BogoslavskiM/okp/АУДИТ_ПРАВОК_ВО.md

# Аудит правок чертежа общего вида

Актуальный отдельный файл: `Чертёж_общего_вида/Чертёж_общего_вида_А1_полный_аудит.pdf`. Исходные пользовательские PDF, STEP и `ТСЧ.docx` не перезаписывались.

## Исправлено

- На одном листе используются разные буквы: А–А, Б–Б, В–В, Д–Д, Е–Е и вид Г.
- Зубчатое колесо поз. 32 убрано из Б–Б; над разрезом дано указание «Зубчатое колесо поз. 32 не показано».
- Д–Д выполнен через второй микропереключатель; разрез опоры рейки сохранён отдельно как Е–Е.
- Посадка `⌀7H7/h6` в Е–Е показана двусторонней размерной линией через цилиндр.
- На В–В убран отдельный тонкий контур, похожий на «сбежавшую резьбу»; зубчатая часть показана единым симметричным контуром.
- На боковом виде точная проекция всех зубьев разрезного выходного колеса заменена условным изображением по ГОСТ 2.402: оставлены контур поверхности выступов, стык половин и тонкие штрихпунктирные образующие начальной поверхности. Чёрная полоса из наложившихся зубьев устранена.
- На Б–Б гайка М8 не заштрихована, а наружная резьба вала показана непрерывными основной и тонкими линиями в зоне свинчивания.
- На Б–Б два наружных стопорных кольца показаны как две пары симметричных отдельно заштрихованных сечений. Каждая верхняя и нижняя площадка относится к одному кольцу, установленному в канавке вала.
- На Б–Б точные торцевые проекции пружин, образовывавшие нечитаемое наложение витков, заменены отдельными сечениями проволоки по ГОСТ 2.401.
- На Б–Б соседний винт М2 показан целиком и условно, без наложения геометрии пружины на головку и резьбовой стержень.
- На Б–Б восстановлена полная штриховка верхней площадки реечной направляющей: общий ребёрный контур STEP делил материал на соприкасающиеся петли и оставлял большую часть площадки белой.
- Обозначения секущей плоскости В–В на А–А вынесены вверх и вниз за механизм, чтобы буквы и стрелки не перекрывали зубья и пружины.
- Наконечники всех стрелок секущих плоскостей А–А, Б–Б, В–В, Д–Д и Е–Е заканчиваются точно на толстом конечном штрихе и не выступают за него.
- На виде Г верхняя буква «Д» вынесена из-под контура детали; положение секущей плоскости Д–Д не изменено.
- Полки поз. 29, 23, 30, 24 и 40 повёрнуты влево вместе с текстом. Полка поз. 41 также направлена влево.
- Выносные линии размеров 40, 127,6 и 256,1 начинаются непосредственно от видимого контура без воздушного зазора.
- Осевые линии приведены к одному начертанию и толщине; короткие перекрестия в центрах зубчатых колёс заменены полноценными осями.
- Основная надпись сохранена в стиле остальных документов проекта.

## Несоответствия исходных данных, которые не исправлялись молча

- В STEP стоят два кольца `A9.50 ХГА ГОСТ 13940-86`; в существующем `ТСЧ.docx` поз. 9 — `Кольцо A6.50 ХГА ГОСТ 13940-86`, 2 шт. Геометрия вала соответствует канавке под А9,5. На чертеже кольцам не присвоена новая позиция.
- В STEP есть гайка `М8-6H ГОСТ 5929-70`; в существующем `ТСЧ.docx` такой детали нет: поз. 8 содержит гайку М6. На ВО гайке М8 не присвоена чужая позиция; поз. 22 остаётся валом VI.
- STEP содержит физическое наложение винта и соседних деталей. На ВО исправлено только его условное изображение; исходная 3D-модель не менялась.
- Позиции на ВО связаны с существующим `ТСЧ.docx`. Нумерация сборочного чертежа редуктора сюда не переносилась, поскольку это другой состав изделия.
- Эта нумерация не совпадает с нумерацией структурной схемы. Например, в `ТСЧ.docx` поз. 11 — подшипник, поз. 22 — вал VI, поз. 45 — крышка выходного вала; в структурной схеме те же номера относятся соответственно к кольцу А9,5, штифту 2×12 и крышке II вала. Смешивать две системы позиций на одном ВО нельзя.
- Количества и типы подшипников тоже расходятся: `ТСЧ.docx` содержит 1000093 — 9 шт. и 1000096 — 1 шт.; STEP содержит 1000093 — 8 шт., 4А-1000007 — 1 шт. и 4А-1000009 — 1 шт.
- Фраза «Зубчатое колесо поз. 32 не показано» относится к нумерации `ТСЧ.docx`. В структурной схеме поз. 32 — гайка М3×0,35.

## Что проверить перед печатью

- Согласовать с преподавателем/нормоконтролем, что в ТСЧ должно быть кольцо А9,5, и добавить в ТСЧ гайку М8 либо привести 3D-модель к утверждённому составу.
- Открыть актуальный PDF и печатать на А1 в масштабе 100 %, без автоматической подгонки.
