BogoslavskiM/okp/ВАЛЫ_ПРИВОДА.md

# Валы привода: от двигателя к рейке

Порядок подтверждён кинематической цепью проекта и сборочной STEP-моделью. Всего шесть вращающихся валов с учётом вала двигателя. Обозначения Z1…Z12 — обозначения элементов передачи, а не номера позиций ТСЧ.

| Вал | Что находится на валу | Откуда получает и куда передаёт движение |
|---|---|---|
| **I — вал двигателя ДПР-42** | Шестерня **Z1**, шпонка, гайка М3×0,35. Собственные опоры вала находятся внутри двигателя. | Двигатель → Z1 → Z2. |
| **II — вал-шестерня Z3** | Колесо **Z2**, шестерня **Z3**, выполненная заодно с валом; два подшипника. | Z2 принимает движение от Z1; Z3 передаёт его колесу Z4. |
| **III — вал-шестерня Z5** | Колесо **Z4**, шестерня **Z5**, выполненная заодно с валом; два подшипника. Опоры размещены в стакане. | Z4 принимает движение от Z3; Z5 передаёт его колесу Z6. |
| **IV — вал-шестерня Z7** | Колесо **Z6**, шестерня **Z7**, выполненная заодно с валом; два подшипника. | Z6 принимает движение от Z5; Z7 передаёт его колесу Z8. |
| **V — вал-шестерня Z9, узел муфты** | Колесо **Z8**; втулка, полумуфты, нажимная пружина, регулировочная гайка и стопорный винт муфты; шпонка; шестерня **Z9**, выполненная заодно с валом; два подшипника. | Z8 получает движение от Z7 и передаёт момент через муфту на вал-шестерню Z9. При перегрузке муфта допускает проскальзывание. Z9 приводит колесо Z10. |
| **VI — выходной вал** | Колесо **Z10 с ЛВК из четырёх пружин**, реечное колесо **Z11 с ЛВК из двух пружин**, два подшипника; штифт, шпонка, стопорное кольцо и концевая гайка крепления элементов выходного узла. | Z10 получает движение от Z9. Z11 превращает вращение в поступательное движение рейки Z12. |

Пять вращательных ступеней: **Z1–Z2 → Z3–Z4 → Z5–Z6 → Z7–Z8 → Z9–Z10**. Затем **Z11–Z12** — реечная передача.

**Z2 и Z3 расположены на одном валу; Z4 и Z5 — на одном; Z6 и Z7 — на одном; Z8 и Z9 связаны через муфту; Z10 и Z11 находятся на выходном валу.**

Крышки подшипников и стакан закреплены в корпусе: их не следует перечислять как детали, вращающиеся вместе с валом. Рейка Z12 — выходное поступательно движущееся звено, а не седьмой вал.
