BogoslavskiM/okp/ПОДГОТОВКА_К_ЗАЩИТЕ_ОКП.md

# Подготовка к защите ОКП: план проекта, ЛВК и муфта

Проект: **следящий привод возвратно-поступательного движения**, РЛ5. Основа разбора — предоставленные чертежи, `ТСЧ.docx` и визуально просмотренная записка [«КП рассчет.pdf»](<КП рассчет.pdf>). Номера страниц ниже — страницы этого PDF, с первой страницы файла. Посадки оставлены как напоминание; основной разбор посвящён принципам работы и расчётам ЛВК и муфты.

Это конспект для понимания и подготовки ответов. Пересчёт всей конструкции и исправление расчётного PDF здесь не выполнены. Числа из записки прямо отделены от перепроверенных результатов. «Когда делали» означает порядок проектирования и зависимости между этапами: календарную историю работы по файлам восстановить нельзя.

## 1. Что повторить перед защитой

Из присланных рассказов повторяются следующие темы. Примерно 30 минут, презентация и видео — опыт одной защиты, а не установленный регламент. Вопросы могут задавать каждому участнику; расчёты тоже нужно понимать, даже если другую команду по ним не спрашивали.

| Тема | Что достаточно восстановить в памяти |
|---|---|
| Работа привода | Путь движения от двигателя до рейки; назначение редуктора, датчика, концевиков, муфты и ЛВК. |
| Посадки | Что соединяется, требуется ли относительное движение, откуда взято поле допуска покупной детали и как выбрано поле сопрягаемой. Уметь изобразить два поля относительно нуля. |
| Подшипники | Какие кольца вращаются относительно нагрузки, как фиксируются кольца и как обеспечивается осевая работоспособность узла. |
| Чертежи | Назначение СБ, ГЧ, К3, структурной схемы; направление взгляда для каждого вида; смысл разрезов и увеличенных изображений. |
| Размеры и биения | Показать конкретную поверхность или ось; объяснить функциональное назначение ограничения и способ контроля. |
| Технология | Как получить основные поверхности валов, зубья, шпоночные пазы, отверстия корпуса; чем обусловлены скругления. |
| Сборка | Какие узлы собираются отдельно, как собираются ЛВК, как регулируется муфта и проверяется свободное движение рейки. |
| Расчёты | Для каждого: исходные данные → проверяемое свойство → результат → принятое конструктивное решение. |

Удобная форма ответа: **«Это …; нужно для …; выбрано потому, что …; проверяем по …»**. Начинай с назначения, затем показывай конкретное место на своём чертеже.

### Короткие ответы на остальные вопросы из переписки

- **Для чего ГЧ?** Чтобы установить изделие в другую конструкцию: он показывает внешний контур, занимаемое пространство, установочные и присоединительные размеры. **СБ** нужен для сборки и контроля сборочной единицы; **ВО** объясняет конструкцию и взаимодействие частей. Это разные задачи документов. [ГОСТ Р 2.102–2023, пп. 4.2.5–4.2.8](https://meganorm.ru/Data/816/81642.pdf).
- **Какие размеры показать у себя?** `256,1 max` — пример габарита при указанном положении подвижных частей; три отверстия `⌀4` на окружности `⌀86` — крепёжный рисунок; `⌀2 N8` на конце рейки относится к выходному присоединению. Для каждого размера показывай обе границы измерения. Одно `N8` ещё не задаёт посадку: нужно поле допуска ответной детали.
- **Что означает ±0,1?** Отклонения составляют −0,1 и +0,1 мм, полный допуск — 0,2 мм. Само число не объясняет, почему его назначили: это определяется требованиями к сопряжению и размерной цепи. На твоём чертеже у размера `5` дважды стоит `+0,2`: это одинаковые предельные размеры, а не запись ±0,2; значение нужно уточнить по замыслу.
- **Вид, разрез, сечение?** Вид показывает обращённые к наблюдателю поверхности; сечение — фигуру в секущей плоскости; разрез также показывает то, что находится за ней. Вынесенный вид читается по стрелке с его буквой. У тебя вид А получается взглядом со стороны выходного конца вдоль оси привода. Увеличение `4:1` помогает показать мелкие сопряжения, численные размеры при этом остаются действительными. [ГОСТ 2.305–2008](https://files.stroyinf.ru/Data/479/47928.pdf).
- **Почему разные значения биения?** Они ограничивают разные функциональные ошибки: посадочная поверхность, зубчатый венец и свободная поверхность имеют разную значимость для работы. Радиальное биение контролируют при вращении относительно заданной базы; это не допуск диаметра. Для идеальной круглой, но эксцентричной поверхности полный размах показаний равен `2e`; при наличии ошибок формы такая упрощённая трактовка уже недостаточна. Вопрос надо привязывать к конкретной рамке допуска и базе. [ГОСТ 24642–81](https://files.stroyinf.ru/Data/221/22152.pdf).
- **Откуда посадка первой шестерни на двигателе?** Размер и допуск покупного вала берутся из документации двигателя, поле отверстия шестерни выбирает конструктор. На с. 10 твоей записки приведён выходной вал ДПР-42 `⌀3 f6`. Это исходное ограничение, но не готовая посадка и не автоматическое указание назначить зазор. Посадка по диаметру и сопряжения шпонки с пазами решаются отдельно.
- **H7/m6 и L0/l0?** H7/m6 — пример переходной посадки; классификацию доказывают взаимным положением полей, а не словами «плотно садится». У `H` нижнее отклонение равно нулю, у `h` верхнее равно нулю. В обозначениях подшипников `L0` относится к среднему диаметру отверстия внутреннего кольца, `l0` — к среднему наружному диаметру; 0 — класс точности подшипника, не квалитет IT0. [ГОСТ 25346–2013](https://rosgosts.ru/17/040/gost_25346-2013), [ГОСТ 3325–85, п. 1.1](https://files.stroyinf.ru/Data2/1/4294824/4294824611.pdf).
- **Подшипник: на вал с натягом, в корпус с зазором?** Для вращающегося вала при нагрузке, неподвижной относительно корпуса, это распространённая схема. Основание — нагрузка перемещается по окружности внутреннего кольца, поэтому нужно предотвратить его проворачивание на посадке. Утверждать, что так делают всегда, нельзя: учитывают нагрузки, температуру, материал корпуса и осевую схему. [SKF: условия вращения и нагружения](https://cdn.skfmediahub.skf.com/api/public/0901d1968024f02a/pdf_preview_medium/0901d1968024f02a_pdf_preview_medium.pdf).
- **Зачем втулка скольжения?** Направляет движущуюся деталь, воспринимает поперечную нагрузку и образует пригодную для трения пару. В твоём Б–Б показано сопряжение рейки `⌀7 H7/h6`. Нужно различать внутреннее сопряжение с подвижной рейкой и наружное крепление втулки в опоре. H7/h6 допускает минимальный зазор 0: само обозначение не доказывает гарантированного свободного скольжения при любых условиях.
- **Что удерживает рейку от проворота?** На Б–Б, «2 места», концы винтов входят в продольный паз рейки. Паз позволяет осевое перемещение и ограничивает вращение. Винт должен направлять, а не зажимать рейку в дно паза. Это видно и на восстановленном сборочном чертеже.
- **Почему шпоночный паз скруглён?** Закруглённый закрытый конец паза на валу обычно получается при работе концевой фрезы: форма связана с диаметром инструмента. Не путать его с малыми радиусами в поперечном сечении. Паз в ступице может изготавливаться другим способом, например долблением или протягиванием; все пазы не обязаны иметь одинаковую форму концов.
- **Как изготовить основные детали?** Для единичного производства объясняй маршрут: вал — точение, получение зубьев/пазов, необходимая термообработка, окончательная обработка точных шеек; колесо — заготовка, базовое отверстие и торцы, нарезание зубьев, требуемая окончательная обработка; корпус — заготовка, обработка баз, связанных отверстий под опоры и резьб. Конкретный материал и маршрут нужно подтвердить своими чертежами деталей: это возможные способы, а не установленный факт изготовления.
- **Какие виды изделий?** Деталь, сборочная единица, комплекс, комплект. «Покупное» и «собственной разработки» — другая классификация. Покупной двигатель одновременно является сборочной единицей. В твоей ТСЧ к покупным отнесены двигатель, подшипники, крепёж, шпонка, штифты, микропереключатели; валы, колёса, корпус и рейка — в разделе вновь разрабатываемых. [ГОСТ Р 2.101–2023, пп. 4.4, 4.6](https://files.stroyinf.ru/Data/816/81640.pdf).
- **«Структурная схема для разборки»?** Для сборки нужно видеть вхождение деталей в узлы, а узлов — в привод, и возможность отдельно собрать выделенные узлы. Стрелки направляют к изделию вышестоящего уровня. Это не замена подробному технологическому маршруту сборки. [ГОСТ Р 2.711–2023, п. 5.3](https://meganorm.ru/Data/816/81671.pdf).
- **Технические требования?** Свяжи каждый пункт с проверкой: ход — перемещение между установленными пределами; усилие и скорость — работа под заданной нагрузкой; точность — оговорённая выходная погрешность; концевики — отключение перед механическим упором; хранение и транспортирование — сохранность изделия. `УХЛ4.1` означает исполнение для умеренного и холодного климата с эксплуатацией в помещениях с кондиционированным или частично кондиционированным воздухом. IP44 задаёт защиту от доступа проволокой/твёрдых предметов размером 1 мм и более и от брызг с любого направления. Наличие этих обозначений в ТЗ не доказывает, что конструкция уже прошла необходимые проверки. [ГОСТ 15150–69](https://files.stroyinf.ru/Data2/1/4294852/4294852592.htm), [ГОСТ 14254–2015](https://base.garant.ru/71653666/).

## 2. Весь проект: что, когда и зачем рассчитывали

### Как описать привод за минуту

По ТЗ требуется перемещать нагрузку 1 кг с сопротивлением 8 Н, скоростью 0,03 м/с, ускорением 1 м/с² и ходом 60 мм. Вращение двигателя ДПР42-01 понижается пятью цилиндрическими зубчатыми парами и через реечную передачу превращается в поступательное движение. Муфта ограничивает передаваемый момент при перегрузке. ЛВК уменьшают мёртвый ход при реверсе. Рейка движется в направляющих и удерживается от проворота пазом с винтами. На кинематической схеме также предусмотрены датчик линейного перемещения, концевые выключатели и механические упоры.

«Следящий» означает наличие обратной связи: измеренное положение сравнивается с заданным и по ошибке формируется воздействие на двигатель. Один двигатель с редуктором сам по себе следящую систему не образует; алгоритм управления нельзя считать разработанным только по механической схеме.

### Последовательность и смысл каждого блока записки

| Этап и страницы PDF | Что делали и зачем | Что получилось / что нужно уметь объяснить |
|---|---|---|
| 1. ТЗ, с. 3 | Собрали требования: нагрузка, скорость, ускорение, ход, точность, ограничения конструкции. | Это критерии всех следующих проверок. В ТЗ допустимая погрешность **30′**, а не 25′. |
| 2. Мощность, с. 4 | Оценили механическую мощность `P=(F+ma)v`, затем учли КПД и запас. | На выходе 0,27 Вт; при предварительном КПД 0,42 — около 0,64 Вт на входе; с коэффициентом 4 — 2,56 Вт. Запас и КПД нужно обосновать, это разные множители. |
| 3. Предварительный двигатель, с. 4–6 | Сравнили доступные исполнения, затем проверили способность разогнать механизм. | ДПР42-02 прошёл по мощности, но по записке не прошёл пуск: 0,022 Н·м меньше потребных примерно 0,0275 Н·м. |
| 4. Повторный выбор, с. 7–9 | После замены двигателя пересчитали кинематику и приведённые нагрузки. | ДПР42-01: 27 В, 9000 об/мин, номинальный момент 0,005 Н·м, пусковой 0,036 Н·м, номинальная механическая мощность около 4,71 Вт. Первая пусковая проверка даёт лишь небольшой запас. |
| 5. Общее передаточное отношение, с. 5, 7 | Из скорости рейки получили скорость выходного колеса: `ωвых=v/r`; затем `i=ωдв/ωвых`. | При делительном диаметре 45 мм: `r=0,0225 м`, `ωвых≈1,333 рад/с`, `i≈706,858`. Повтор расчёта связан с заменой двигателя. |
| 6. Приведение моментов и инерций, с. 5–8 | Перенесли нагрузку к валу двигателя. Статический момент связан с сопротивлением, динамический — с разгоном всех масс. | `Mст,дв≈Mвых/(iη)`, `Jнагрузки=m r²`, `Jпр≈Jдв+Jред,пр+Jнагрузки/i²`, `Mдин=Jпр εдв`, `εдв=i εвых`. Большое i уменьшает приведённую инерцию нагрузки, но увеличивает нужное ускорение ротора. |
| 7. Габариты двигателя, с. 10–11 | Выбрали конструктивное исполнение, посадочные и крепёжные размеры. | Покупной двигатель задаёт геометрию сопряжения, в том числе вал ⌀3 f6. Далее проектируем ответные детали. |
| 8. Ступени и зубья, с. 12–13 | Разбили большое i на пять приемлемых ступеней с учётом компактности; подобрали целые числа зубьев. | Шестерни 1, 3, 5, 7, 9: по 19 зубьев; колёса 2, 4, 6, 8, 10: 67, 68, 69, 70, 80. После округления пересчитываем фактическое i и скорость. |
| 9. Моменты по валам, с. 14 и далее | От выходной нагрузки с учётом потерь определили нагружение каждой ступени. | В записке для VI принято 382,5 Н·мм, для V — 93,62 Н·мм, затем 26,09; 7,37; 2,11; 0,61 Н·мм. Это расчётная цепочка, а не каталог номинальных моментов двигателя. |
| 10. Материал, модуль, ширина, с. 14–23 | По допускаемому напряжению изгиба зуба нашли минимальный модуль; затем выбрали реализуемый размер и ширину венцов. | Приняты модули 0,35; 0,3; 0,3; 0,3; 0,35 мм. Маленький модуль может проходить по прочности, но не оставлять стенку у отверстия/паза. Материалы в расчёте: шестерни 40Х, колёса сталь 55. |
| 11. Геометрия колёс, с. 14–23 | По m и z определили делительные, наружные и впадинные диаметры, ширины. | `d=mz`; для принятого профиля вычисляются остальные диаметры. Геометрия задаёт межосевые расстояния, компоновку и силы в зацеплениях. |
| 12. Контактная прочность, с. 24 | Проверили контактные напряжения рабочих поверхностей зубьев. | Изгиб отвечает за опасность разрушения зуба у основания, контактная проверка — за работоспособность его поверхности. Прохождение одной не заменяет другую. |
| 13. Уточнение КПД, инерций и двигателя, с. 25–28 | Когда размеры колёс известны, оценили их инерции, реальные потери и повторили динамическую проверку. | Для дисковой оценки `J=πρbd⁴/32`; к двигателю инерция приводится делением на квадрат накопленного i. Полученный КПД зацеплений около 0,821 не следует автоматически считать КПД всего привода. В результате динамической проверки есть ошибка единиц — см. раздел 5. |
| 14. Валы по жёсткости, с. 29–40 | Ограничили закручивание валов. | `φ=T l/(G Jp)`, для сплошного круга `Jp=πd⁴/32`. Жёсткость сильно растёт с диаметром; достаточная прочность ещё не обеспечивает точность. |
| 15. Валы по прочности, с. 29–40 | Из моментов нашли `Ft=2T/d`, `Fr=Ft·tan α`; определили реакции опор, построили эпюры в двух плоскостях, сложили изгиб и кручение. | Проверяются наиболее нагруженные сечения. Для прямозубой цилиндрической пары идеализированная осевая составляющая от зацепления равна нулю. Реальный диаметр также зависит от посадок и компоновки. |
| 16. Прогиб вала, с. 40–41 | Оценили поперечную деформацию и её влияние на зацепление. | Использованы единичная нагрузка и интеграл Мора/перемножение эпюр. В записке суммарный прогиб около 0,000154 мм сравнивается с 0,02485 мм. Это другая проверка, чем угол кручения. |
| 17. Опоры, с. 41–49 | По реакциям нашли эквивалентную нагрузку и требуемую динамическую грузоподъёмность подшипников. | Для шарикового подшипника базовая зависимость `L10h=10⁶/(60n)·(C/P)³`. Здесь n — частота именно этого вала. Затем проверяются размеры, схема фиксации и остальные условия применения. |
| 18. Точность, с. 50–58 | Сложили приведённые к выходу ошибки изготовления/монтажа, люфтовую и упругую составляющие. | Исходный итог в записке около 42′ — выше 30′ из ТЗ. Поздние ступени особенно значимы: их ошибки почти не уменьшаются последующим редуцированием. |
| 19. Улучшение точности, с. 58 | Выбрали меры против разных причин ошибки. | ЛВК на последней цилиндрической и реечной передачах уменьшают люфт; увеличение выходного вала с 6 до 9 мм уменьшает закручивание. Это два разных решения. Итоговые числа в записке расходятся. |
| 20. ЛВК, с. 59–65 | Из требуемого момента предварительного поджатия получили усилия пружин, затем их деформации, жёсткость, витки и габариты; повторили контактную проверку. | Два ЛВК: реечное колесо №11 с двумя пружинами и колесо №10 с четырьмя. Подробно — следующий раздел. |
| 21. Муфта, с. 66–69 | Выбрали ограничиваемый момент, прижим, пружину и размеры фрикционного контакта; проверили давление и передаваемый момент. | Сначала нужно знать момент на валу установки и режим защиты. Именно этот исходный выбор в записке требует исправления. |
| 22. Конструкция и документация | По результатам компонуем узлы, назначаем сопряжения, определяем сборку, создаём чертежи и согласуем состав. | После добавления ЛВК и муфты возвращаемся к нагрузкам, потерям, габаритам и точности. Расчёт и конструкция уточняются совместно. |

Опорная фраза: **«Сначала обеспечили движение и нагрузочную способность, затем проверили точность; по её результатам добавили ЛВК и увеличили жёсткость выходного вала. Муфта решает отдельную задачу защиты от перегрузки».**

## 3. ЛВК: что происходит физически

### 3.1. Почему возникает мёртвый ход

В обычном зацеплении между неработающими боковыми поверхностями зубьев есть боковой зазор. Пока привод вращается в одну сторону, нагрузку передают одни стороны зубьев. После реверса сначала выбирается зазор до контакта противоположных сторон; вход уже повернулся, а выход ещё не начал соответствующее движение. Для следящего привода это ухудшает позиционирование при смене направления.

Люфтовыбирающее колесо состоит из двух соосных зубчатых частей, между которыми допускается небольшой относительный поворот. Пружины создают противоположно направленные моменты: одна часть прижата к одной стороне зубьев ответного колеса или рейки, вторая — к противоположной. При достаточном поджатии свободный ход при реверсе уменьшается. Такой принцип двух подпружиненных частей применяют и серийные изготовители. [KG Stock Gears: устройство anti-backlash spur gears](https://www.kggear.co.jp/en/kg-stock-gears/anti-backlash-spur-gears).

**Пружина должна быть предварительно деформирована.** Если собрать части в свободном положении без нужного поджатия, расчётный момент не появится. Важны направление относительного поворота, рабочая длина пружины и возможность подвижной части поворачиваться: затяжкой осевого крепежа нельзя случайно зажать её намертво.

В твоём проекте ЛВК предусмотрены на колесе **№10** последней цилиндрической пары и колесе **№11**, работающем с рейкой. Они воздействуют на зазоры соответствующих зацеплений. Ошибки шага, биение, закручивание валов и люфты остальных ступеней при этом не исчезают.

### 3.2. Почему нельзя просто поставить очень сильные пружины

Два требования противодействуют друг другу:

- момент поджатия должен сохранять нужный контакт при рабочем моменте и его изменении;
- лишний преднатяг увеличивает внутренние контактные нагрузки, трение, износ и потребный момент двигателя.

В записке выбрано `Mпред=2T`. Это принятый коэффициент запаса, а не универсальное требование ГОСТ для любого ЛВК. Его нужно связывать с максимальным рабочим моментом, реверсом, изменением усилия пружин и геометрией данного механизма.

При росте внешнего момента одна ветвь контакта догружается, другая разгружается. Если разгружаемый контакт исчезает, способность выбирать люфт в этом режиме теряется. Поэтому фраза «поставили пружины — люфта больше нет» слишком сильная.

### 3.3. Логика твоего расчёта ЛВК

Обозначения ниже немного упорядочены: `N` — число пружин, `q` — число зубьев монтажного смещения, `n` — рабочие витки одной пружины. В записке буква n применяется в разных смыслах.

**Шаг 1. Взять момент на валу этого колеса.** Для обоих ЛВК в записке используется `T=382,5 Н·мм`, поскольку оба относятся к выходному валу VI. Выбранный момент поджатия `Mпред=2T=765 Н·мм`.

**Шаг 2. Задать расположение пружин и монтажный поворот.** В расчётной геометрии A — положение пружины относительно центра колеса, L — исходная длина, θ — половина взаимного угла поворота частей:

```text
φ = 360°·q/z
θ = φ/2
A₁ = A·cos θ − (L/2)·sin θ
```

`A₁` — действующее плечо силы после поворота. Оно изменяется, поскольку линия действия пружины перемещается. «Смещение на два зуба» здесь задаёт монтажный поворот для создания преднатяга, а не величину рабочего люфта в два зуба.

**Шаг 3. Разделить нужный момент между пружинами.** Для принятого симметричного расположения:

```text
Mпред = N·P·A₁
P = Mпред/(N·A₁)
```

Это обычное равновесие моментов: сила каждой пружины умножается на её плечо. Если конструкция размещает пружины иначе, нужно заново получить плечи и сумму моментов.

**Шаг 4. Из геометрии получить удлинение.** В использованной в записке схеме:

```text
Δl = L·cos θ + 2A·sin θ − L
```

После этого нужна пружина, которая при таком удлинении создаёт найденную силу: `k=P/Δl`. Это упрощение предполагает отсутствие начального натяжения. Для пружины растяжения с начальным натяжением закон имеет вид `P=P₀+kΔl`; тогда P₀ тоже надо учитывать. Также L в геометрии и свободная длина реальной пружины между точками крепления должны быть согласованы.

**Шаг 5. Выбрать проволоку, диаметр витка и число витков.** В записке выбирается строка таблицы с допустимым усилием, диаметром проволоки, наружным диаметром пружины и жёсткостью одного витка `c₁`. Затем `n=c₁/k`. Больше одинаковых рабочих витков — более мягкая пружина. После округления n необходимо заново вычислить действительную силу, а не оставлять прежнюю.

**Шаг 6. Проверить размещение и прочность.** Нужны место для пружины с зацепами во всём рабочем диапазоне, отсутствие столкновений и заклинивания, прочность зацепов и зубьев, достаточная ширина частей колеса. Условие «полная длина меньше диаметра впадин» само по себе ещё не доказывает размещение в конкретной прорези.

### 3.4. Два твоих ЛВК: откуда получились числа

| Параметр | Колесо №11, реечная передача | Колесо №10, последняя цилиндрическая пара |
|---|---:|---:|
| Число зубьев z | 90 | 80 |
| Число пружин N | 2 | 4 |
| A; L | 12; 20 мм | 9,5; 12 мм |
| Монтажное смещение q | 2 зуба | 2 зуба |
| Половина угла θ | 4° | 4,5° |
| Действующее плечо A₁ | ≈11,273 мм | ≈9,000 мм |
| Требуемая сила одной пружины | ≈33,93 Н | ≈21,25 Н |
| Принятая табличная сила при максимальной деформации | 40 Н | 25 Н |
| Проволока; наружный диаметр | 0,8; 5 мм | 0,6; 3,4 мм |
| Жёсткость одного витка c₁ | 54,24 Н/мм | 57,92 Н/мм |

Почему четыре пружины у №10: в записке прямо указано, что при двух или трёх требуемые более сильные пружины не помещаются. Четыре пружины распределяют момент и снижают требуемую силу каждой. Само увеличение количества не отменяет проверку места и прочности.

**У колеса №11** геометрия даёт `Δl≈1,6254 мм`, откуда `k≈20,875 Н/мм`, `n≈2,598`, принято 3 рабочих витка. После такого округления фактическая жёсткость по той же модели — `54,24/3=18,08 Н/мм`. При том же удлинении сила около **29,39 Н**, а момент поджатия около **662,6 Н·мм**, то есть **1,73T**, а не 2T. Это ещё может соответствовать принятому диапазону запаса, но вывод должен опираться на пересчитанный результат.

**У колеса №10 есть конкретная ошибка на с. 64:** перед этим получено θ=4,5°, а удлинение вычисляется с **8°**. Поэтому записанные `Δl=2,52751 мм`, `k=8,40752 Н/мм` и 7 витков не согласованы с собственной исходной геометрией.

При θ=4,5° и остальных неизменных исходных данных:

```text
Δl = 12 cos 4,5° + 19 sin 4,5° − 12 ≈ 1,45373 мм
k = 21,2501/1,45373 ≈ 14,62 Н/мм
n = 57,92/14,62 ≈ 3,96
```

То есть эта расчётная модель приводит примерно к **4**, а не 7 виткам. Если оставить 7 при той же геометрии и без начального натяжения, момент получится около **433 Н·мм ≈1,13T**. Это проверка согласованности формул, **не готовое предписание заменить пружину**: сначала необходимо согласовать длину между зацепами, начальное натяжение и реальную конструкцию.

### 3.5. Как объяснить сборку ЛВК

На уровне принципа: установить две соосные части, обеспечить предусмотренную относительную подвижность, закрепить пружины, повернуть части в направлении создания заданного преднатяга, удержать их при вводе в зацепление, зафиксировать осевое положение без блокирования нужного относительного поворота. Затем проверить свободное движение и реверс под оговорённой нагрузкой.

На защите нужно показать, **какая часть связана с валом, какая подвижна, за что зацеплены пружины и чем удерживается осевое положение**. Конкретный порядок установки крепежа определяется сборочной моделью; из одной расчётной схемы его нельзя достоверно назначить.

### 3.6. Готовый ответ про ЛВК

«При реверсе обычная передача сначала выбирает боковой зазор. У нас колесо разделено на две подпружиненные части, которые поджаты к противоположным сторонам зубьев ответной детали. Расчёт начинается с момента поджатия, затем через число пружин и их плечи получаем усилия. По монтажному повороту определяем удлинение, после чего выбираем жёсткость и число витков. После округления витков проверяем действительный преднатяг и размещение. ЛВК уменьшает люфтовую составляющую, но не устраняет ошибки изготовления и упругие деформации».

## 4. Муфта: принцип и расчёт

### 4.1. Сначала нужно установить, какая муфта действительно спроектирована

В ТЗ и формулах на с. 66–69 — **фрикционная предохранительная муфта**. На кинематической схеме подпись — **«шариковая предохранительная муфта»**. Иллюстрация на с. 68 тоже требует проверки по конструкции: название под рисунком само по себе не подтверждает, что момент передаётся рассчитанными фрикционными поверхностями.

Дальнейший разбор относится к **фрикционному принципу, который рассчитан в записке**. Для шариковой муфты нужны геометрия углублений/рабочих поверхностей и силы выхода шариков; формула фрикционного диска не описывает этот механизм.

### 4.2. Как работает фрикционная предохранительная муфта

Есть ведущая и ведомая части и прижатые друг к другу рабочие поверхности. Пружина создаёт нормальную силу. Пока требуемый момент меньше предельного момента трения, поверхности не скользят друг относительно друга и передают движение совместно. При перегрузке начинается относительное проскальзывание, которое ограничивает передаваемый момент. Регулировка сжатия пружины меняет порог. [Mach III: принцип механического фрикционного ограничителя момента](https://www.machiii.com/resources/how-our-products-work/how-it-works-mechanical-friction-torque-limiter/).

**Муфта не обязана полностью разомкнуться и передать нулевой момент.** При проскальзывании она продолжает передавать момент трения и выделяет тепло. Поэтому упор нельзя использовать как штатный способ остановки с длительно буксующей муфтой. Концевики должны обеспечивать нормальную остановку, а муфта — ограничение перегрузки при нарушении нормального режима.

Что делают детали в общем случае:

| Элемент | Назначение |
|---|---|
| Ведущая и ведомая части | Связаны с соответствующими звеньями привода и передают момент до и после фрикционного контакта. |
| Фрикционные поверхности/накладки | Создают ограниченный силой прижатия момент трения. |
| Нажимная деталь | Передаёт осевое усилие пружины на контакт. |
| Пружина | Создаёт прижим и допускает его изменение при регулировке и износе. |
| Регулировочная гайка или другой механизм | Задаёт установленную длину пружины, следовательно, силу и момент срабатывания. |
| Стопорение регулировки | Сохраняет настройку при работе. |
| Опорные и центрирующие элементы | Обеспечивают взаимное положение частей и возможность предусмотренного относительного вращения. |

Это функциональное объяснение. Номера деталей следует брать из чертежа именно твоей муфты, а не присваивать по типовой картинке.

### 4.3. Первый расчёт — выбрать момент в месте установки

Правильная последовательность:

```text
нагрузка на рейке
→ момент на выходном валу
→ момент на валу установки муфты
→ допустимое окно срабатывания
→ необходимый прижим
→ пружина и контактные поверхности
```

Нужно обеспечить, с учётом разброса настройки:

```text
максимальный нормальный рабочий момент
< момент срабатывания
< момент, опасный для защищаемых деталей
```

Все три величины приводятся к **одному валу**. Если момент известен после редукции, при приведении назад учитываются передаточное отношение, направление передачи мощности и потери. Нельзя сравнивать число с вала двигателя с числом на выходе без приведения.

**В твоей записке:** взято `Mдв=0,036 Н·м`, умножено на 1,8 и получено `Mмуфты=64,8 Н·мм`. Но 0,036 Н·м — **пусковой** момент двигателя, а на кинематической схеме муфта стоит на **валу V**, между колесом №8 и шестернёй №9. Для V в расчётной цепочке записано **93,62 Н·мм**, что уже больше выбранного порога 64,8 Н·мм.

Это не доказательство, что привод проскальзывает при любой обычной нагрузке: расчётные режимы и запасы ещё нужно согласовать. Но выбранный порог **не обоснован для принятого в записке расчётного момента в месте установки**. Начинать исправление следует отсюда, иначе точный подбор пружины будет обслуживать неверное исходное условие.

### 4.4. От момента к силе прижатия

Используется модель:

```text
M = μ·F·Rср·z
```

`μ` — коэффициент трения выбранной пары поверхностей; `F` — нормальная сила прижатия; `Rср` — эффективный радиус трения; `z` — число работающих поверхностей трения, **не число зубьев**.

Физический смысл: трение даёт окружную силу `μF`, её плечо даёт момент, несколько рабочих контактов суммируют моменты. При последовательном осевом сжатии пакета одинаковая сила F проходит через контакты; множитель z нельзя одновременно повторно учитывать в самой F.

В записке приняты `μ=0,25`, `Rср=6 мм`, `z=2`:

```text
F = 64,8/(0,25·6·2) = 21,6 Н → принято 22 Н
M при F=22 Н = 0,25·22·6·2 = 66 Н·мм = 0,066 Н·м
```

Это арифметически согласовано с выбранными 64,8 Н·мм. **На с. 69 результат ошибочно записан как 66 Н·м — разница в 1000 раз.**

Числа μ=0,25 и z=2 нужно объяснить по реальному контакту: из каких материалов поверхности, сухие они или смазываемые и где именно находятся обе поверхности трения. Указать произвольное μ без материала недостаточно.

### 4.5. Зачем рассчитывают кольцо и давление

В записке внутренний диаметр кольца 8 мм, наружный 16 мм, ширина 4 мм. Использована оценка `Rср=(D+d)/4=6 мм`, соответствующая модели равномерного износа кольцевого контакта. При иной модели распределения давления эффективный радиус определяется иначе; это допущение, а не геометрическое тождество для любого фрикционного контакта.

```text
A = π(D²−d²)/4 ≈ 150,8 мм²
pср = F/A ≈ 22/150,8 ≈ 0,146 МПа
```

Эта проверка отвечает на вопрос, не слишком ли велика нагрузка на поверхность. В записке допускается 0,3–0,6 МПа, но допустимое значение должно соответствовать материалу и условиям работы. Среднее давление само по себе не проверяет местные концентрации, нагрев и ресурс при буксовании.

Почему нельзя просто увеличить площадь и считать момент пропорционально выросшим: при неизменных F, μ и эффективном радиусе площадь напрямую в формулу момента не входит. Она уменьшает среднее давление; увеличение наружного диаметра дополнительно меняет радиус трения.

### 4.6. Зачем пружине три силы P₁, P₂, P₃

На с. 66 приняты:

```text
P₁ = 22 Н
P₂ = 1,5P₁ = 33 Н
P₃ = P₂/(1−0,05) ≈ 34,74 Н
```

Это попытка задать диапазон рабочих усилий и запас до предельной деформации. Но пружина в собранной муфте создаёт **одну силу, определяемую установленной длиной**. Нельзя одновременно считать порог по 22 Н и установить сжатие, дающее 33 Н, не изменив порог:

```text
при 22 Н: M ≈ 66 Н·мм
при 33 Н: M ≈ 99 Н·мм
```

Поэтому нужно указать длину пружины при настройке, соответствующий момент и допускаемое изменение при износе. Износ фрикционных деталей может изменить установленную длину и прижим; фраза «коэффициент 1,5 компенсирует износ» без этой связи недостаточна.

### 4.7. Что означает каждый шаг расчёта пружины муфты

1. **Материал и допускаемое напряжение.** В записке — 65Г, `[τ]=583,3 МПа`. Это ограничение напряжений проволоки; состояние материала и допустимый режим должны соответствовать принятому справочному значению.
2. **Индекс пружины `C=Dср/d=6`.** Связывает средний диаметр витка с толщиной проволоки. Нельзя подставлять наружный диаметр вместо среднего.
3. **Коэффициент кривизны.** Учитывает, что напряжение в изогнутой проволоке выше простой оценки прямого стержня. В записке `kτ≈1,238`.
4. **Диаметр проволоки.** Подбирается по максимальной расчётной силе, чтобы не превысить допускаемое напряжение. При осевом сжатии цилиндрической винтовой пружины её проволока работает преимущественно на **кручение**, а не просто на осевое сжатие.
5. **Средний диаметр.** После принятия `d=1,2 мм` получается `Dср=7,2 мм`; наружный диаметр тогда 8,4 мм, внутренний 6 мм. Это нужно для размещения в корпусе или на направляющей.
6. **Податливость одного витка.** `λ=8C³/(Gd)≈0,0173 мм/Н`. Податливость показывает, насколько удлиняется/укорачивается один активный виток на единицу силы. Жёсткость — обратная величина; у нескольких витков податливости складываются.
7. **Число рабочих витков.** По заданному перемещению между двумя нагрузками: `n=Δs/[λ(P₂−P₁)]`. Для 2 мм между 22 и 33 Н получается около 10,5, принято 11.
8. **Полное число витков.** Добавлены опорные витки: `nпол=13`. Рабочие витки определяют упругую характеристику, полное число — ещё и габариты.
9. **Длины и предельное сжатие.** В записке получены высота сомкнутых витков 15,6 мм и свободная длина 22,21 мм. Нужно проверить установленную длину, запас между витками при максимальной рабочей нагрузке и отсутствие потери устойчивости. Совпадение максимальной рабочей деформации с полным смыканием витков требует пересмотра.

**Ошибка формулы на с. 67:** при заданном безразмерном C под корнем стоят величины с размерностью мм², но напечатан кубический корень. Для классической модели `τ≈k·8FDср/(πd³)` подстановка `Dср=Cd` даёт **квадратный** корень по d. Кроме того, напечатанное выражение с коэффициентом 1,6 и кубическим корнем не даёт указанного результата 1,12 мм. Нужно проверить и степень корня, и коэффициент выбранной методики. Принятые 1,2 мм нельзя объявить неверными только по этой опечатке: их следует проверить обратной подстановкой в корректную формулу.

### 4.8. Как регулируют и проверяют такую муфту

Собирают фактический пакет рабочих поверхностей и пружину; регулировкой задают её установленную длину; измеряют момент начала относительного проворота в оговорённых условиях; фиксируют регулировку и проверяют повторяемость. При необходимости проверяют оба направления вращения и нагрев при допустимом кратковременном проскальзывании. Конкретный способ приложения и измерения момента выбирается по доступу к узлу.

Проверка только свободной длины пружины не подтверждает настройку муфты: момент зависит также от её установленного сжатия, трения, контактного радиуса и количества поверхностей.

### 4.9. Готовый ответ про муфту

«Предохранительная фрикционная муфта ограничивает момент при перегрузке. Пружина прижимает рабочие поверхности; до порога они передают движение без взаимного скольжения, выше порога начинают проскальзывать. Сначала выбираем момент срабатывания на валу установки: выше нормального рабочего и ниже опасного для защищаемых деталей. Затем по коэффициенту трения, радиусу и числу контактов находим прижим, под него выбираем пружину и проверяем давление. Настройка определяется установленным сжатием пружины и проверяется измерением момента».

## 5. Что нельзя заучивать из записки без исправления

| Где | Что обнаружено | Почему это существенно |
|---|---|---|
| К3 и с. 66–69 | Шариковая муфта на схеме, фрикционная в ТЗ и формулах. | Разные принципы передачи и ограничения момента; сначала согласовать реальную конструкцию. |
| С. 66 | Порог муфты рассчитан от пускового момента двигателя, хотя она на V валу. | Требуется согласовать режим и привести моменты к месту установки. |
| С. 69 | 66 Н·м вместо 66 Н·мм. | Ошибка единиц в 1000 раз. |
| С. 67–68 | Несогласованные корень, коэффициент и результат диаметра проволоки; максимальная расчётная деформация доведена до высоты сомкнутых витков. | Нужна проверка прочности и рабочего запаса хода пружины. |
| С. 62–64 | Для ЛВК №10 половина угла 4,5°, затем в формуле 8°. | Меняются удлинение, жёсткость, число витков и реальный преднатяг. |
| С. 61, 64–65 | После округления рабочих витков сила не пересчитана; длины геометрической модели и пружины с зацепами не согласованы явно. | Нельзя считать расчётный момент поджатия обеспеченным по одной исходной формуле. На с. 61 также `4,4+2·5` не равно 15,2. |
| С. 13 | Фактическое i считается с округлёнными промежуточными отношениями. | По целым зубьям произведение равно **710,97254**, отличие от требуемого около **0,582%**; при 9000 об/мин скорость рейки около **0,029826 м/с**. Это отличие скорости, не угловая погрешность передачи в минутах. |
| С. 24, 65 | Межосевое расстояние 18,025 мм получено из наружных диаметров. | Для пары 9–10 без смещения профилей из делительных диаметров получается **17,325 мм**; именно это значение встречается далее в записке. Требуется единая геометрия и соответствующая проверка. |
| С. 27–28 | Динамический момент из SI-величин около **0,0198 Н·м**, но подписан 0,02 Н·мм. | При добавлении к 3,6 Н·мм получается около **23,4 Н·мм**, а не 3,62. Сравнение с 5 Н·мм номинального момента больше не проходит. С пусковыми 36 Н·мм сравнивается пуск, а возможность заданного разгона во всём диапазоне проверяется по характеристике двигателя. |
| С. 27 | Для колеса №10 дисковая формула с указанными размерами даёт `J≈1,326·10⁻⁶ кг·м²`, написано `1,33·10⁻⁷`. | Ещё одна степень десяти; уточнить итоговую приведённую инерцию. Это не отменяет уже найденной ошибки единиц момента. |
| С. 41–49 и ТСЧ | При проверке разных валов используется 9000 об/мин; марки подшипников в таблице и ТСЧ расходятся. | Частота VI вала по зубьям около 12,66 об/мин. В ТСЧ указаны 1000093 и 1000096; на с. 49 для VI — 1000007 и 1000009. Нужен один согласованный состав. |
| С. 50, 59, К3 | Разные m/z реечной передачи и число зубьев рейки. | На с. 59 колесо 90 зубьев, m=0,5; на с. 50 встречается m=1 и 45 зубьев. Для рейки на К3 — 58, в расчёте — 80. Согласовать с моделью и длиной рабочего участка. |
| С. 57–58 | Несколько различных итогов погрешности; используется предел 25′ при 30′ в ТЗ. | Прямая сумма приведённых на с. 58 составляющих `16,74046+4,4749+2,88682≈24,10218′`. Это исправление сложения, не подтверждение всего расчёта точности: нужно проверить исходные составляющие и охват реечной передачи. |

Эти замечания не требуют учить дополнительные десятки формул. Для защиты важнее понимать, **какое свойство проверял каждый расчёт, какие допущения приняты и какое изменение конструкции из него следует**. Но ошибки в типе муфты, моменте, единицах и угле ЛВК лучше устранить до защиты, а не пытаться защищать их как верные результаты.

## 6. Порядок подготовки без повторного изучения всего курса

1. **15–20 минут — восстановить конструкцию.** Открыть К3 и СБ, пройти путь движения, показать V и VI валы, оба ЛВК, муфту, рейку, её паз, датчик и концевики.
2. **20–30 минут — пройти таблицу расчётов из раздела 2.** Для каждого этапа вслух назвать входные данные, смысл проверки и конструктивный результат. Формулы вспоминать по необходимости.
3. **30–40 минут — ЛВК, с. 58–65.** Нарисовать две соосные части от руки, объяснить реверс и предварительное поджатие; пройти цепочку «момент → плечо и сила → удлинение → жёсткость → витки → повторная проверка».
4. **30–40 минут — муфта, с. 66–69.** Установить реальный тип; объяснить путь момента и прижима; пройти цепочку «порог на своём валу → нормальная сила → пружина → давление → настройка и контроль».
5. **10–15 минут — посадки и чертежи по памяти.** Пройти краткие вопросы первого раздела. Если ответ вспоминается, дальше тему не углублять.
6. **15 минут — прогон в команде.** Каждый объясняет весь привод и оба специальных узла, затем отвечает на два уточнения: «почему именно так?» и «что изменится, если увеличить этот параметр?».

Пять вопросов, которые полезно задать себе в конце:

- Почему более толстый вал помог точности, хотя старый мог проходить по прочности?
- Почему добавление ЛВК требует повторно учитывать нагрузки и потери?
- Почему семь витков вместо четырёх меняют усилие, даже если проволока та же?
- Почему пружина на 33 Н не соответствует моменту муфты, рассчитанному по 22 Н?
- Почему 0,036 Н·м на двигателе нельзя непосредственно использовать как рабочий момент муфты на V валу?
