BogoslavskiM/okp/СПИСОК_ИСПРАВЛЕНИЙ_ОКП.md

# Список исправлений курсового проекта по ОКП, РЛ5

Проект: **«Следящий привод возвратно-поступательного движения»**.

Чек-лист составлен по визуальной проверке предоставленных PDF, проверке свойств добавленных CDW, пособиям МГТУ и указанным ниже стандартам. CDW в КОМПАСе не открывались и не редактировались; замечания к изображениям необходимо сверить с их последним состоянием в КОМПАСе. Это проверка оформления и согласованности комплекта, а не полный повторный расчёт конструкции.

## 1. Обозначения и основные надписи — исправить во всём комплекте

- [ ] По принятому решению использовать для привода обозначение **`РЛ5.00.00.00.00`**: первую числовую группу после РЛ5 заменить на `00` во всём комплекте. Это выбранное обозначение проекта, а не подтверждённый номер темы задания.
- [ ] Заменить заглушки `БИГЕ.XXXXXXXX…` на принятые обозначения. Заглушки сохранились и в свойствах добавленных сборочного и габаритного CDW.
- [ ] Заполнить обозначения структурной и кинематической схем.
- [ ] В основной надписи указывать **название изделия и ниже название документа**. Код СБ, ГЧ, К3 или Е1 в обозначении не заменяет название документа.
- [ ] Проверить совпадение обозначений в основной надписи, дополнительной графе и разделе «Документация» спецификации.

| Документ на привод в целом | Обозначение | Название документа под названием изделия |
|---|---|---|
| Сборочный чертёж | `РЛ5.00.00.00.00 СБ` | Сборочный чертёж |
| Габаритный чертёж | `РЛ5.00.00.00.00 ГЧ` | Габаритный чертёж |
| Кинематическая схема | `РЛ5.00.00.00.00 К3` | Схема кинематическая принципиальная |
| Структурная схема | `РЛ5.00.00.00.00 Е1` | Структурная схема |
| Спецификация привода | `РЛ5.00.00.00.00` | В основной надписи — название изделия, без «Сборочный чертёж» |
| Чертёж общего вида, если входит в комплект | `РЛ5.00.00.00.00 ВО` | Чертёж общего вида |

**Не присваивать обозначение целого привода всем узлам и деталям.** Например, если за редуктором закреплено `РЛ5.00.01.00.00`, его сборочный чертёж имеет обозначение `РЛ5.00.01.00.00 СБ`, а спецификация — `РЛ5.00.01.00.00`.

По решению автора сохранено исходное название **«Структурная схема»**, как в образце пособия МГТУ 2012 года, с. 13, рис. П1.6; код — **Е1**. То же название указано в разделе «Документация» спецификации. Ранее предложенное название «Схема деления структурная» соответствует терминологии ГОСТ 2.701–2008, п. 4.4, но его замена в данном курсовом проекте не была прямым требованием преподавателя. В образце пособия 2022 года, с. 29, рис. П1.13, используется ещё один вариант — «Схема сборки», также с кодом Е1.

## 2. Структурная схема — исправить направление стрелок

Файл для сверки: `структурная_схема.pdf`. Исходный CDW этой схемы среди добавленных файлов отсутствует.

- [ ] Найти исходник структурной схемы для редактирования.
- [ ] Направить стрелки **от деталей к узлам, от узлов к готовому приводу**. Сейчас на PDF они направлены от изделия к его составным частям.
- [ ] Исправить направление на всех уровнях, включая связи внутри ветвей отдельных валов и двигателя в сборе.
- [ ] Готовый привод можно оставить сверху: переставлять все блоки только ради направления стрелок не требуется.
- [ ] Проверить, что выделенные сборочные единицы действительно можно собирать отдельно и что вложенность соответствует принятому порядку сборки.
- [ ] Заполнить обозначения собственных узлов и деталей. Для покупных изделий использовать их маркировки, для стандартных — обозначения по соответствующим стандартам.
- [ ] Проверить включение датчика Axis-M и его крепления: на кинематической схеме датчик есть, на просмотренной структурной схеме он не найден.
- [ ] Заполнить основную надпись по разделу 1.

Правильная логика связей:

```text
Двигатель + шестерня + гайка → двигатель в сборе
Детали валов → валы в сборе
Корпус + валы в сборе + крышки + крепёж → редуктор в сборе
Собранные узлы + остальные составные части → привод
```

**Стрелки не удалять:** ГОСТ Р 2.711–2023, п. 5.3, требует направлять их к изделию или составной части вышестоящего уровня. Это прямое основание для исправления замечания преподавателя «для разборки».

## 3. Сборочный чертёж привода

Исходник: добавленный CDW «Сборочный чертёж привод сдв 3»; визуальная проверка выполнена по `сборочный_чертеж.pdf`.

- [ ] Добавить под названием привода строку **«Сборочный чертёж»**.
- [ ] Указать обозначение `РЛ5.00.00.00.00 СБ` и убрать заглушку.
- [ ] Проверить соответствие всех позиций своей спецификации: на этом листе показан привод целиком, двигатель и редуктор входят в него как узлы.
- [ ] Проверить обозначения разрезов **Б–Б и Г–Г**. На просмотренном PDF соответствующие обозначения секущих плоскостей не найдены; буква Б также используется для направления взгляда. Обеспечить однозначное соответствие изображений и их обозначений.
- [ ] Проверить размер **5 с верхним и нижним отклонениями +0,2**. На PDF оба отклонения одинаковые. Назначить требуемые отклонения по смыслу сопряжения, не заменять автоматически на ±0,2.
- [ ] Проверить технические требования к сборке и контролю. Сейчас на PDF присутствует только примечание о справочных размерах. При необходимости указать регулировку упоров и микровыключателей, проверку свободного хода и другие требования, относящиеся к последнему этапу сборки привода.
- [ ] Проверить примечание «*Размеры для справок»: справочные размеры должны быть обозначены согласованно с ним.

Уточнение к замечанию «сборочный чертёж чего?»: для этого листа объект — **следящий привод возвратно-поступательного движения целиком**. Отдельный чертёж редуктора должен иметь название редуктора и собственное обозначение.

## 4. Габаритный чертёж — исправить текст условий

Исходник: добавленный CDW «Габаритный чертёж сдв 3»; визуальная проверка выполнена по `габаритный_чертеж.pdf`.

- [ ] Добавить строку **«Габаритный чертёж»** в основную надпись.
- [ ] Указать обозначение `РЛ5.00.00.00.00 ГЧ` и убрать заглушку.
- [ ] Исправить пункт «Условия транспортировки: по группе Ж (жесткие) ГОСТ 15150». **Ж как группа механических воздействий при перевозке относится к ГОСТ 23216–78**. Климатические условия транспортирования задаются отдельно по ГОСТ 15150–69.
- [ ] Проверить обоснованность выбора именно группы Ж. Не оставлять её только потому, что она уже вписана.
- [ ] Заменить неопределённое «условия хранения: 3 или 4» на конкретный выбранный режим либо явно описать условия применения каждого режима.
- [ ] Уточнить срок хранения/сохраняемости и необходимые условия упаковки и консервации для выбранного режима.
- [ ] Переработать фразу о защите «подвижных и внутренних штоков»: назвать реальные поверхности и детали данного привода, требующие консервации, и конкретизировать применяемый материал. Не распространять консервацию автоматически на фрикционные поверхности муфты и оптический датчик.
- [ ] Проверить отражение заданных **УХЛ 4.1 и IP44** в эксплуатационных требованиях. Это требования задания, а не подтверждение их выполнения конструкцией.
- [ ] Восстановить нумерацию пунктов: после 4 сейчас следует 6.
- [ ] Рекомендуется отделить технические характеристики от требований по транспортированию, хранению и консервации.
- [ ] Проверить тот же размер 5 с одинаковыми отклонениями +0,2, что и на сборочном чертеже.

Конкретные группы хранения и перевозки в этом чек-листе **не назначены**: их следует выбрать под принятые условия использования, упаковку и защиту изделия. УХЛ 4.1 само по себе не задаёт группу хранения или перевозки.

## 5. Кинематическая схема — согласовать с заданием и расчётом

Исходник: `Кинематическая схема.сдв.cdw`; визуальная проверка выполнена по `книемат_схема.pdf`.

- [ ] Заполнить обозначение `РЛ5.00.00.00.00 К3`.
- [ ] Сохранить полное название изделия и строку **«Схема кинематическая принципиальная»**.
- [ ] Устранить расхождение типа муфты: в задании и расчёте она **фрикционная**, на схеме подписана **шариковая**. Проверить также условное изображение и фактическую конструкцию. Одной замены подписи достаточно только при соответствии самой конструкции.
- [ ] Согласовать данные о погрешности: на схеме 25′, в задании и ГЧ 30′. Если 25′ — подтверждённый расчётом результат, явно отличить его от допустимой погрешности «не более 30′». Не менять результат на 30′ автоматически.
- [ ] Согласовать маркировку двигателя и датчика с остальными документами.

## 6. Спецификация и состав комплекта

`Спецификация привод.pdf` и `спецификация.pdf` полностью совпадают по содержимому файла. Второй PDF не является исправленной версией. Редактируемая спецификация SPW отдельно не предоставлена; проверить, ведётся ли она внутри сборочного CDW.

- [ ] Убрать **СБ** из обозначения самой спецификации привода; оставить `РЛ5.00.00.00.00`.
- [ ] Убрать слова **«Сборочный чертёж»** из наименования в её основной надписи.
- [ ] В разделе «Сборочные единицы» указать обозначение редуктора как изделия **без СБ**. Код СБ относится к его сборочному чертежу.
- [ ] Заполнить обозначения собственных деталей и сборочных единиц, где графы сейчас пустые.
- [ ] В разделе «Документация» привести ссылки к фактическим обозначениям чертежей и схем после их исправления.
- [ ] Добавить структурную схему Е1 в перечень документации, если она выпускается отдельным документом данного комплекта.
- [ ] Проверить наличие указанного в спецификации чертежа общего вида ВО: среди предоставленных PDF он отсутствует. Найти его либо уточнить фактический состав сдаваемого комплекта.
- [ ] Проверить включение датчика Axis-M и его крепления на соответствующем уровне спецификации. Если датчик внешний и не входит в изделие, явно отразить это в документах.
- [ ] Сверить состав и количества деталей между структурной схемой, спецификациями и таблицей составных частей в `ТСЧ.docx`.

**Не требовать одинаковых номеров позиций во всех таблицах:** позиции общего сборочного чертежа должны соответствовать именно его спецификации. Нумерация таблицы составных частей к чертежу общего вида может отличаться. Сопоставлять нужно наименования, обозначения, количество и уровень входимости.

## 7. Расчёт муфты — проверить до защиты

Файл: `КП рассчет.pdf`.

- [ ] **С. 69:** исправить единицы результата `11 × 6 = 66 Н·м`. При радиусе 6 мм результат равен **66 Н·мм = 0,066 Н·м**.
- [ ] На той же странице исправить единицы в последующем сравнении с 64,8: обе величины должны быть выражены в согласованных единицах.
- [ ] **С. 66:** проверить выбор момента срабатывания муфты. Расчёт использует момент двигателя, тогда как на кинематической схеме муфта расположена на валу V. Требуется проверить момент в месте её установки с учётом предшествующих передач и принятого режима работы.
- [ ] После проверки момента при необходимости пересчитать усилие пружины, параметры муфты и её регулировку; согласовать результат с конструкцией и чертежами.
- [ ] Убедиться, что расчёт, кинематическая схема, структурная схема и реальная модель описывают один и тот же тип муфты.

## 8. Проверка после исправлений

- [ ] Сохранить исправления в копиях исходных документов, чтобы сохранить исходную версию.
- [ ] Сформировать новые PDF именно из исправленных CDW и актуальной спецификации.
- [ ] Визуально проверить на новых PDF названия и обозначения, читаемость штампов, направление стрелок, обозначения разрезов и отсутствие наложений текста.
- [ ] Проверить совпадение всех ссылок на документы и позиций со спецификациями.
- [ ] Выделить один окончательный комплект для сдачи; исключить случайную отправку старых PDF.

## Источники

- [ГОСТ 2.701–2008](https://meganorm.ru/Data/479/47901.pdf), таблицы 1–2 и п. 4.4: виды, типы, названия и коды схем, в том числе Е1 и К3.
- [ГОСТ Р 2.711–2023](https://meganorm.ru/Data/816/81671.pdf), п. 4.3: код Е1; п. 5.3 и рис. 1: направление стрелок; приложение Б: образец основной надписи.
- [ГОСТ Р 2.102–2023](https://base.garant.ru/408167007/): виды и коды конструкторских документов.
- [ГОСТ 23216–78](https://www.elec.ru/library/gosts_e09/gost_23216-78.pdf), разделы 1–2: хранение и транспортирование, разграничение механических и климатических воздействий.
- [Пособие МГТУ 2022 года под редакцией В. А. Городничева](https://press.bmstu.ru/catalog/item/7706/reader/): с. 10 — структурная схема сборки и обозначения РЛ5; с. 11 — габаритный чертёж и требования; с. 29, рис. П1.13 — пример схемы с кодом Е1. Для онлайн-чтения нужна авторизация МГТУ.
- [Пособие МГТУ 2012 года, часть 2](https://press.bmstu.ru/catalog/item/125/reader/): с. 5 — схема сборки Е1; с. 13, рис. П1.6 — пример структурной схемы. Для онлайн-чтения нужна авторизация МГТУ.
- [Фрагмент основной надписи из пособия 2022 года](Проверка_ОКП/Штамп_схемы_из_пособия_2022.png).
