BogoslavskiM/okp/Исправленные_PDF/О_ПРАВКАХ.md

# Исправленные PDF проекта ОКП

Сохранены отдельные копии пяти документов. Исходные PDF в корне проекта не изменены.

| Файл | Внесённые изменения |
|---|---|
| Сборочный_чертёж_исправленный.pdf | Обозначение `РЛ5.00.00.00.00 СБ` в основной и дополнительной графах; полное название изделия и строка «Сборочный чертеж». |
| Габаритный_чертёж_исправленный.pdf | Обозначение `РЛ5.00.00.00.00 ГЧ` в обеих графах; полное название изделия и строка «Габаритный чертеж». |
| Кинематическая_схема_исправленная.pdf | Обозначение `РЛ5.00.00.00.00 К3` в обеих графах. |
| Структурная_схема_исправленная.pdf | Обозначение `РЛ5.00.00.00.00 Е1`, исходное название «Структурная схема»; стрелки направлены от составных частей к узлам и готовому приводу. Добавлены наконечники на входах общих ветвей в родительские блоки. |
| Спецификация_исправленная.pdf | Обозначение самой спецификации на обоих листах — `РЛ5.00.00.00.00`, без СБ; исправлено название в штампе; обновлены ссылки в разделе «Документация» и добавлена схема Е1; обозначение редуктора — `РЛ5.00.01.00.00`, без СБ. |

Для двух одинаковых исходных спецификаций (`спецификация.pdf` и `Спецификация привод.pdf`) выпущен один исправленный документ из двух страниц.

## Проверка

Визуально проверены новые надписи, таблица документации и стрелки. Сохранены количество и размеры страниц. Сравнение изображений всех шести страниц при ширине 1800 пикселей не выявило изменений за пределами областей правок. Векторные чертежи сохранены в PDF; растровая структурная схема исправлена локальными наложениями текста и линий.

После замечания о шрифтах исправлена избыточная переработка штампов. Для новых надписей использованы исходные версии ГОСТ-шрифтов соответствующих документов, восстановлен наклон букв по исходным PDF и исходная высота текста на векторных листах. На сборочном и габаритном чертежах первая строка названия сохранена без изменений; полное описание движения помещено во вторую строку с горизонтальным сжатием, третья отведена типу чертежа. В спецификации восстановлен исходный размер названия. На структурной схеме все три исходные строки названия сохранены целиком, включая «Структурная схема». Название на кинематической схеме сохранено целиком.

По последнему уточнению автора название «Структурная схема» восстановлено также в разделе «Документация» спецификации. Код Е1 и исправленные стрелки сохранены.

Сохранённые строки названий сравнены с оригиналами по пикселям при увеличении: совпадение полное. Изменений вне областей шрифтовых правок относительно предыдущих исправленных PDF не обнаружено; направление и геометрия стрелок сохранены. Актуальны пять PDF в этой папке. Предыдущая версия до правки шрифтов сохранена отдельно в `Проверка_ОКП/PDF_до_правки_шрифтов`.

## Что ещё требует исправления

Это правки непосредственно PDF. В CDW они не перенесены: при повторном экспорте из старых исходников потребуется повторить соответствующие изменения в КОМПАСе.

Остальные замечания из [списка исправлений](../СПИСОК_ИСПРАВЛЕНИЙ_ОКП.md) остаются актуальны: выбор условий хранения и перевозки, технические требования и их нумерация, размерные отклонения, обозначения разрезов, согласование типа муфты и погрешности, расчёт муфты, состав изделия и недостающие обозначения деталей. Ссылка на чертёж общего вида ВО в спецификации сохранена; самого чертежа среди предоставленных PDF нет.
