BogoslavskiM/okp/Проверка_ОКП/Правка_ГГ_по_скриншоту.md

В файле `Исправленные_PDF/Сборочный_чертёж_ГГ_по_указанным_местам.pdf` обозначение Г–Г перенесено к двум узлам крепления микропереключателей, обведённым пользователем на скриншоте. В каждом месте секущая плоскость проходит через оси двух крепёжных винтов. Прежние указатели Г у направляющей сняты. Указатели Б–Б, сами изображения сечений, размеры, позиции и основная надпись сохранены. Исходные графические потоки и шрифты не изменены.
