BogoslavskiM/okp/Проверка_ОКП/Правка_указателей_сборочного.md

Создан отдельный файл `Исправленные_PDF/Сборочный_чертёж_сечения_исправлены.pdf`.

- Убраны прежние буква Б и стрелка слева от бокового вида.
- На первом виде добавлены парные указатели Б–Б через опору рейки; направление — вдоль рейки.
- На первом виде обозначена горизонтальная секущая плоскость Г–Г через оси винтов крепления направляющей; направление взгляда — снизу.
- Сами изображения сечений, их подписи, размеры, позиции и основная надпись не менялись. Разрез В–В в эту правку не включён.
- Для новых букв использован исходный шрифт сборочного PDF. Исходный поток страницы и встроенные исходные шрифты сохранены без изменений; правка выполнена локальными векторными наложениями.
