BogoslavskiM/okp/Сборочный_чертёж_редуктора/О_ЧЕРТЕЖЕ.md

# Редуктор — сборочный чертёж

Актуальный PDF после восстановления рамки: **`Редуктор_сборочный_чертёж_А1_рамка.pdf`**; копия с тем же именем сохранена в `ИТОГ`. Восстановлена сетка основной надписи: верхняя граница, разделители полей и стыки линий. Изображения изделия и текст сохранены; сравнение растров до и после не выявило изменений вне штампа. Предыдущий PDF оставлен отдельно. Правка воспроизводится командой `python3 Сборочный_чертёж_редуктора/Исходные_данные/restore_frame.py` и включена в основной генератор.

Файл `Редуктор_сборочный_чертёж_А1.pdf` — отдельный векторный лист А1, 841 × 594 мм. Основной масштаб изображений — 2,5:1. Печатать на А1 с масштабом страницы 100 %, без подгонки. Рядом сохранены SVG и предпросмотр.

Обозначение — **РЛ5.41.01.00.00 СБ**. Оно получено из строки «Редуктор в сборе», поз. 2 спецификации привода. Наименование в основной надписи: «Редуктор. Сборочный чертеж». Оформление основной надписи перенесено из существующего проекта; масса всего привода 0,85 кг для редуктора не использована.

## Состав и изображения

Геометрия построена по `ОКП/Детальная прорисовка.stp`. Граница сборки взята из более новой существующей структурной схемы: корпус, валы II–VI, подшипники, муфта, ЛВК Z10 и наружный Z11, направляющая и две опоры. Мотор с Z1, рейка, длинный кронштейн, концевики и датчик относятся к сборке привода и в этот чертёж не включены. Всего в выделенном узле 68 верхних компонентов, 198 геометрических листьев модели.

На листе размещены:

- наружный торцевой вид и согласованный с ним боковой вид;
- А–А: поперечный разрез на глубине Y = 34,5 мм, с внутренними колёсами и опорами;
- Б–Б: продольный разрез через оси II и III валов;
- В–В: продольный разрез через оси IV и V валов, показывающий муфту;
- Г–Г: продольный разрез через ось VI вала, его опоры и крепление наружного колеса.

Все разрезы являются геометрическими сечениями модели. На наклонных Б–Б и В–В также видны срезы попавших в секущую плоскость соседних деталей. Условные цилиндрические венцы используются только для оформления зубьев: исходная STEP-модель не изменена. Пружины включены целиком, в том числе поверхности, экспортированные в STEP как замкнутые оболочки. Видимые плавные переходы добавлены тонкими линиями.

### Как читать соединения на разрезах

- **Б–Б, валы II–III:** зацепляются Z3 нижнего вала и Z4 верхнего, в средней части изображения по длине валов. Их начальные радиусы 2,85 и 10,2 мм дают межосевое расстояние 13,05 мм; перекрытие венцов по ширине составляет 2,4 мм. Большое колесо слева на нижнем валу — Z2, а маленький венец слева на верхнем — Z5; эта пара не должна зацепляться между собой.
- **Г–Г, выходной вал VI:** наружный ЛВК Z11 справа установлен на участке Ø9; показаны ступица, шпонка поз. 18 и концевая гайка поз. 9. Отдельный заштрихованный фрагмент под валом внутри корпуса — внеосевой срез соседнего колеса Z8. Плоскость проходит в 8,6625 мм от его оси V и пересекает обод, но не вал и ступицу. Это не разрыв выходного колеса и не потеря его крепления.
- **Посторонние фрагменты:** ГОСТ 2.305–2008, п. 4.7 разрешает не показывать ненужную геометрию *за* секущей плоскостью. Это разрешение само по себе не распространяется на детали, пересечённые плоскостью и заштрихованные на этих разрезах. Указанные срезы пока сохранены; их исключение требует пересмотра изображения, а не стирания отдельных линий.

Буквы Б и В у нижних левых обозначений секущих плоскостей разнесены; наложение устранено.

## Размеры и источники

Межосевые расстояния II–III = 13,05; III–IV = 13,2; IV–V = 13,35; V–VI = 17,325 мм совпали с моделью. Отклонение ±0,009 мм перенесено из расчёта, с. 55–56. Проверены центры и номиналы посадочных цилиндров; результаты сохранены в `Исходные_данные/Проверка_сборочных_номиналов.json`.

Крепление редуктора: три отверстия Ø4 на окружности Ø86. Центрирующее отверстие двигателя Ø17H8 и отверстия опор Ø7H7 перенесены из существующего сборочного чертежа. Габариты со звёздочкой справочные, измерены по модели.

Требование 30 угл. мин взято из ТЗ на с. 1 расчёта. Формулировка не сужена до одной составляющей погрешности. Степень точности 6 и сопряжение H указаны в расчёте на с. 50.

## Что требуется для окончательного комплекта рабочей документации

Это вариант для предметной проверки и согласования. Он не заменяет окончательное назначение посадок и комплектование спецификации редуктора.

1. **Отдельная спецификация редуктора отсутствует.** Позиции на листе сохранены по имеющейся структурной схеме (актуальная нумерация до 64). Старую `ТСЧ.docx` с другой нумерацией и типоразмерами не использовали. Эти позиции необходимо перенести без перенумерации в спецификацию редуктора либо согласованно поменять в обоих документах. Схема не даёт отдельных позиций колесу Z8 и стопорному винту муфты; новые номера им не выдуманы. Не каждый мелкий элемент, скрытый на выбранных изображениях, снабжён отдельной выноской.
2. **В исходниках не назначены внутренние посадки.** Подтверждены номиналы опор: восемь подшипников d3/D8 на II–V валах, d7/D11 и d9/D14 на VI валу. Поля допусков на вал/корпус и посадки колёс, полумуфт, частей ЛВК требуют выбора. Одного STEP для этого недостаточно. Эти поля на чертёж не добавлялись как якобы согласованные.
3. **Нет согласованных осевых зазоров и сборочных допусков с базами.** Расчётные 11/14 мкм относятся к радиальному биению зубчатых венцов, а не к произвольным поверхностям сборки; в рамки на корпусе они не превращены.
4. **Настройка муфты в расчёте противоречива.** Указаны 64,8 Н·мм при расчётном моменте V вала 93,62 Н·мм; в одном результате также ошибочно напечатаны Н·м вместо Н·мм. Числовое требование настройки муфты пока не нанесено.

Исходные PDF, модель, существующие схемы и общий вид не изменялись.

## Нормативная основа оформления

- [ГОСТ Р 2.109–2023, раздел 7](https://normadocs.ru/gost_r_2.109-2023): содержание сборочного чертежа, размеры, позиции и связь со спецификацией.
- [ГОСТ 2.305–2008](https://files.stroyinf.ru/Data2/1/4293830/4293830650.htm): виды, разрезы, обозначения секущих плоскостей; продольные валы и крепёж без штриховки.
- [ГОСТ 2.402–68](https://files.stroyinf.ru/Data2/1/4294849/4294849531.htm): условные зубчатые венцы, начальные линии и изображение зацеплений.
- [ГОСТ 2.420–69](https://normadocs.ru/gost_2.420-69): изображения подшипников.

Воспроизводимая сборка листа: `python3 Сборочный_чертёж_редуктора/Исходные_данные/build_reducer.py`. Нужен PyMuPDF, сохранённые JSON-проекции и шрифты из существующего каталога общего вида. Скрипты геометрических построений требуют Open Cascade; промежуточные BRep исходной модели находятся в `/tmp/okp_cad_data`, а сохранённые проекции уже включены в каталог результата.
