BogoslavskiM/okp/Чертёж_общего_вида/О_ЧЕРТЕЖЕ.md

Создан отдельный чертёж общего вида по `ОКП/Детальная прорисовка.stp`. Компоновка ориентирована на предоставленный пример «Чертеж общего вида А1.pdf». Исходные PDF и ТСЧ не изменены. **Актуальная редакция:** `Чертёж_общего_вида_А1_полный_аудит.pdf`.

- `Чертёж_общего_вида_А1_полный_аудит.pdf` — актуальный векторный лист 841 × 594 мм. При печати: А1, масштаб 100 %, без подгонки.
- `Чертёж_общего_вида_А1_полный_аудит.svg` — актуальная векторная копия; текст преобразован в контуры.
- `Предпросмотр_полный_аудит.png` — актуальное изображение для просмотра.
- `Исходные_данные/Редакция_2/build_okp_vo.py` — воспроизводимая сборка PDF/SVG из сохранённых проекций; необходим PyMuPDF. Запуск: `python3 Чертёж_общего_вида/Исходные_данные/Редакция_2/build_okp_vo.py`.

Виды и разрезы получены геометрическим проецированием и сечением STEP-модели средствами Open Cascade. Растровых вставок в PDF нет. Разрез А–А проходит поперёк редуктора, Б–Б — вдоль выходного вала, В–В — вдоль муфты, Д–Д — через второй микропереключатель, Е–Е — поперёк рейки в опоре. Муфта на В–В и оба ЛВК показаны отдельно. Служебные кривые STEP не использованы.

Позиции взяты **только из существующего `ТСЧ.docx`**. Новая таблица не создана. Нумерация из спецификации сборочного чертежа сюда не смешивалась: там другой состав и другие номера. Обозначение документа — `РЛ5.41.00.00.00 ВО`, как предусмотрено строкой «Чертёж общего вида» в существующей спецификации.

Перед окончательной сдачей нужно учесть ограничения исходных данных:

- Отдельных полумуфт, пружин ЛВК и датчика AXIS-M в ТСЧ нет. Им не присвоены новые позиции. Поз. 33 и 48 отнесены к соответствующим зубчатым колёсам в показанных узлах ЛВК. Поз. 51 «Упор для рейки» сопоставлена с двумя опорами скольжения модели по назначению и количеству; наименование модели отличается.
- Глубина модели с выступающими головками винтов датчика — примерно 127,6 мм. В старом сборочном PDF указано 126,5 мм. На новом чертеже показан справочный габарит по модели, а не перенесено противоречащее ему число.
- Посадка рейки ⌀7H7/h6 перенесена из пользовательского сборочного чертежа. Остальные посадки, допуски биения и момент настройки муфты здесь не назначены: их нельзя достоверно восстановить из одного STEP. Это вариант для проверки конструкции и оформления; считать его окончательно прошедшим нормоконтроль нельзя. Если требуется ВО стадии технического проекта, нужно дополнить его выбранными посадками и подтверждёнными техническими требованиями.
- Размер 256,1 мм относится к показанному положению рейки. Предельный габарит во всём диапазоне хода отдельно не проверялся, поэтому обозначение «max» не добавлено.
- Поля подписей, массы и литеры не заполнены непроверенными данными.

При оформлении использованы требования к содержанию общего вида из [ГОСТ 2.119–2013, п. 5.2](https://base.garant.ru/71139516/), требования технического проекта из [ГОСТ 2.120–2013, п. 5.1](https://base.garant.ru/71139518/), правила видов и разрезов [ГОСТ 2.305–2008](https://files.stroyinf.ru/Data/479/47928.pdf). Рамка, шрифт и масштабы оформлены по принципам ЕСКД; полная проверка соответствия всем применимым стандартам не заявляется.

## Редакция после полного визуального аудита

Актуальный отдельный файл — `Чертёж_общего_вида_А1_полный_аудит.pdf`. В нём:

- вид А переименован в Г; все обозначения А–А, Б–Б, В–В, Д–Д, Е–Е и Г на листе уникальны;
- Д–Д построен по второму микропереключателю, прежний разрез опоры сохранён как Е–Е;
- на Б–Б по замечанию не показано зубчатое колесо поз. 32; это оговорено текстом над разрезом;
- гайка М8 и вал на Б–Б не заштрихованы; резьбовой конец вала показан условно по ЕСКД без ломаного наложения геометрии гайки;
- два наружных стопорных кольца на Б–Б показаны парами симметричных отдельно заштрихованных сечений в существующих канавках вала;
- точные торцевые проекции пружин на Б–Б заменены отдельными сечениями витков по ГОСТ 2.401;
- винт М2 рядом с пружиной на Б–Б показан целиком условным изображением без взаимного наложения линий;
- на Б–Б полностью заштрихована пересечённая верхняя площадка реечной направляющей, ранее частично оставшаяся белой из-за соприкасающихся контуров STEP;
- венец Z9 на В–В приведён к симметричному условному осевому изображению без отдельного «сбежавшего» контура;
- зубья разрезного выходного колеса на боковом виде заменены условным изображением по ГОСТ 2.402: показаны поверхность выступов, стык двух половин и начальные образующие;
- посадка `⌀7H7/h6` на Е–Е указана двусторонней размерной линией через диаметр;
- внутренний декоративный рисунок покупного микропереключателя в Д–Д подавлен, его наружный контур сохранён;
- все осевые приведены к одному типу и толщине; полки поз. 29, 23, 30, 24, 40 и 41 ориентированы в сторону текста; обозначения В–В на А–А вынесены за механизм;
- наконечники всех стрелок секущих плоскостей доведены точно до толстого конечного штриха без выхода за него;
- на виде Г верхняя буква «Д» перенесена в свободное поле без изменения секущей плоскости Д–Д;
- выносные линии размеров 40, 127,6 и 256,1 начинаются непосредственно от фактического видимого контура.

Оставлено как несоответствие исходных документов: в STEP установлены два кольца `A9.50 ХГА ГОСТ 13940-86`, а в `ТСЧ.docx` поз. 9 записана как `A6.50` (2 шт.); гайка М8 из STEP в этом ТСЧ отсутствует. Новые позиции им в ВО не назначались.
