BogoslavskiM/okp/Чертёж_общего_вида/ПРОВЕРКА_ПРУЖИН_ЕЕ_И_ОСНОВНОЙ_НАДПИСИ.md

Обновлённый файл: `Чертёж_общего_вида_А1_пружины_ЕЕ_штамп.pdf`. Предыдущий PDF сохранён.

1. **Пропадавшие линии у пружин и креплений.** При первоначальном экспорте извлекались только резкие рёбра и силуэты. Видимые линии переходов между гладко сопряжёнными поверхностями не включались. Они возвращены тонкими сплошными линиями; скрытые рёбра и параметрические швы поверхностей не добавлялись. Контуры витков, отверстий и крепежа также пересчитаны с более точной аппроксимацией. Оболочки, содержащие витки пружин в STEP, сохранены.
2. **Е–Е.** Винт в продольном сечении показан целиком. Из штриховки соседних деталей исключена область, перекрываемая винтом; конец винта больше не заштрихован как часть рейки. Форма конца с фаской сохранена по модели, произвольное коническое острие не добавлялось.
3. **Основная надпись.** Векторный блок взят из существующего исправленного габаритного чертежа: сохранены его сетка, шрифт, наклон, размеры текста и расположение строк. Изменены обозначение на `РЛ5.41.00.00.00 ВО` и тип документа на «Чертеж общего вида». Фамилии и значение массы 0,85 перенесены из этого же исходного блока; это не новый расчёт массы.

**Отдельная проблема исходной модели:** твёрдое тело винта ограничителя и твёрдое тело рейки пересекаются. Проверка булевым пересечением дала около **1,63 мм³**. Перекрытие учтено при отрисовке, но геометрия STEP не изменена. Нужно отдельно согласовать глубину паза, положение и форму конца винта; исправление картинки не доказывает отсутствие заклинивания.

Нумерация позиций остаётся по существующей ТСЧ. Список валов с установленными деталями записан в `ВАЛЫ_ПРИВОДА.md` в корне проекта.

Источник сборки новой редакции: `Исходные_данные/Редакция_2/build_okp_vo.py`; в той же папке сохранены проекции и образец основной надписи. Для повторного получения PDF нужен PyMuPDF. Файлы исходной модели, ТСЧ и сборочного чертежа этой правкой не изменялись.
