BogoslavskiM/okp/Сборочный_чертёж_редуктора/Исходные_данные/Проекции/О_ПРОЕКЦИЯХ.md

# Проекции редуктора

Рабочие файлы: `front.json` (внешний вид спереди), `side.json` (внешний вид слева), `section_a.json` (поперечный разрез по Y=34,5 мм с сохранением части Y≤34,5). Продольные разрезы формируются отдельно в `build_sections.py`.

`Состав_и_геометрия.json` содержит полный состав редуктора: 68 верхних узлов и 198 физических листьев, их габариты и параметры венцов. Состав соответствует существующей структурной схеме. Внешние виды рассчитаны без внутренних деталей, полностью закрытых корпусом и крышкой; это сокращение расчёта не меняет состав изделия. Перечень фактически использованных тел указан в metadata каждого JSON.

Для условного изображения зубьев скрипт `conventional_fast.py` заменяет только наружные поверхности венца поверхностью цилиндра вершин. Отверстия, ступицы, окна ЛВК и прочие внутренние поверхности сохранены. Все 12 полученных тел проверены на замкнутость и корректность BRep. Эти тела предназначены для графики: массу нужно определять по исходным телам с настоящими зубьями.

Проекции — видимые контуры и видимые линии гладких переходов G1. Невидимые линии и параметрические швы не выводятся. Отклонение сетки 0,006 мм, угловое отклонение 0,10 рад. Пружины сохранены целиком, в том числе оболочки, составляющие витки. Внешняя пружина визуально сопоставлена с прежней точной проекцией общего вида.

Начальные окружности и линии, осевые, обозначения разрезов, позиции и размеры добавляются при окончательной компоновке. Параметры окружностей приведены в `Состав_и_геометрия.json`; для Z11 r=22,5 мм, центр X=−15,330005; Z=3,067337 мм.

Для повторного построения используется существующее окружение `/tmp/okp_cad_env/bin/python` и подготовленные исходные BRep в `/tmp/okp_cad_data`. Пример: `build_projections.py front`, `side`, `section_a`. Исходный STEP не изменяется. Кэш условных тел находится в `Условная_геометрия_fast`.
