BogoslavskiM/okp/Исправить/ТСЧ.docx

Поз. | Наименование | | | | | Кол. | Примеч.
| Покупные изделия
1 | Винт А.М1-6g×4 ГОСТ 17473-80 | | | | | 6
2 | Винт А.М1-6g×3 ГОСТ 17473-80 | | | | | 3
3 | Винт А.М1,6-6g×8 ГОСТ 17473-80 | | | | | 4
4 | Винт А.М1,6-6g×14 ГОСТ 17473-80 | | | | | 2
5 | Винт А.М2-6g×5 ГОСТ 17473-80 | | | | | 7
6 | Винт А.М2-6g×6 ГОСТ 17473-80 | | | | | 8
| | | | | | | | Лист
| | | | | | | | 2
Изм | Лист | № докум. | Подп. | Дата

Поз. | Наименование | | | | | Кол. | Примеч.
7 | Винт А.М2-6g×9 ГОСТ 17473-80 | | | | | 7
8 | Гайка М8-6H ГОСТ 5929-70 | | | | | 1
9 | Кольцо A9.50 ХГА ГОСТ 13940-86 | | | | | 2
10 | Микропереключатель KW10-Z1P | | | | | 2
11 | Подшипник 1000093 ГОСТ 8338-75 | | | | | 8
12 | Подшипник 4А-1000007 ГОСТ 10058-90 | | | | | 1
13 | Шайба 2 ГОСТ 6402-70 | | | | | 2
| | | | | | | | Лист
| | | | | | | | 3
Изм | Лист | № докум. | Подп. | Дата

Поз. | Наименование | | | | | Кол. | Примеч.
14 | Шайба 3 ГОСТ 6402-70 | | | | | 1
15 | Шпонка 3×3×6 ГОСТ 23360-78 | | | | | 1
16 | Штифт 1,2×3 ГОСТ 3128-70 | | | | | 1
17 | Штифт 1,5×6 ГОСТ 3128-70 | | | | | 1
18 | Штифт 1,5×8 ГОСТ 3128-70 | | | | | 2
20 | Штифт 2×12 ГОСТ 3128-70 | | | | | 1
21 | Двигатель ДПР-42 | | | | | 1
| | | | | | | | Лист
| | | | | | | | 4
Изм | Лист | № докум. | Подп. | Дата

Поз. | Наименование | | | | | Кол. | Примеч.
55 | Подшипник 4А-1000009 ГОСТ 10058-90 | | | | | 1
60 | Винт А.М1-6g×2,5 ГОСТ 17473-80 | | | | | 1
65 | Датчик Axis-M | | | | | 1
66 | Винт А.М2,5-6g×20-18 ГОСТ 17473-80 | | | | | 3
| Вновь разрабатываемые изделия
22 | Вал VI | | | | | 1
23 | Вал-шестерня Z3 | | | | | 1
| | | | | | | | Лист
| | | | | | | | 5
Изм | Лист | № докум. | Подп. | Дата

Поз. | Наименование | | | | | Кол. | Примеч.
24 | Вал-шестерня Z5 | | | | | 1
25 | Вал-шестерня Z7 | | | | | 1
26 | Вал-шестерня Z9 | | | | | 1
27 | Втулка муфты | | | | | 1
28 | Гайка М3×0,35 | | | | | 1
29 | Зубчатое колесо Z2 | | | | | 1
30 | Зубчатое колесо Z4 | | | | | 1
| | | | | | | | Лист
| | | | | | | | 6
Изм | Лист | № докум. | Подп. | Дата

Поз. | Наименование | | | | | Кол. | Примеч.
31 | Зубчатое колесо Z6 | | | | | 1
32 | Зубчатое колесо Z8 | | | | | 1
33 | Несущая часть ЛВК Z10 | | | | | 1 | Z10
34 | Ключ | | | | | 1
35 | Кольцо 3 | | | | | 1
36 | Компенсатор крышки II вала | | | | | 1
37 | Компенсатор крышки IV вала | | | | | 1
| | | | | | | | Лист
| | | | | | | | 7
Изм | Лист | № докум. | Подп. | Дата

Поз. | Наименование | | | | | Кол. | Примеч.
38 | Компенсатор крышки V вала | | | | | 1
39 | Компенсатор крышки выходного вала | | | | | 1
40 | Корпус | | | | | 1
41 | Крепление для упоров | | | | | 1
42 | Крышка II вала | | | | | 1
43 | Крышка IV вала | | | | | 1
44 | Крышка V вала | | | | | 1
| | | | | | | | Лист
| | | | | | | | 8
Изм | Лист | № докум. | Подп. | Дата

Поз. | Наименование | | | | | Кол. | Примеч.
45 | Крышка выходного вала | | | | | 1
46 | Крышка корпуса | | | | | 1
47 | Реечная направляющая | | | | | 1
48 | Несущая часть реечного ЛВК Z11 | | | | | 1 | Z11
49 | Рейка Z12 | | | | | 1
50 | Стакан | | | | | 1
51 | Опора скольжения | | | | | 2
| | | | | | | | Лист
| | | | | | | | 9
Изм | Лист | № докум. | Подп. | Дата

Поз. | Наименование | | | | | Кол. | Примеч.
52 | Шестерня Z1 | | | | | 1
53 | Шпонка двигателя | | | | | 1
54 | Втулка стакана | | | | | 1
56 | Пружина ЛВК Z10 | | | | | 4
57 | Поворотная часть ЛВК Z10 | | | | | 1
58 | Винт ступенчатый ЛВК Z10 | | | | | 4
59 | Гайка муфты | | | | | 1
| | | | | | | | Лист
| | | | | | | | 10
Изм | Лист | № докум. | Подп. | Дата

Поз. | Наименование | | | | | Кол. | Примеч.
61 | Шпонка полумуфты | | | | | 1
62 | Ведущая полумуфта | | | | | 1
63 | Пружина муфты | | | | | 1
64 | Подвижная полумуфта | | | | | 1
67 | Поворотная часть реечного ЛВК Z11 | | | | | 1
68 | Пружина реечного ЛВК Z11 | | | | | 2
69 | Винт ступенчатый реечного ЛВК Z11 | | | | | 2
| | | | | | | | Лист
| | | | | | | | 11
Изм | Лист | № докум. | Подп. | Дата

РЛ5.41.00.00.00 ВО — Таблица составных частей
