BogoslavskiM/okp/Исправить/КП_рассчет.pdf

Министерство науки и высшего образования Российской Федерации Федеральное государственное автономное образовательное учреждение высшего образования
«Московский государственный технический университет имени Н.Э. Баумана (национальный исследовательский университет)» (МГТУ им. Н.Э. Баумана)
УТВЕРЖДАЮ
Заведующий кафедрой | РЛ-5
(индекс)
В.А. Городничев
(И.О. Фамилия)
(подпись) | 14/02/26
(дата)

### ЗАДАНИЕ

на выполнение курсового проекта

по дисциплине Основы конструирования приборов
Студенты группы
(Фамилия, имя, отчество)
Тема курсового проекта Следящий привод возвратно-поступательного движения

Направленность КП (учебная, исследовательская, практическая, производственная, др.) Учебная

Источник тематики (кафедра,
предприятие, НИР) | Кафедра
Задание | разработать конструкцию следящего привода возвратно-поступательного движения.
Статическая сила на выходном звене 8 Н, скорость движения выходного звена 0,03 м/с, перемещаемая масса 1 кг, ускорение движения выходного звена 1 м/с²
, диаметр делительной
окружности колеса реечной передачи 45 мм, рабочий ход выходного звена 60 мм, погрешность редуктора на выходном валу 30 угл. мин, комплексный критерий проектирования (от Min габаритов), фрикционная предохранительная муфта, двигатель типа ДПР, степень защиты IP44, условия эксплуатации УХЛ 4.1.
Оформление курсового проекта:
Расчетно-пояснительная записка на | листах формата А4.
Перечень графического (иллюстративного) материала (чертежи, плакаты, слайды и т.п.)

Дата выдачи задания « 14 » февраля 2026 г.

Руководитель курсового проекта
(подпись, дата) | (И.О. Фамилия)
Студенты
(подпись, дата) | (И.О. Фамилия)

СОДЕРЖАНИЕ

### 1. Техническое задание

Техническое задание: разработать конструкцию следящего привода

возвратно-поступательного движения по предложенной схеме в соответствии с

заданным вариантом.

Основные исходные данные приведены в таблице 1:

Таблица 1 – Основные исходные данные.

Статическая сила на выходном звене F, Н | 8
Скорость движения выходного звена V, м/с | 0,03
Перемещаемая масса m, кг | 1
Ускорение движения выходного звена а, м/с^2 | 1
Диаметр делительной окружности колеса реечной передачи d, мм | 45
Рабочий ход выходного звена S, мм | 60
Погрешность редукторa на выходном валу ∆φ, угл. мин. | 30
Критерий проектирования | Комплексный (от Min габаритов)
Тип предохранительной муфты | Фрикционная
Тип электродвигателя | ДПР или ДПМ
Вид корпуса | В зависимости от степени защиты
Характер производства | Единичное
Вывод выходного звена (рейки) | С противоположной стороны от двигателя
Вид выходного конца рейки | Под штифт
Условия эксплуатации | УХЛ 4.1
Степень защиты | IP44

### 2. Определение расчётной мощности электродвигателя

Для расчёта мощности электродвигателя, вычислим значение мощности

нагрузки на выходном валу Pн

при поступательном движении:

( | ) 0.03(8 1) 0.27 Pн = | + | = | + = V F ma | Вт

Тогда значение расчётной мощности электродвигателя без учёта

коэффициента запаса:

0.27
0.64
0.6 0.7

н
рас
р

P
P | Вт
η
= | = | =
·

Предварительно возьмём коэффициент запаса ξ = 4. Получаем значение

расчётной мощности электродвигателя с учётом коэффициента запаса:

( )

0.27
4 2.56
0.6 0.7

н
рас
р

P
P ξ
ξ | Вт
η
= | · = | · =
·

### 3. Подбор типоразмера электродвигателя

Используя расчётное значение мощности P
рас

, подберём конкретный

двигатель по справочным данным, представленным в таблице 1 (источник -

«Расчет электромеханического привода : методические указания / Ю. А.

Кокорев, В. А. Жаров, А. Я. Ожерельев, О. В. Готальская. — 2-е изд. — Москва

: МГТУ им. Н.Э. Баумана, 2018), при условии, что Pтаб рас ≥ P .

Посчитаем мощность двигателя ДПР-32-01, предварительно переводя

единицы измерения в СИ:

_ 32 01

0.002 942 1.884 Pтаб | ном | ном − | = | · | = | · | = M | ω | Вт

_ 32 01

1.884 | 2.56 Pтаб | рас − | = | < | = Вт | Вт P

Следовательно, двигатель ДПР-32-01 нам не подходит. Рассчитаем

мощность для ДПР-42-03:

_ 42 03

0.005 471 2.335 Pтаб | ном | ном − | = | · | = | · | = M | ω | Вт

_ 42 03

2.335 | 2.56 Pтаб | рас − | = | < | = Вт | Вт P

Этот двигатель тоже не удовлетворяет заданному условию. Рассчитаем

мощность ДПР-42-02:

_ 42 02

0.005 628 3.14 Pтаб | ном | ном − | = | · | = | · | = M | ω | Вт

_ 42 02

3.14 | 2.56 Pтаб | рас − | = | > | = Вт | Вт P

Условие выполнено. Пересчитаем коэффициент запаса согласно формуле:

таб

рас

Р
Р

= ξ

Для ДПР-42-02:

_ 42 02 3.14
4.9
0.64

таб

рас

Р
Р

−
= =

Выбранный двигатель ДПР-42-02 удовлетворяет условию.

### 4. Расчёт общего передаточного отношения

Определим передаточное отношение общ i :

3

6000
471.238
60 | 60 0.03 10
| 45
дв | дв
общ
н н

n n
i
n | V
πd | π
= | = | = | =
- | · | ·
·

### 5. Расчёт динамического и статического приведённых моментов

3
45 10
4 8 | 0.72
2 | 2

н

d M | ξ F | Н м

−
·
= · · | = · · | = | ·
0

0.72
0.0036
471.238 0.42

н
с пр
общ
М M | Н м
i | η
= | = | = | ·
| · ·
. | 2
(1 | )

н
д пр | общ | м | p
общ

I
M | i | K | I
i

ε

æ | ö
= | · · | + | · | + ç | ÷
è | ø

2

(1 )

н
пр | м | p
общ

I
I | K | I
i
= + | · | +
0.4...1 Kм = | - коэффициент, учитывающий инерционную способность.

p

I – момент инерции ротора собственного зубчатого механизма.

2 | 7 | 2
0.0057 | 5.7 10 p
I | кг см | кг м ⁻
= | · | = | · | ·

н

I – момент инерции нагрузки.

2 | 2
0 | 2

.045
1 | 0.0005
2 | 2

н

d
I | m | кг м
æ ö | æ | ö
= | · | = · | = | · ç ÷ | ç | ÷ è ø | è | ø

н

ε – угловое ускорение нагрузки.

2 | 2 | 2
44.44 | /
| 0.045

н

a
рад с
d
ε = | = | =
7 | 6 | 2
2 | 2

0.0005
(1 | ) | (1 1) 5.7 10 | 1.14 10
471.238

н
пр | м | p
общ

I
I | K | I | кг м
i
− | − = + | · | + | = + · | · | + | = | · | ·

Произведём расчёт:

. | 2

7
. | 2

6

(1 )

0.0005
471.328 44.44 (1 1) 5.7 10 471.238
471.328 44.44 1.14 10 0.0239

н
д пр | общ | м | p
общ

д пр

I M | i | K | I
i

M

Н м

ε

−

−

æ | ö
= | · · | + | · | + ç | ÷
è | ø
æ | ö
= | · | · | + · | · | + | = ç | ÷ è | ø
= | · | · | · | = | ·
0

0.72
0.0036
471.238 0.42

н
с пр
общ
М M | Н м
i | η
= | = | = | ·
| · ·

(определяем по Таблице 1)

0.0036 0.0239 0.0275

0.022 0.0275

п М | М | М | Н м дв | с пр | д пр ≥ | + | = | + | = | ·

<

Проверка не выполнена. Поменяем двигатель.

Возьмем двигатель серии ДПР-42-01:

1. | ( | ) 0.03(8 1) 0.27 Pн = | + | = | + = V F ma | Вт.

2.

0.27
0.64
0.6 0.7

н
рас
р

P
P | Вт
η
= | = | =
·

Выберем коэффициент запаса 4.9.

Pрас(ξ) = | Pн ηр
⋅ ξ =
| | 0.27 0.6⋅0.7
⋅ 4.9 = 3.15Вт.

3.
_ 42 01 | ( )
0.005 942 4.71 Pтаб | ном | ном | рас − | = | · | = | · | = | > M | ω | Вт P ξ

4.

_ 42 01 4.71
7.36
0.64

таб

рас

Р
Р

ξ

−
= | = | = | .

0.022

п М | Н м дв | = | ·

### 6. Расчёт общего передаточного отношения

3

9000
60 60

706.8
0.03 10
45

58

дв | дв
общ
н н

n n
i
n | V
πd | π
= | = | = | =
- | · | ·
·

### 7. Расчёт динамического и статического приведённых моментов

3
45 10
4.9 8 | 0.882
2 | 2

н

d M | ξ F | Н м

−
·
= · · | = | · · | = | ·
0

706.8

0.882
0.00297
58 0.42

н
с пр
общ
М M | Н м
i | η
= | = | = | ·
| · ·

. | 2
(1 | )

н
д пр | общ | м | p
общ

I
M | i | K | I
i

ε

æ | ö
= | · · | + | · | + ç | ÷
è | ø

2

(1 )

н
пр | м | p
общ

I
I | K | I
i
= + | · | + | .
0.4...1 Kм = | – коэффициент, учитывающий инерционную способность

собственного зубчатого механизма.

p

I – момент инерции ротора собственного зубчатого механизма.

2 | 7 | 2
0.0057 | 5.7 10 p
I | кг см | кг м ⁻
= | · | = | · | · | (определяем по таблице 1)

н

I – момент инерции нагрузки.

2 | 2
0 | 2

.045
1 | 0.0005
2 | 2

н

d
I | m | кг м
æ ö | æ | ö
= | · | = · | = | · ç ÷ | ç | ÷ è ø | è | ø

н

ε – угловое ускорение нагрузки.

2 | 2 | 2
44.44 | /
| 0.045

н

a
рад с
d
ε = | = | =
7 | 6 | 2
2 | 2

0.0005
(1 | ) | (1 0.8) 5.7 10 | 1.027 10
706.858

н
пр | м | p
общ

I
I | K | I | кг м
i
− | − = + | · | + | = + | · | · | + | = | · | ·

Рассчитаем

. | 2

7
. | 2

6

(1 )

0.0005
44.44 (1 0.8) 5.7 10
706.858
706.858 44.44 1

706

.027 10 0.0322609

.858

н
д пр | общ | м | p
общ

д пр

I M | i | K | I
i

M

Н м

ε

−

−

æ | ö
= | · · | + | · | + ç | ÷
è | ø
æ | ö
= | · | · | + | · | · | + | = ç | ÷ è | ø
= | · | · | · | = | ·
0

0.882
0.00297
706.858 0.42

н
с пр
общ
М M | Н м
i | η
= | = | = | ·
| · ·

2
360 10 | 0,036
п М | Н см | Н м дв
−
= | · | · | = | · | (определяем по Таблице 1)

0.00297 0.0322609 0.0352309

0.036 0.0352309

п М | М | М | Н м дв | с пр | д пр ≥ | + | = | + | = | ·

>

Неравенство выполнено. Пусковой момент большем, чем сумма

статического и динамического приведённых моментов.

Таким образом, выбрали двигатель ДПР-42-01.

### 8. Выбор двигателя

Характеристики электродвигателя ДПР-42-01 представлены в таблице 2.

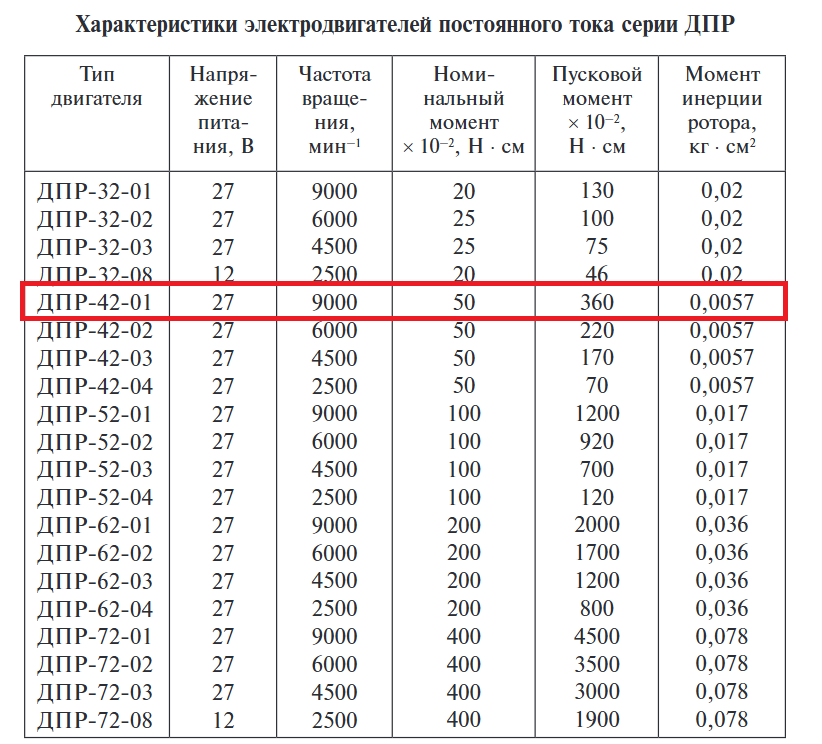
[picture p1: figure]

Таблица 2 – Двигатели серии ДПР.

### 9. Габаритные и установочные размеры

Исходя из требования минимальных габаритов выберем по таблице 3

нужный | нам | двигатель, | ДПР-42-Н1, | Н2, | Ф1, | Ф2.

Источник: «Расчет электромеханического привода» Ю.А. Кокорев, В.В. Жаров,

А.М. Торгов 1995 г., страница 111.

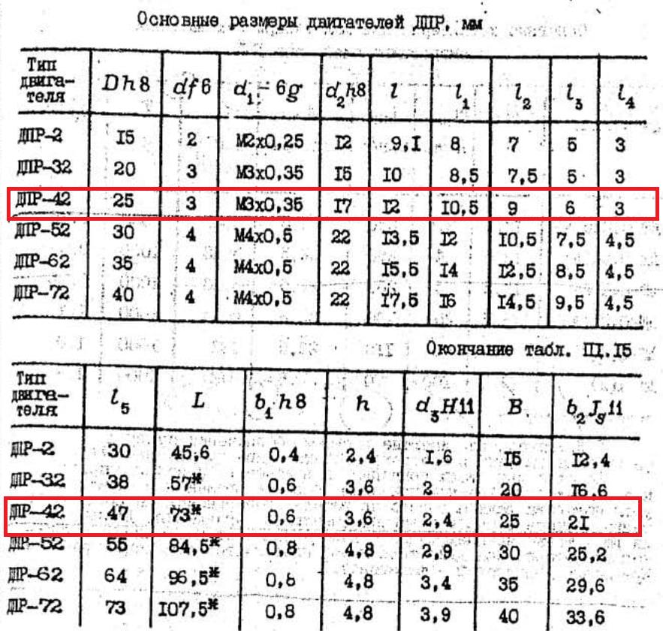
[picture p2: figure]

Таблица 3 – Габаритные и установочные размеры и масса двигателей ДПР.

Будем использовать фланцевое исполнение Ф, представленной на рисунке 1.

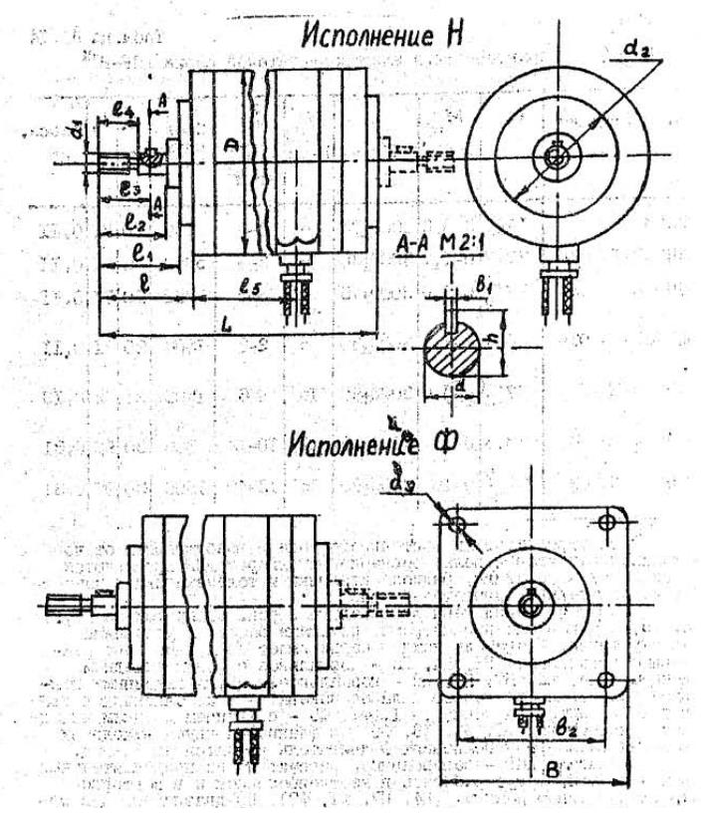
[picture p3: figure]

Рисунок 1 — Фланцевое исполнение двигателя

### 10. Кинематический расчёт

3

9000
60 60

706,8
0,03 10
45

58

дв | дв
общ
н н

n n
i
n | V
πd | π
= | = | = | =
- | · | ·
·
Определение схемотехнического состава ЭМП:

Назначим передаточное отношение одной ступени:

4
ц

i =

Оптимальное число ступеней по табл. 4 согласно критерию минимальных

габаритов:

0

n = | = 1,85lgi | 1,85lg706,858 = 5,271

Тогда n = 5

Назначим передаточное отношение для каждой ступени:

5 | 5 706,858 3,71 n | oбш i = | = | = i

Выберем близкие к приближенному среднему значению передаточного

числа возрастающие значения передаточных чисел ступеней:

12

34

56

78

910
12 | 34 | 56 | 78

3,5
3,55
3,6
3,65

4,3295
3,5 3,5

706
5 3,6 3,6

,858
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
i i | i | i

=
=
=
=
= | = | =
- | · | · | · | · | ·

Возьмем для нечетных(ведущих) зубчатых колёс число зубьев, равное 19,

то есть:

1 | 3 | 5 | 7 | 9
z = | = | = | = | = z | z | z | z | 19

Для четных(ведомых) зубчатых колёс вычислим число зубьев:

2 | 1 | 12 | 2
4 | 3 | 34 | 4
6 | 5 | 56 | 6
8 | 7 | 78 | 8
19 3,5 66,6 | 67
19 3,55 67,45 | 68
19 3,6 68,4 | 69
19 3,65 69,35 | 70
z | z i | z
z | z i | z
z | z i | z
z | z i | z
= · | = | · | = | Þ | =
= | · | = | · | = | Þ | =
= | · | = | · | = | Þ | =
= | · | = | · | = | Þ | =

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
3,53
19
68
3,58
19
69
3,63
19
70
3,68
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
= | = | =
= | = | =
= | = | =
= | = | =

910
12 | 34 | 56 | 78
10 | 9 | 910 | 10

4,19
3,53 3,58 3,63 3,68
19 4,19 79,61

706

80

i
| | общ | | | ,858
i
| i i | i | i
z | z i | z
= | = | =
- | · | · | · | · | ·
= | · | = | · | = | Þ | =
12 | 34 | 56 | 78 | 910

3,5

8
3

0
710,802
1

3,58 3,63 3,68
9

ф

i = | · | · | · | · i i | i | i | i | = | · | · | · | · | =

Тогда погрешность:

710,802 706,858
100% | 100% 0,56%
706,858
ф | oбщ
| oбщ
i | i
i
i
− | −
Δ = | · | = | · | =

### 11. Геометрический расчёт

Рассчитаем моменты на валах:

2

2
3 | 3

3

5
9 10 9 10

2
2 | 2 | 2
45 10 | 45 10 | 2 1
2 8 | 1 | 0,3825 | 382,5 | ,
2 | 2 | 45 10
где | 2

382,5

382,5
| | 93,62
4,19 0,98 0,995
i | i
ВЫХ | ст | дин | Д | i | н | вых | Д | i

Д

ВЫХ

ВЫХ

опор

d | d | d | a M | M | M | F | J | F | m
d
Н м | Н мм
M | Н мм

M
M | Н
i
ξ | ε | ξ

ξ

η | η
− | −

−

− | −

æ ö
∑
= | + | = | · | · | + | · | = | · | · | + · | · | = ç ÷ è ø
- | · | · æ | ö
= · · | + · | · | = | · = | · ç | ÷
- è | ø

=

= | · ∑
∑ = | = | = | ·
- | · | · | ·

5
4
7 8 | 7 8
| 4
3
5 6 | 5 6
| 3
2
3 4 | 3 4
| 2
1
1 2 1 2

93,62
26,09
3,68 0,98 0,995

26,09
7,37
3,63 0,98 0,995

7,37
2,11
3,58 0,98 0,995

2,11
0,61
3,53 0,98 0,995

опор

опор

опор

опор

мм

M
M | Н мм
i

M
M | Н мм
i

M
M | Н мм
i

M
M | Н м
i
η | η
η | η
η | η

η η

− | −
− | −
− | −
− | −
= | = | = | ·
- | · | · | ·
= | = | = | ·
- | · | · | ·
= | = | = | ·
- | · | · | ·
= | = | = | ·
- | · | · | ·

1

0,61 | 5 | 36 н | пуск

м

M = | · | < | = | · | < | = | · Н мм M | Н мм M | Н мм

Таким образом, мощности двигателя достаточно для вращения редуктора.

Выберем материал для шестеренок и для зубчатых колёс, согласно таблице 4.

Для шестерни выберем легированную сталь Ст40Х:

1 | 40
1 | 40
40
( | ) | (0.35 | (70...120)) 0,35 1000 90 440
( | ) | 440
[ | ] | | 220
| | | 2
Ст | Х | в
Ст | Х
F Ст | Х

МПа

МПа
n
σ | σ

σ
σ

−

−

= | · | + | = | · | + | =
= | = | =

Для зубчатого колеса выберем конструкционную сталь Ст55:

1 | 55
1 | 55
55
( | ) | 0.43 | 0,43 900 387
( | ) | 387
[ | ] | | 193,5
| | | 2
Ст | в

Ст
F Ст

МПа

МПа
n
σ | σ

σ
σ

−

−

= | · | = | · | =
= | | = | =

Прежде чем рассчитывать модуль, рассчитаем соотношение:

4,175
0,01898
[ | ] | 220

F

F ш

Y
σ
é | ù
ê | ú = | =
ë | û

для шестерни.

| | 3,73
0,0192
[ | ] | 193,5

F

F к

Y
σ
é | ù
ê | ú = | =
ë | û

для колеса, где коэффициент YF

берем по таблице

5.

Сравним:

0,01898 | 0,0192
[ | ] | [ | ]
F | F
F | ш | к F
Y | Y
σ | σ
é | ù | é | ù
ê | ú | ê | ú = | < | = | Þ
ë | û | ë | û

будем вести расчёт модуля по

колесу.

Так как имеем консольное расположение первого колеса и ведется расчёт

на изгибную прочность, то коэффициент расчётной нагрузки:

1,17 1,2 1,404, где

1,17

1,2

FV F

F

FV

K K K

K

K

β

β

= | · | = | · | =

=

=

Рассчитаем модуль колеса:

[ ]

[ ]

3

2
3 | 3
1 2
2

2

2 | 2 1,404 2,11 3,73
0,059728 | 0,3
67 8 193,5

F

bm F

F

bm F

K M Y
m
z

K M Y
m | мм | мм
z
ψ | σ
ψ | σ

−

- | · | ·
=
- ·
- | · | · | · | · | ·
= | = | = | <
- | · | · ·

Тогда возьмем модуль 1 2 m− = 0,35мм .

Диаметр делительной окружности первой шестерни:

1 | 1 2 | 1
d = | · = | · | = m−
| z | 19 0,35 6,65мм
* | * | *
* | *
( | 2 | ) | ( | 2 ( | )) 0,35 (19 2 (1 0,5)) 5,6 | , где
1 и | 0,5
f | f | a

a

d | m z | h | m z | h | c | мм
h | c
= · | − · | = · | − · | + | = | · | − · + | =
= | =
Проверим условие | 0,6 Rf − >l | , где l = 2,1- расстояние от центра вала до

вершины шпонки.

2,8 2,1 0,7 0,6 Rf − = | − | = | > l

Так, условие выполняется, и мы можем насадить колесо на вал со

шпонкой (рис.2).

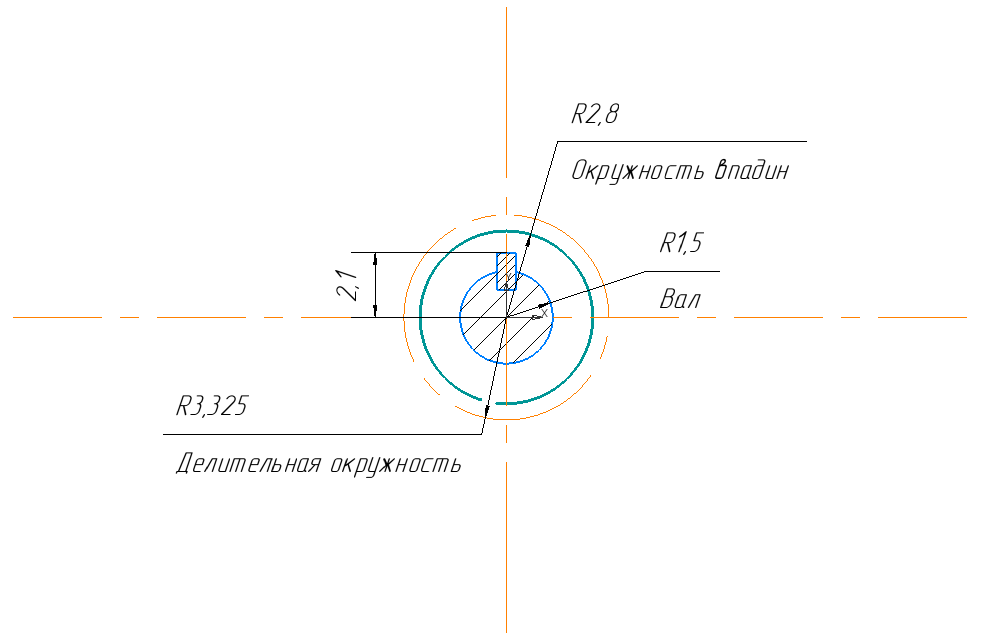
[picture p4: figure]

Рисунок 2 — Расположение первой шестерни на валу со шпонкой

Рассчитаем модули остальных передач:

[ ]

[ ]

[ ]

3
3 | 3
3 4
4

4
3 | 3
5 6
6

5
3 | 3
7 8
8
2 | 2 1,404 7,37 3,73
0,09 | 0,3
68 8 193,5
2 | 2 1,404 26,09 3,73
0,14 | 0,3
69 8 193,5
2 | 2 1,404 93,62 3,73
0,21 | 0,3
70 8 193,5

F

bm F

F

bm F

F

bm F

K M Y
m | мм | мм
z

K M Y
m | мм | мм
z

K M Y
m | мм | мм
z
ψ | σ
ψ | σ
ψ | σ

−

−

−

- | · | · | · | · | ·
= | = | = | Þ
- | · | · ·
- | · | · | · | · | ·
= | = | = | Þ
- | · | · ·
- | · | · | · | · | ·
= | = | = | Þ
- | · | · ·

[ ]

3 | 3
9 10
10
2 | 2 1,404 382,5 3,73
0,32 | 0,35
80 8 193,5
ВЫХ | F
bm | F
K M | Y
m | мм | мм
z ψ | σ

Σ
−
- | · | · | · | · | ·
= | = | = | Þ
- | · | · ·

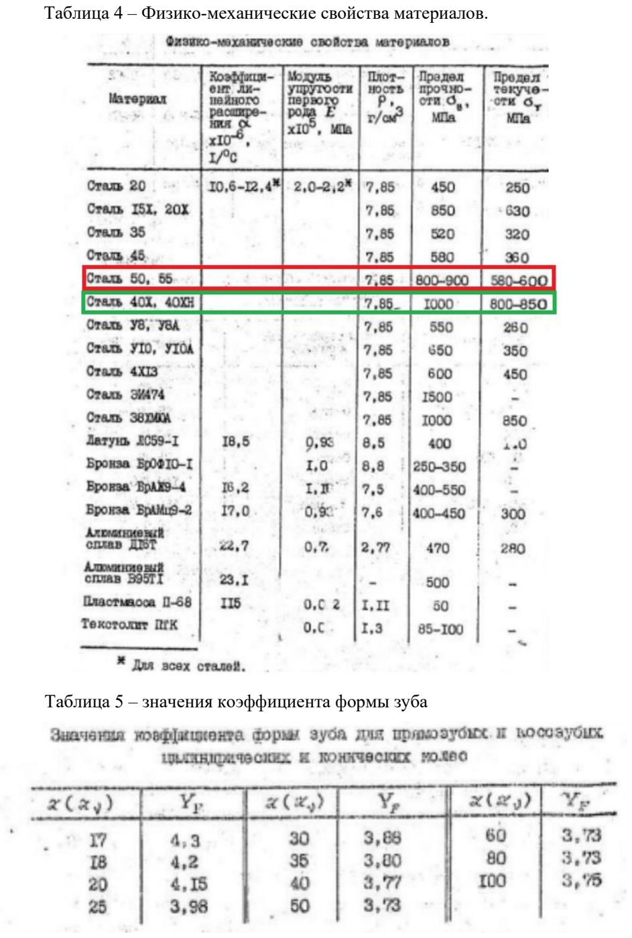
[picture p5: page 17]

Таблица 4 – Физико-механические свойства материалов.

Таблица 5 – значения коэффициента формы зуба

Проведем расчет геометрических параметров зубчатых колёс:

1. Первая шестерня.

Модуль:

1 2 m− = 0,35мм

Делительная окружность:

1 | 1 2 | 1
d = | · = | · | = m−
z | 0,35 19 6,65мм

Окружность впадин

* | * | *
1 | 1 2 | 1 | 1 2 | 1
( | 2 | ) | ( | 2 ( | ))
0,35 (19 2 (1 0,5)) 5,6 | ,
f | f | a
d | m | z | h | m | z | h | c
| | | | | мм
= | · | − · | = | · | − · | + | = − | −
= | · | − · + | =
где * | *
1 и | 0,5 a
h = | = c

Окружность вершин

1 | 1 | 1 2
2 | 6,65 2 0,35 7,35 a
d = | + | = | + · | = d | m− | мм

Ширина зубчатого венца:

1 | 1 2 | 1 2

8 0,35 0,35 3,15 bm

b = | · | + | = · | + | = ψ | m− | − m | мм
2. Второе колесо.

Модуль:

1 2 m− = 0,35мм

Делительная окружность:

2 | 1 2 | 2
d = | · | = | · | = m−
z | 67 0,35 23,45мм

Окружность впадин:

* | * | *
2 | 1 2 | 2 | 1 2 | 2
( | 2 | ) | ( | 2 ( | ))
0,35 (67 2 (1 0,5)) 22,4 | ,
f | f | a
d | m | z | h | m | z | h | c
| | | | | мм
= | · | − · | = | · | − · | + | = − | −
= | · | − · + | =
где * | *
1 и | 0,5 a
h = | = c

Окружность вершин:

2 | 2 | 1 2
2 | 23,45 2 0,35 24,15 a
d = | + | = | + · | = d | m− | мм

Ширина зубчатого венца:

2 | 1 2

8 0,35 2,8 bm

b = | · | = · | = ψ | m− | мм
3. Третья шестерня:

Модуль:

3 4 m − = 0,3мм

Делительная окружность:

3 | 3 4 | 3
d = | · | = | · | = m −
z | 0,3 19 5,7мм

Окружность впадин:

* | * | *
3 | 3 4 | 3 | 3 4 | 3
( | 2 | ) | ( | 2 ( | ))
0,3 (19 2 (1 0,5)) 4,8 | ,
f | f | a
d | m | z | h | m | z | h | c
| | | | | мм
= | · | − · | = | · | − · | + | = − | −
= | · | − · + | =
где * | *
1 и | 0,5 a
h = | = c

Окружность вершин:

3 | 3 | 3 4
2 | 5,7 2 0,3 6,3 a
d = | + | = | + · | = d | m − | мм

Ширина зубчатого венца:

3 | 3 4 | 3 4

8 0,3 0,3 2,7 bm

b = | · | + | = · | + | = ψ | m − | − m | мм
4. Четвертое колесо:

Модуль:

3 4 m − = 0,3мм

Делительная окружность:

4 | 3 4 | 4
d = | · | = | · | = m −
z | 68 0,3 20,4мм

Окружность впадин:

* | * | *
4
( | 2 | ) | ( | 2 ( | ))
0,3 (68 2 (1 0,5)) 19,5 | ,
f | f | a
d | m z | h | m z | h | c

мм

= · | − · | = · | − · | + | =
= | · | − · + | =
где * | *
1 и | 0,5 a
h = | = c

Окружность вершин:

4 | 4 | 3 4
2 | 20,4 2 0,3 21 a
d = | + | = | + · | = d | m − | мм

Ширина зубчатого венца:

4 | 3 4

8 0,3 2,4 bm

b = | · | = · | = ψ | m − | мм
5. Пятая шестерня:

Модуль:

5 6 m − = 0,3мм

Делительная окружность:

5 | 5 6 | 3
d = | · | = | · | = m −
z | 0,3 19 5,7мм

Окружность впадин:

* | * | *
5
( | 2 | ) | ( | 2 ( | ))
0,3 (19 2 (1 0,5)) 4,8 | ,
f | f | a
d | m z | h | m z | h | c

мм

= · | − · | = · | − · | + | =
= | · | − · + | =
где * | *
1 и | 0,5 a
h = | = c

Окружность вершин:

5 | 5 | 5 6
2 | 5,7 2 0,3 6,3 a
d = | + | = | + · | = d | m − | мм

Ширина зубчатого венца:

5 | 5 6 | 5 6

8 0,3 0,3 2,7 bm

b = | · | + | = · | + | = ψ | m − | − m | мм
6. Шестое колесо:

Модуль:

5 6 m − = 0,3мм

Делительная окружность:

6 | 5 6 | 6
d = | · | = | · | = m −
z | 0,3 69 20,7мм

Окружность впадин:

* | * | *
6 | 5 6 | 6 | 5 6 | 6
( | 2 | ) | ( | 2 ( | ))
0,3 (69 2 (1 0,5)) 19,8 | ,
f | f | a
d | m | z | h | m | z | h | c
| | | | | мм
= | · | − · | = | · | − · | + | = − | −
= | · | − · + | =
где * | *
1 и | 0,5 a
h = | = c

Окружность вершин:

6 | 6 | 5 6
2 | 20,7 2 0,3 21,3 a
d = | + | = | + · | = d | m − | мм

Ширина зубчатого венца:

6 | 3 4

8 0,3 2,4 bm

b = | · | = · | = ψ | m − | мм
7. Седьмая шестерня

Модуль:

7 8 m − = 0,3мм

Делительная окружность:

7 | 7 8 | 7
d = | · | = | · | = m −
z | 0,3 19 5,7мм

Окружность впадин:

* | * | *
7 | 7 8 | 7 | 7 8 | 7
( | 2 | ) | ( | 2 ( | ))
0,3 (19 2 (1 0,5)) 4,8 | ,
f | f | a
d | m | z | h | m | z | h | c
г ед | мм
= | · | − · | = | · | − · | + | = − | −
= | · | − · + | =
где * | *
1 и | 0,5 a
h = | = c

Окружность вершин:

7 | 7 | 7 8
2 | 5,7 2 0,3 6,3 a
d = | + | = | + · | = d | m − | мм

Ширина зубчатого венца:

7 | 7 8 | 7 8

8 0,3 0,3 2,7 bm

b = | · | + | = · | + | = ψ | m − | − m | мм
8. Восьмое колесо:

Модуль:

7 8 m − = 0,3мм

Делительная окружность:

8 | 7 8 | 8
d = | · | = | · | = m −
z | 0,3 70 21мм

Окружность впадин:

* | * | *
8 | 7 8 | 8 | 7 8 | 8
( | 2 | ) | ( | 2 ( | ))
0,3 (70 2 (1 0,5)) 20,1 | ,
f | f | a
d | m | z | h | m | z | h | c
| | | | | мм
= | · | − · | = | · | − · | + | = − | −
= | · | − · + | =
где * | *
1 и | 0,5 a
h = | = c

Окружность вершин:

8 | 8 | 7 8
2 | 21 2 0,3 21,6 a
d = | + | = | + · | = d | m − | мм

Ширина зубчатого венца:

8 | 7 8

8 0,3 2,4 bm

b = | · | = · | = ψ | m − | мм
9. Девятая шестерня

Модуль:

9 10 m − = 0,35мм

Делительная окружность:

9 | 9 10 | 9
d = | · | = | · | = m −
z | 0,35 19 6,65мм

Окружность впадин

* | * | *
9 | 9 10 | 9 | 9 10 | 9
( | 2 | ) | ( | 2 ( | ))
0,35 (19 2 (1 0,5)) 5,6 | ,
f | f | a
d | m | z | h | m | z | h | c
| | | | | мм
= | · | − · | = | · | − · | + | = − | −
= | · | − · + | =
где * | *
1 и | 0,5 a
h = | = c

Окружность вершин

9 | 9 | 9 10
2 | 6,65 2 0,35 7,35 a
d = | + | = | + · | = d | m − | мм

Ширина зубчатого венца:

1 | 1 2 | 1 2

8 0,35 0,35 3,15 bm

b = | · | + | = · | + | = ψ | m− | − m | мм

10.Десятое колесо

Модуль:

9 10 m − = 0,35мм

Делительная окружность:

10 | 9 10 | 9
d = | · | = | · | = m −
z | 0,35 80 28мм

Окружность впадин:

* | * | *
10 | 9 10 | 10 | 9 10 | 10
( | 2 | ) | ( | 2 ( | ))
0,35 (80 2 (1 0,5)) 26,95 | ,
f | f | a
d | m | z | h | m | z | h | c
| | | | | мм
= | · | − · | = | · | − · | + | = − | −
= | · | − · + | =
где * | *
1 и | 0,5 a
h = | = c

Окружность вершин:

10 | 10 | 9 10
2 | 28 2 0,35 28,7 a
d | = | + | = | + · | = d | m − | мм

Ширина зубчатого венца:

10 | 9 10

8 0,35 2,8 bm

b = | · | = · | = ψ | m − | мм

Геометрические параметры зубчатых колёс приведены в таблице 6.

Таблица 6 – Геометрические параметры зубчатых колёс

| z | d, мм | da , мм | d f , мм | b, мм | m, мм
1 | 19 | 6,65 | 7,35 | 5,6 | 3,15 | 0,35
2 | 67 | 23,45 | 24,15 | 22,4 | 2,8 | 0,35
3 | 19 | 5,7 | 6,3 | 4,8 | 2,7 | 0,3
4 | 68 | 20,4 | 21 | 19,5 | 2,4 | 0,3
5 | 19 | 5,7 | 6,3 | 4,8 | 2,7 | 0,3
6 | 69 | 20,7 | 21,3 | 19,8 | 2,4 | 0,3
7 | 19 | 5,7 | 6,3 | 4,8 | 2,7 | 0,3
8 | 70 | 21 | 21,6 | 20,1 | 2,4 | 0,3
9 | 19 | 6,65 | 7,35 | 5,6 | 3,15 | 0,35
10 | 80 | 28 | 28,7 | 26,95 | 2,8 | 0,35

### 12. Проверочный расчёт

Проверка передач на контактную прочность:

[ ] 2,6 σ н = | HB - допустимое контактное напряжение
Ст55: | 212...248 | [ ] 2,6 220 572 HB = | Þ σ н = | · | = | МПа
Ст40Х: | 187...229 | [ ] 2,6 210 546 HB = | Þ σ н = | · | = | МПа (согласно марочнику,

стали и сплавов под ред. Сорокина В.Г., Гервасьева М.А., таблица 6, 7)

Таблица 6 – Твёрдость стали Ст55

Таблица 7 – Твёрдость стали Ст40Х

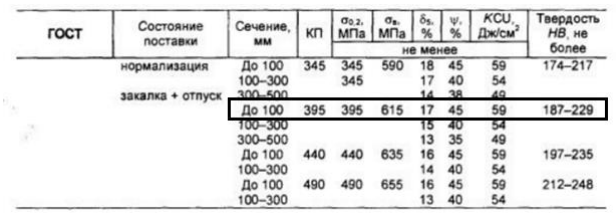
[picture p6: figure]

( )

max

3

9 | 10
108,5 | 1

7,35 28,7
18,025
2 | 2
0,9;
1,3
jk | k
k
H
w jk

w

k

z

i | kM
a i | b
d | d
a | мм

для прямозубых колёс z
k

σ

+
=
+ | +
= | = | =
| | =
=

Тогда:

( | )
( | )

max 10

3

3

108,5 | 1
108,5 0.9 | 4,19 1 | 1,3 382,5
203,7241
18,025 4,19 | | 2,8
jk | k
k
H
w jk

z

i | kM
a i | b

МПа

σ −

+
= | =
- | + | · | ·
= | =
·
( | )
( | )

max 9

3

3

108,5 | 1
108,5 0.9 | 4,19 1 | 1,3 382,5
192,07291
18,025 4,19 | 3,15
jk | k
k
H
w jk

z

i | kM
a i | b

МПа

σ −

+
= | =
- | + | · | ·
= | =
·

Так как [ ] 55

max10

572
203,7241

2,81 2

н Ст

H

σ
σ
= | = | > | и

[ ] 40

max 9

546
192,07291

2,84 2

н Ст X

H

σ
σ
= | = | > , то для
остальных колес и шестерней условие σ | σ H max ≤ [ H ] будет выполнено.
- Проверка правильности выбора двигателя по КПД:
1 | 1
1 | ,
2

2,92
коэффициент нагрузки
0,174
2
окружная сила
коэффициент трения, | 0,05...0,15,принимаем | 0,07
коэффициент перекрытия, определяет плавность и непрерывность з

jk
j | k

jk

c | f
z | z

F
c
F
M
F
d
f | f | f

ν

ν

πε
η

ε

æ | ö
= − | + ç | ÷
è | ø

+
= | −
+
= | −
− | = | =
−
ацепления в передаче;
1,5 для приборостроения. ν ε =

10

10

9 10

2 382,5
25,5
30
25,5 2,92
1,11
25,5 0,174
1 | 1
1,11 | 1.5 0,07
19 80
1 | 0,988
2
F | Н

с

π
η −

·
= | =

+
= | =
+
æ | ö
- · | · | · | + ç | ÷ è | ø
= − | =

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
2 93,62
8,92
21
8,92 2,92
1,3
8,92 0,174
1 | 1
1,3 | 1.5 0,07
19 70
1 | 0,986
2
2 26,09
2,521
20,7
2,521 2,92
2,02
2,521 0,174
1 | 1
2,02 | 1.5 0,07
19 69
1 | 0,978
2
2 7,37
0,72
20,4
F | Н

с

F | Н

с

F | Н

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
= | =

+
= | =
+
| | æ | | | ö
- · | · | · | + ç | ÷ è | ø
= − | =

·
= | =

+
= | =
+
æ | ö
- · | · | · | + ç | ÷ è | ø
= − | =

·
= | =

3 4

0,72 2,92
4,07
0,72 0,174
1 | 1
4,07 | 1.5 0,07
19 68
1 | 0,955
2

π
η −

+
= | =
+
æ | ö
- · | · | · | + ç | ÷ è | ø
= − | =

2

2

1 2

1 2 | 3 4 | 5 6 | 7 8 | 9 10

2 2,11
0,18
23,45
0,18 2,92
8,76
0,18 0,174
1 | 1
8,76 | 1.5 0,07
19 67
1 | 0,902
2
0,902 0,955 0,978 0,986 0,988

0,8207 0,6 0,7 0,42 проверка выполнена

общ

F | Н

с

π
η
η | η η | η | η | η

−

− | − | − | − | −

·
= | =

+
= | =
+
æ | ö
- · | · | · | + ç | ÷ è | ø
= − | | | | | | =
= | · | · | · | · | = | · | · | · | · | =
= | > | · | = | Þ
- Проверка правильности выбора двигателя по М
| | | | | | | | пуск

с учётом ред J′ :

( | ) | ( | ) | ( | ) | ( | ) | ( | )

2
0
2 | 3 | 4 | 5 | 6 | 7 | 8 | 9 | 10
1 | 2 | 2 | 2 | 2 | 2
' | '
' | ( | ' | )

'

ст | дин | п

н
дин | дв | ред

ред
I II | I III | I IV | I V | I VI
M | M | M
J M | J | J
i
J | J | J | J | J | J | J | J | J
J | J
i | i | i | i | i

ε

− | − | − | − | −
+ | <
= · | + | +
+ | + | + | +
= | + | + | + | + | +

4
12

3

4
12 | 9 | 2
3 | 5 | 7

4
12 | 9 | 2
1 | 9

4
12 | 7 | 2
2

4
12
4

10 ;
32
7,85 /

2,7 7,85 5,7
10 2,197 10
32
3,15 7,85 6,65
10 4,748 10
32
2,8 7,85 23,45
10 6,53 10
32
2,4 7,85 20,4
10 3.2
32

b d
J

г см

J | J | J | кг м
J | J | | кг м
J | кг м

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
− | −
− | −
− | −

−

- · ·
= | ·

=

- | · | ·
= | = | = | · | = | · | ·
- | · | ·
= | = | · | = | · | ·
- | · | ·
= | · | = | · | ·
- | · | ·
= | · | = | ·
| | | | 7 | 2

4
12 | 7 | 2
6

4
12 | 7 | 2
8

4
12 | 7 | 2
10

12

12 | 34
12 | 34 | 56

10

2,4 7,85 20,7
10 3,4 10
32
2,4 7,85 21
10 3,6 10
32
2,8 7,85 28
10 1,33 10
32
3,53
3,53 3,58 12,6374
3,53 3

I II

I III

I IV

кг м

J | кг м
J | кг м
J | кг м
i | i
i | i i
i | i i | i

π

π

π

−

− | −
− | −
− | −

−

−

−

·

- | · | ·
= | · | = | · | ·
- | · | ·
= | · | = | · | ·
- | · | ·
= | · | = | · | ·
= | =
= | · | = | · | =
= | · | · | = | ·
12 | 34 | 56 | 78

,58 3,63 45,8738
3,53 3,58 3,63 3,68 168,8154 I V
i | i i | i | i
−
- =
= | · | · | · | = | · | · | · | =
( | ) | ( | ) | ( | ) | ( | ) | ( | )
( | ) | ( | )
12 | 34 | 56 | 78 | 9 10
2 | 3 | 4 | 5 | 6 | 7 | 8 | 9 | 10
1 | 2 | 2 | 2 | 2 | 2
7 | 9 | 7 | 9
9
2 | 2

80
3,53 3,58 3,63 3,68 710,802 19

'

6,53 10 | 2,197 10 | 3,2 10 | 2,197 10
4,748 10
3,53 | 12,6374

3,4 10

I VI

ред
I II | I III | I IV | I V | I VI
i | i i | i | i | i
J | J | J | J | J | J | J | J | J
J | J
i | i | i | i | i
− | −
− | − | − | − | −
− | − | − | −
−
= | · | · | · | · | = | · | · | · | · | =
+ | + | + | +
= | + | + | + | + | + | =
- | + | · | · | + | ·
= | · | + | + | +

·
+
( | ) | ( | ) | ( | )
7 | 9 | 7 | 9 | 7
2 | 2 | 2
8 | 10 | 8 | 2
2,197 10 | 3,6 10 | 4,748 10 | 1,33 10
45,8738 | | 168,8154 | | 710,802
5,93457 10 | 1,75672 10 | | 5,95214 10 кг м
− | − | − | − | −
− | − | −
+ | · | · | + | · | ·
+ | + | =
= | · | + | · | = | · | ·
2 | 2
0 | 0
7 | 8
2
' | ' | '

0,0005
44,44 706,858 5.7 10 | 5,95214 10 | 0,02
706,858
H | H
дин | дв | дв | ред | н | общ | дв | ред
J | J M | J | J | i | J | J
i | i

H мм

ε | ε
− | −
æ | ö | æ | ö
= | + | + | = | · | + | + | = ç | ÷ | ç | ÷ è | ø | è | ø
æ | ö
= | · | · | · | + | · | + | = | · ç | ÷ è | ø

3,6 0,02 3,62 | 5 Mст | дин | п ′ | ′ + | = | + | = | · | < | = | · | Þ M | Н мм M | Н мм | проверка
выполнена

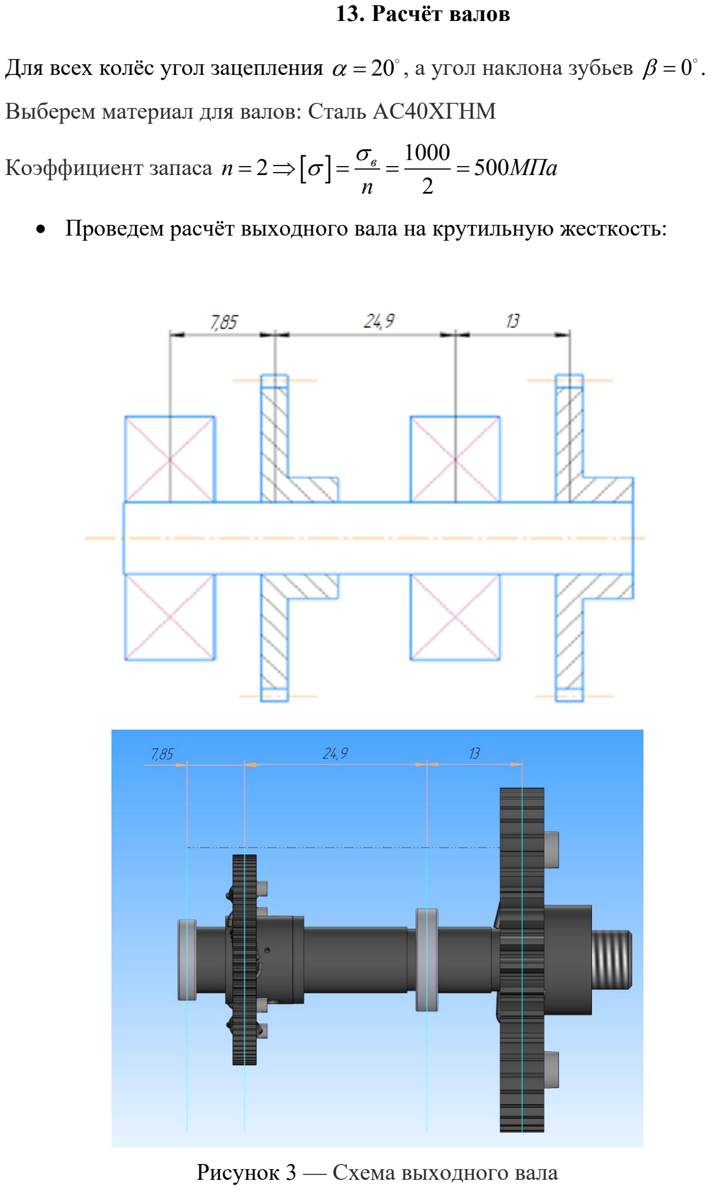
[picture p7: page 29]

### 13. Расчёт валов

Для всех колёс угол зацепления α = 20 | , а угол наклона зубьев | β = 0 .

Выберем материал для валов: Сталь АС40ХГНМ

Коэффициент запаса | [ ]
| 1000
2 | 500
| 2
в n | МПа
n

σ
= Þ σ = | = | =
- Проведем расчёт выходного вала на крутильную жесткость:

Рисунок 3 — Схема выходного вала

[ ]

4
6

4
6 | 5

64

64 382,5 24,9
4,5186 мм
0,8 10 0,005818

Мк раб l
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
≥ | =
- | · | ·

Таким образом, будем считать диаметр выходного вала 6
d = 9 мм.
- Проведем расчёт пятого вала на крутильную жесткость и прочность:

[ ]

5
4
5

4
5 | 5

64

64 93,62 11,675
2,6299 мм
0,8 10 0,005818

Мкр раб l
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
≥ | =
- | · | ·

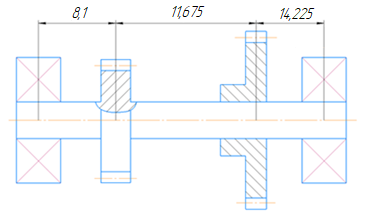
[picture p8: figure]
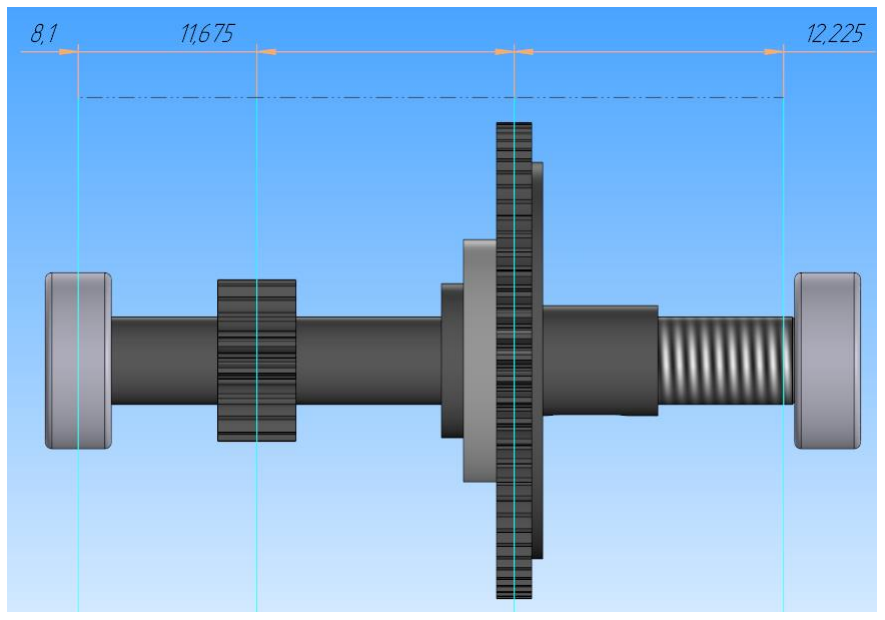
[picture p9: figure]

Рисунок 4 — Схема пятого вала

На прочность:

[ ]

5
3
5
0,1

Мпр d
σ

≥
·
2 | 2
5 | 5
0,75 М | М | М
пр | изг | кр
= | + | ·
9 | 5

9

9
9
9 | 9
9 | 9
9 | 9
8 | 5

8

2 | 2 93,62
28,1564
6,65

28,1564 (20 )
10,2481
cos | cos(0 )

3
cos(30 ) | 10,2481 | 8,875
2
| 1
cos(60 ) 10,2481 | 5,1241
| 2
0
2 | 2 93,62
| 8,9162
21

кр
окр

окр
r

В
r | r

Г
r | r
a | окр

окр

M
F | Н
d
F | tg | tg
F | Н
F | F
F | F
F | F | tg | Н
M F | Н
d

α
β

β

·
= | = | =
- | · | °
= | = | =
°
= − | · | ° = − | · | = −
= | · | ° = | · =
= | · | =

·
= | = | =

8
8
8 | 8
8 | 8
tan | 8,9162 tan(20 )
3,2452
cos | cos(0 )
| 1
cos(60 ) 3,2452 | 1,6226
| 2
3
cos(30 ) | 3,2452 | 2,8104
2

окр
r

В
r | r

Г

r | r F
F | Н
F | F
F | F α
| β
- | · | °
= | = | =
| | °
= | ° = | · =
= − | ° = − | = −
8 | 8
tan | 0 Fa = | · | = Fокр | β | Н

Тогда в вертикальной и горизонтальной плоскостях:

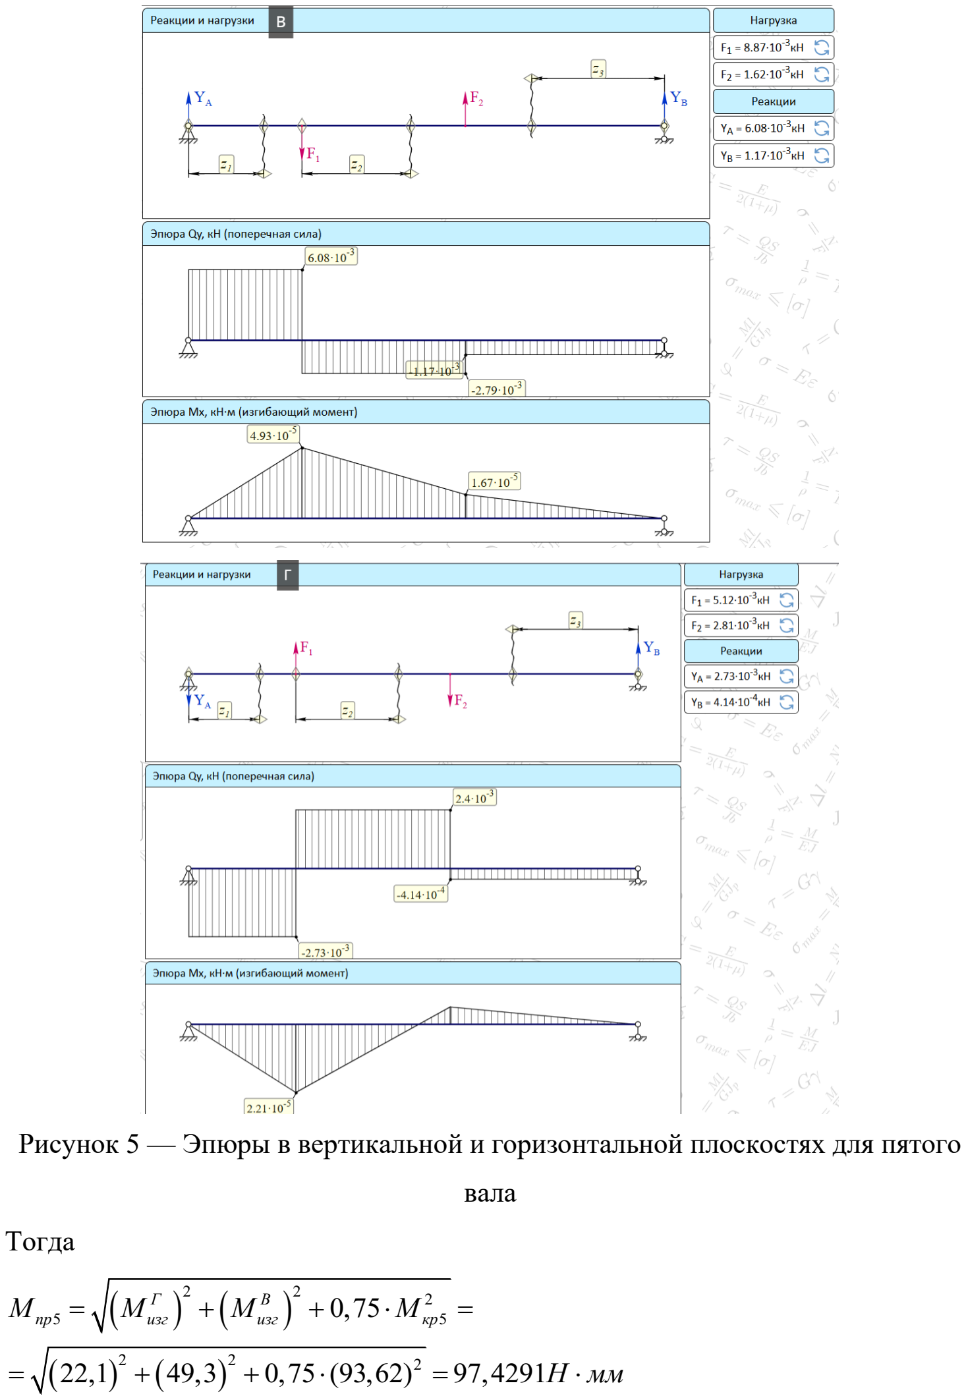
[picture p10: page 32]

Рисунок 5 — Эпюры в вертикальной и горизонтальной плоскостях для пятого

вала

Тогда
( | ) ( | )
( | ) ( | )
2 | 2
2
5 | 5
2 | 2 | 2
22,1

0,75

49,3 | 0,75 (93,62) | 97,4291
Г | В Мпр | Мизг | Мизг | Мкр

Н мм

= | + | + | · | =
= | + | + | · | = | ·

[ ]

5
3 | 3
5 | 97,4291
| 1,24903
0,1 | 0,1 500

Мпр
d | мм
σ
≥ | = | =
| · ·

Таким образом, возьмем диаметр пятого вала 5
d = 4мм.
- Проведем расчёт четвёртого вала на крутильную жесткость и
| прочность:

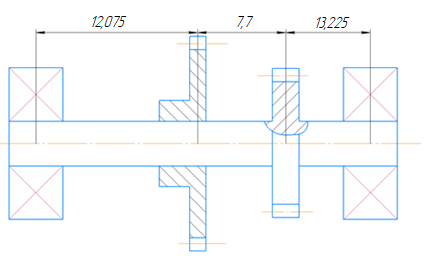
[picture p11: figure]
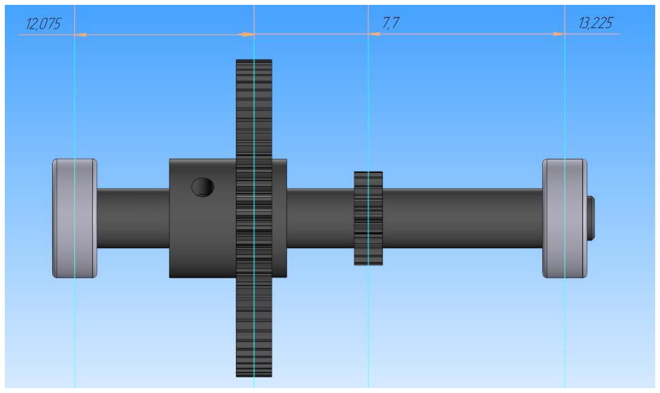
[picture p12: figure]

Рисунок 6 — Схема четвертого вала

[ ]

4
4
4

4
4 | 5

64

64 26,09 7,7
1,722 мм
0,8 10 0,005818

Мкр раб l
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
≥ | =
- | · | ·

На прочность:

[ ]

4
3
4
2 | 2
7 | 4

7

7
7
7 | 7
4 | 4
2 | 2 26,09
9,1544
5,7

9,1544 (20 )
3,3319
cos | cos(0 )
1
cos(60 ) 9,15

0,1

0

44 | 4,5772

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
r | r

пр

пр | изг | кр
M
F | Н
d
F | tg | tg
F | Н
F | F

М
d

М

Н

М | М

α
β

σ

·
= | = | =
- | · | °
= | = | =
°
= − | · | ° =

≥
·
= | + | ·
− | · = −
6 | 4

6

6
6
6 | 6
6 | 6
6 | 6
2 | 2 26,09
2,5208
20,7

tan 2,5208 tan(20 )
0,9175
cos | cos(0 )

2
cos(45 ) | 0,9175 | 0,6488
2
2
cos(45 ) | 0,9175 | 0,6488
2
tan 0

окр

окр
r

В
r | r

Г
r | r
a | окр
M F | Н
d

F
F | | Н
F | F | Н
F | F | Н
F | F | Н

α
β

β

·
= | = | =
- | · | °
= | = | | =
°
= − | ° = − | · | = −
= − | ° = − | | = −
= | · | =

Отсюда выполним расчёт эпюр:

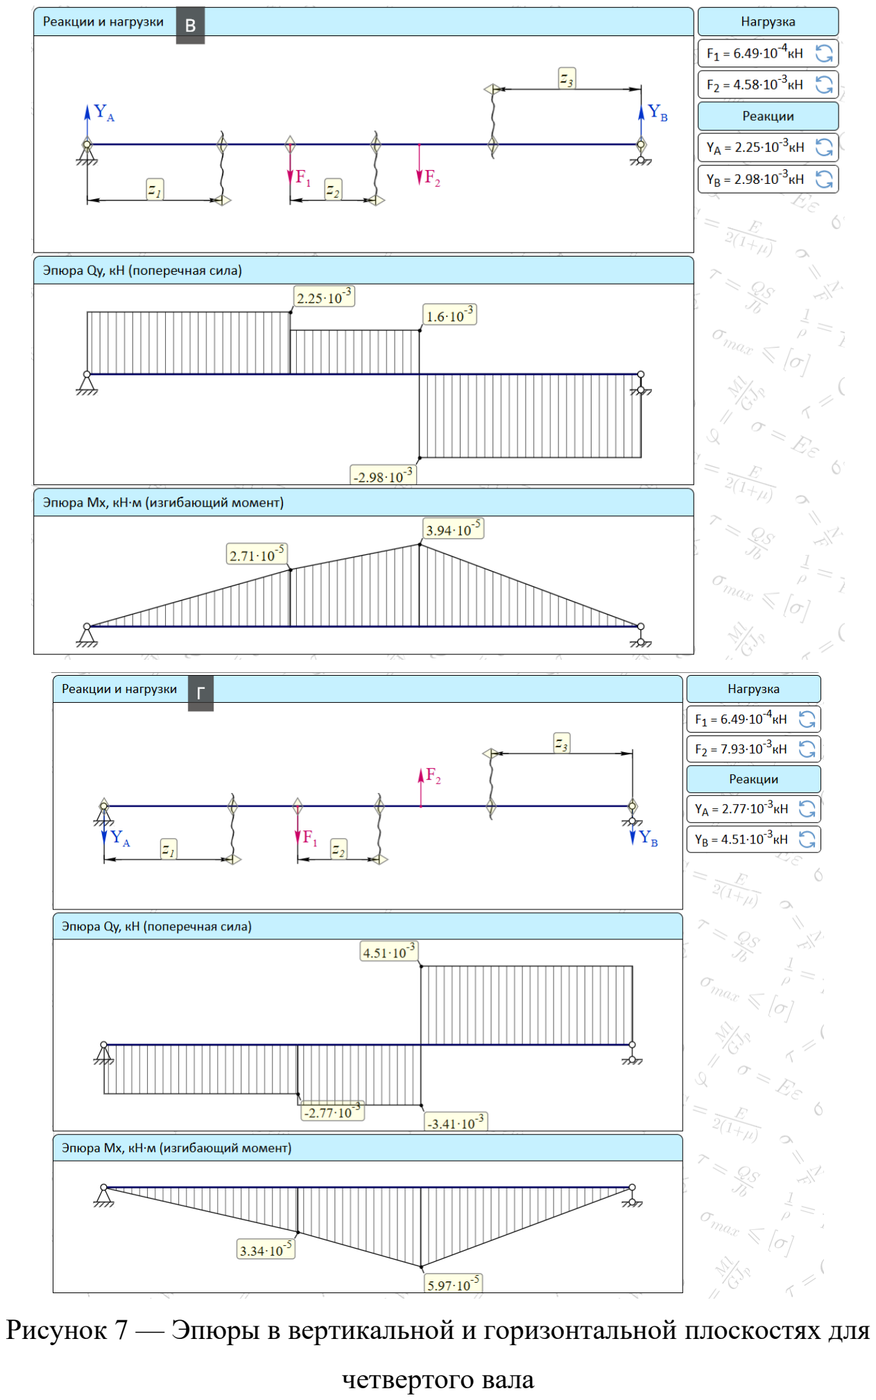
[picture p13: page 35]

Рисунок 7 — Эпюры в вертикальной и горизонтальной плоскостях для

четвертого вала

Тогда:
( | ) ( | )
( | ) ( | )
| 2 | 2
2
4 | 4
2 | 2 | 2
| | 0,75
59,7 | 39,4 | 0,75 (26,09) | 75,0131
Г | В М | М | М | М пр | изг | изг | кр

Н мм

= | + | + | · | =
= | + | + | · | = | ·

[ ]

| 4
3 | 3
4 | | 71,0131
1,1241
0,1 | 0,1 500
Мпр d | мм
σ
≥ | = | =
| · ·

Таким образом, назначим диаметр четвертого вала 4
d = 4мм.
- Проведем расчёт третьего вала на крутильную жесткость, прочность и

изгиб:

[ ]

3
4
3

4
3 | 5

64

64 7,37 4,55
1,0007 мм
0,8 10 0,005818
М | l кр | раб d
G

d

π φ

π

- ·
≥
- ·
- | · ≥ | =
- | · | ·

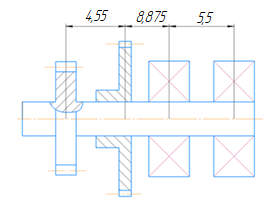
[picture p14: figure]
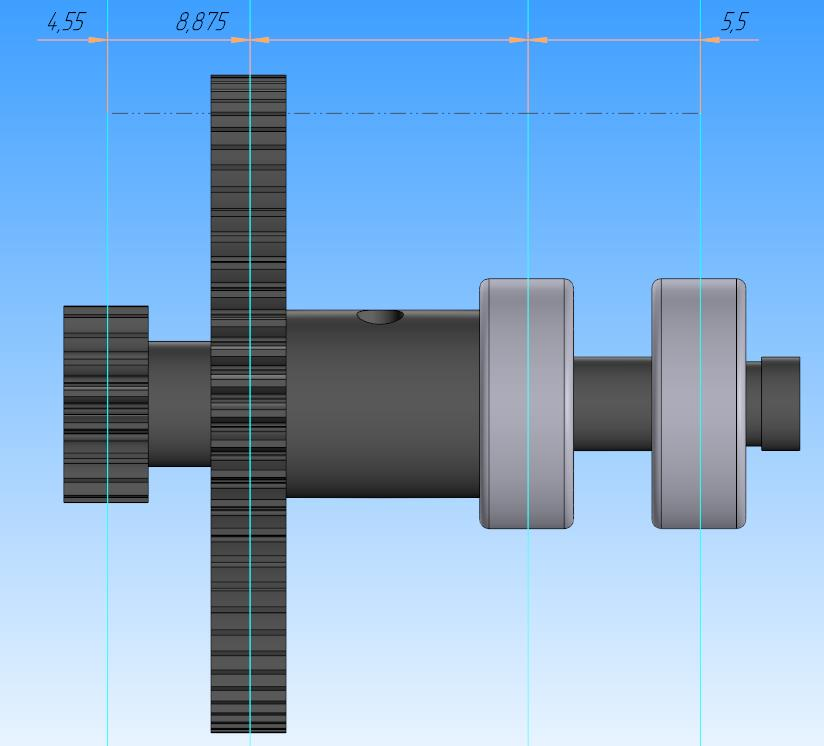
[picture p15: figure]

Рисунок 8 — Схема третьего вала

На прочность:

[ ]

3
3
3
2 | 2
3 | 3

0,1

0,75

пр

пр | изг | кр
| М
d
М | М | М
| σ

≥
·
= | + | ·

5 | 3

5

5
5
5 | 5
5 | 5
6 | 6
5 | 5
4 | 3

4

2 | 2 7,37
2,5860
5,7

2,5860 (20 )
0,9412
cos | cos(0 )

2
cos(45 ) 0,9412 | 0,6655
2
2
cos(45 ) 0,9412 | 0,6655
2
tan 0

0

2 2 7,37
2

кр
окр

окр
r

В
r | r

Г
r | r
a | окр
a | окр

окр

M
F | Н
d
F | tg | tg
F | Н
F | F | Н
F | F | Н
F | F | | Н
F | F | tg | Н

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
= | = | =
- | · | °
= | = | =
°
= | · | ° = | · | =
= | · | ° = | · | =
= | · | =
= | · | =

·
= =

4
4
4 | 4
4 | 4

0,7225
0,4

tan 0,7225 tan(20 )
0,263
cos | cos(0 )

2
cos(45 ) | 0,263 | 0,186
2
| 2
cos(45 ) 0,263 | 0,186
| 2

окр
r

В
r | r

Г
r | r

Н

F
F | Н
F | F | Н
F | F | Н

α
β

=

- | · | °
= | = | | =
| | °
= − | ° = − | · | = −
= | ° = | =
4 | 4
tan | 0 Fa | = | · | = Fокр | β | Н

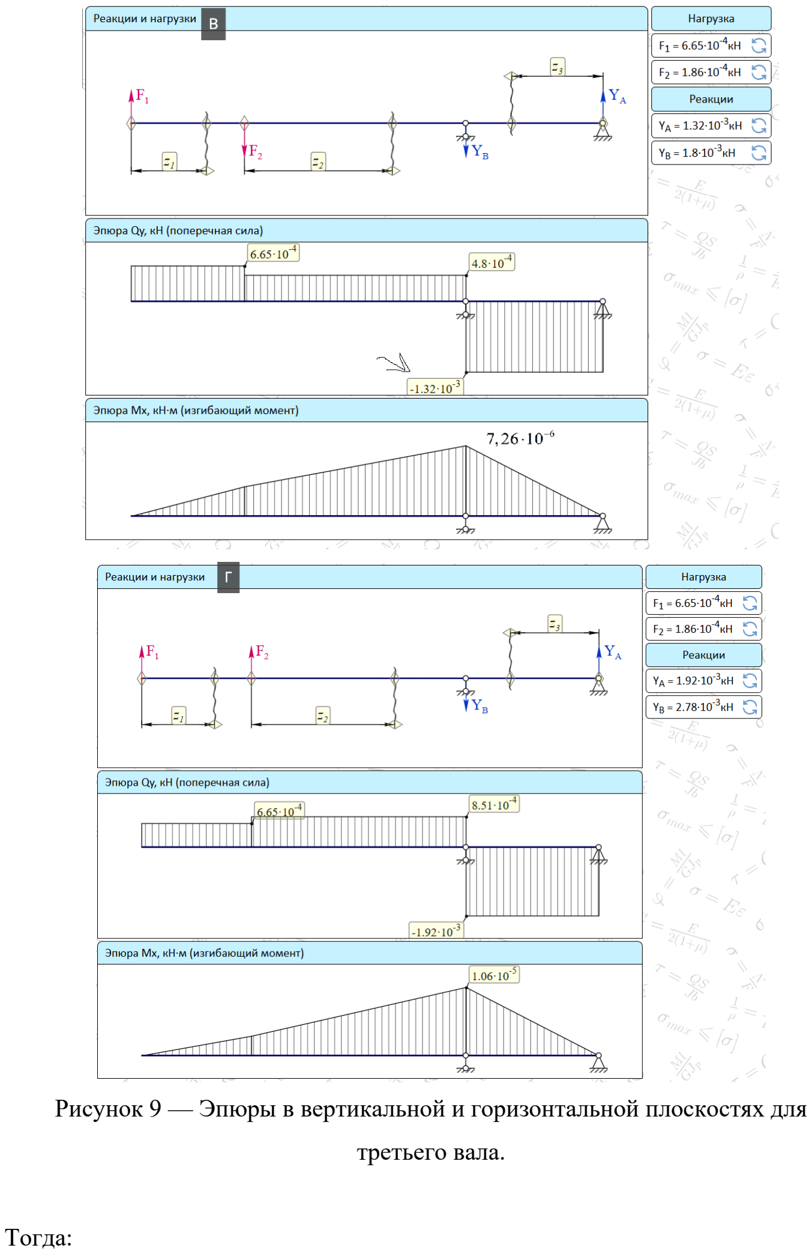
[picture p16: page 39]

Рисунок 9 — Эпюры в вертикальной и горизонтальной плоскостях для

третьего вала.

Тогда:

( | ) ( | ) | ( | ) ( | )
2 | 2 | 2 | 2 2 | 2
3 | 3
0,75 | 10,6 | 7,26 | 0,75 (7,37)

14,34591

Г | В М | М | М | М
пр | изг | изг | кр
Н мм
= | + | + | · | = | + | + | · | =
= | ·

[ ]

3
3 | 3
3

14,34591
| | | | 0,659558
0,1 | 0,1 500
Мпр d | мм
σ
≥ | = | =
| · ·

Таким образом, возьмем диаметр третьего вала 3 d = 3мм.

- Прогиб на месте расположения шестерни:
( | )
4 | 4
4

5

3
3,97 мм
64 64
2,1 10 Па (для углеродистых сталей)
1 | 1 | 1
3,02575 4,55 | 3,55 | 8,875 7,26 3,02575 0,7799 1,342
2 | 2
1 | 1
8,875 3,02575 0,6695 1,342 | 5,5 7,26 | 1,342 | 35,95
3

6
2

2

7

3

2

x | y

B

x

x

d
J J

E

| E J

E J

π π

δ

·
= | = | = | =
= | ·
æ
= | · | · | · · | + · | · | − | · | · | + ç
- è
ö
+ | · | · | · | + · | · | · · | = | + ÷
ø | ·
( | )
( | )
( | )
( | )

5
5

41,9891

1
35,9567 41,9891 =9,34938 10 мм
2,1 10 3,97
1 | 1 | 1
3,02575 4,55 | 3,55 | 8,875 10,6 3,02575 0,7799 1,342
2 | 2
1 | 1
8,875 3,02575 0,6695 1,342 | 5,5 10,6 | 1,342 | 51,469 50,2066
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
= | + | ·
- ·
æ
= | · | · | · · | + · | · | − | · | · | + ç
- è
ö
+ | · | · | · | + · | · | · · | = | · | + ÷
ø | ·
= | ( | )
4
5
2 | 2 | 5 2 | 4 2
51,469 50,2066 | 1,21957 10 мм
2,1 10 3,97
( | ) | ( ) | (9,34938 10 ) | (1,21957 10 ) | 0,00015367

(0,002 0,003)

0,002 (3,55 8,875) 0,02485
0,00015367 | 0,02485

общ
расч
доп | расч

доп

расч | до

B

п

f

f | l
f | мм
f | f
δ | δ | δ

−

Γ | − | −
+ | = | ·
- ·
= | + | = | · | · | = | = +
< | …
= | · | + | =
= | < | =

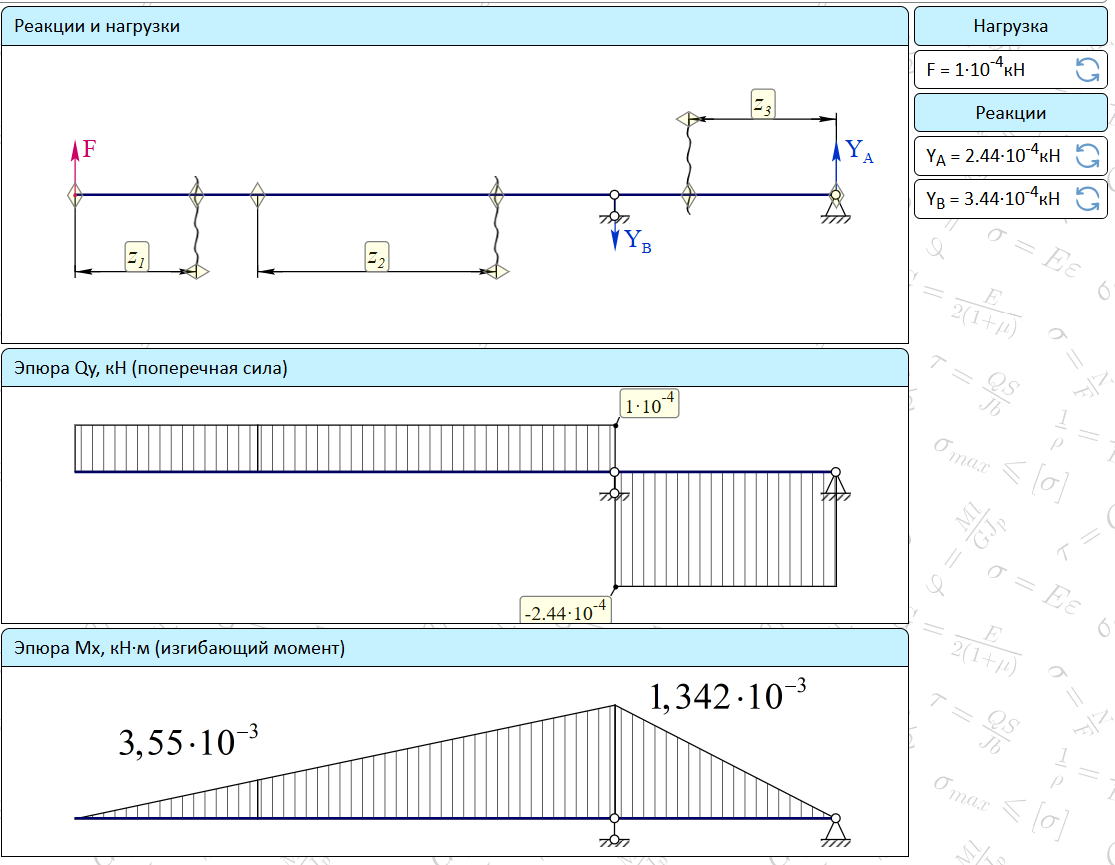
[picture p17: figure]

Рисунок 10 — Вспомогательные эпюры (с единичной силой) для расчёта

перемещений

Так как диаметр третьего вала, полученный по формуле для расчета на изгибную

прочность, меньше 3 мм, то для валов №1 и №2 достаточным является диаметр

равный 4 мм.

### 13.1. Подбор опор

- Проведем | расчет | опор | для | выходного | вала:

На прочность:

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
2 | 2
6 | 6
0,75 Мпр = Мизг + | Мкр
·

11

11

11
11
11 | 11
11 | 11
11 | 11

10

10

10

2 | 2 382,5
17
45

17 (20 )
6,1875
cos | cos(0 )

cos(0 ) 6,1875 1 6,1875

cos(90 ) 6,1875 0 0

0

2 | 2 382,5
27,3214
28

вых
окр

окр
r

В
r | r

Г
r | r
a | окр

вых
окр

r

M
F | Н
d
F | tg | tg
F | Н
F | F | Н
F | F | Н
F | F | tg | Н
| M
F | Н
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
= | = | =
| · | · | °
= | | = | =
°
= | · | ° = | · =
= | · | ° = | · =
= | · | =
| | ·
= | = | =

=

10

10 | 10
10 | 10
10 | 10
tan | 27,3214 tan(20 )
9,9442
cos | cos(0 )

3
cos(30 ) 9,9442 | 8,6119
2
1
cos(60 ) 9,9442 4,9721
2
tan 0

окр

В
r | r

Г
r | r
a | окр

Н

F | F | Н
F | F | Н
F | F | Н

α
β

β

- | · | °
= | =
°
= | ° = | · | =
= | ° = | · =
= | · | =

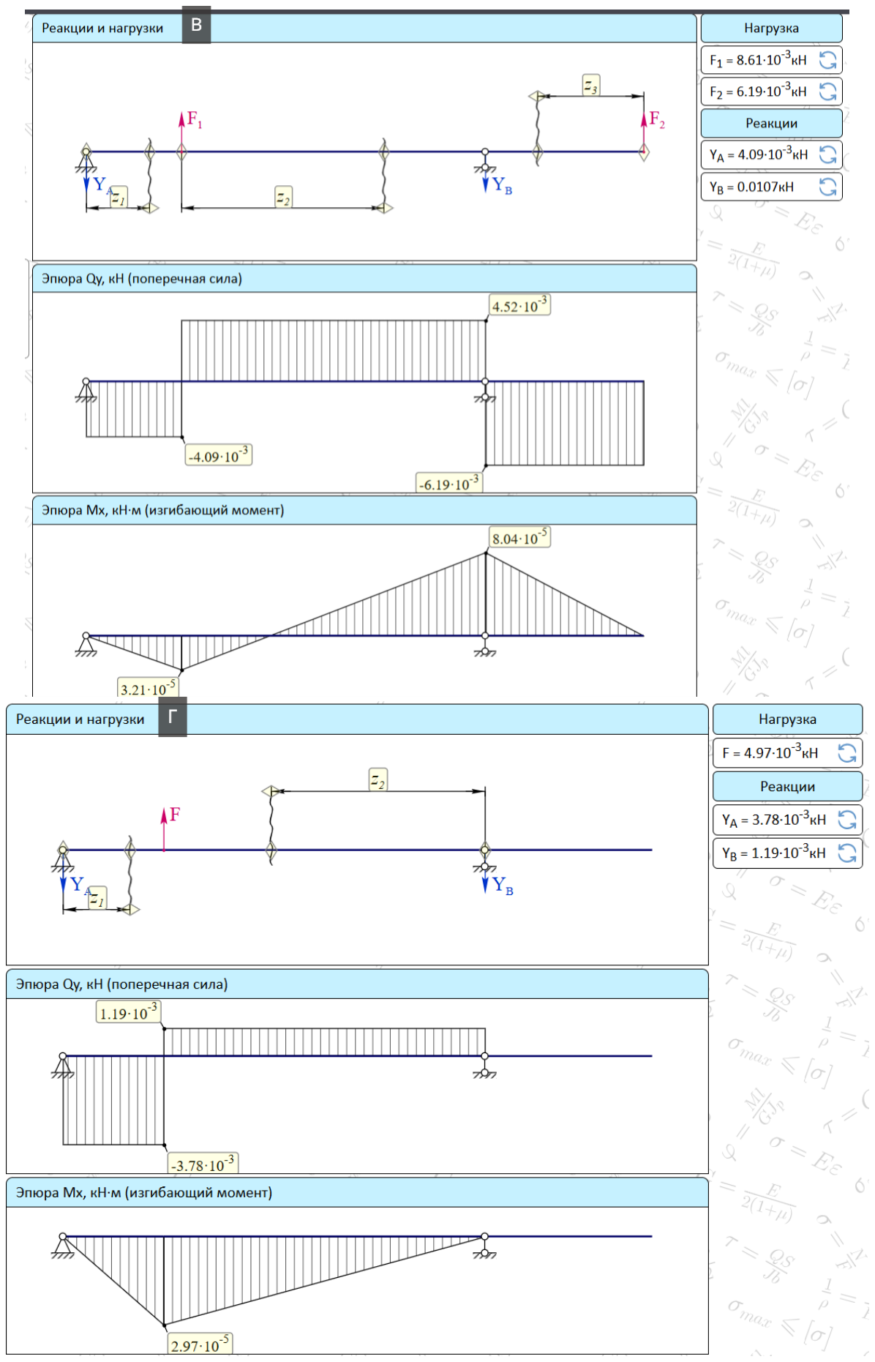
[picture p18: figure]

Рисунок 11 — Эпюры в вертикальной и горизонтальных плоскостях для

выходного вала

Таким образом, реакции в опорах:

( ) ( ) | ( | ) ( | )
( ) ( ) | ( | ) ( | )
2 | 2 | 2 | 2

1

2 | 2 | 2 | 2

2

4,09 | 3,78 | 5,56925
10,7 | 1,19 | 10,76597
| B | Г
A | A | A | r
| B | Г
В | В | В | r
R | R | R | Н F
R | R | R | Н F
= | + | = | + | = | =
= | + | = | + | = | =

10

1

0
0 0,35
5,56925

a

r

F
F
= | = < | Þ подберём радиальный подшипник.

Для удобства посадки подшипника на вал сделаем цапфу диаметром,

равным 6 мм с одной стороны вала.

Выберем радиальные однорядные шарикоподшипники для приборов по

ГОСТ 10058–90 (ИСО 1224-84, ИСО 8443-86, СТ СЭВ 6427-88). УО 1000006

исполнения 1 для опоры А и радиальный однорядный шарикоподшипник УО

1000006 для опоры Б (где опора Б – ближайшая опора к реечному зубчатому

колесу).

Таблица 8 – Параметры радиальных однорядных шарикоподшипников серии

диаметров 0 по ГОСТ 10058–90

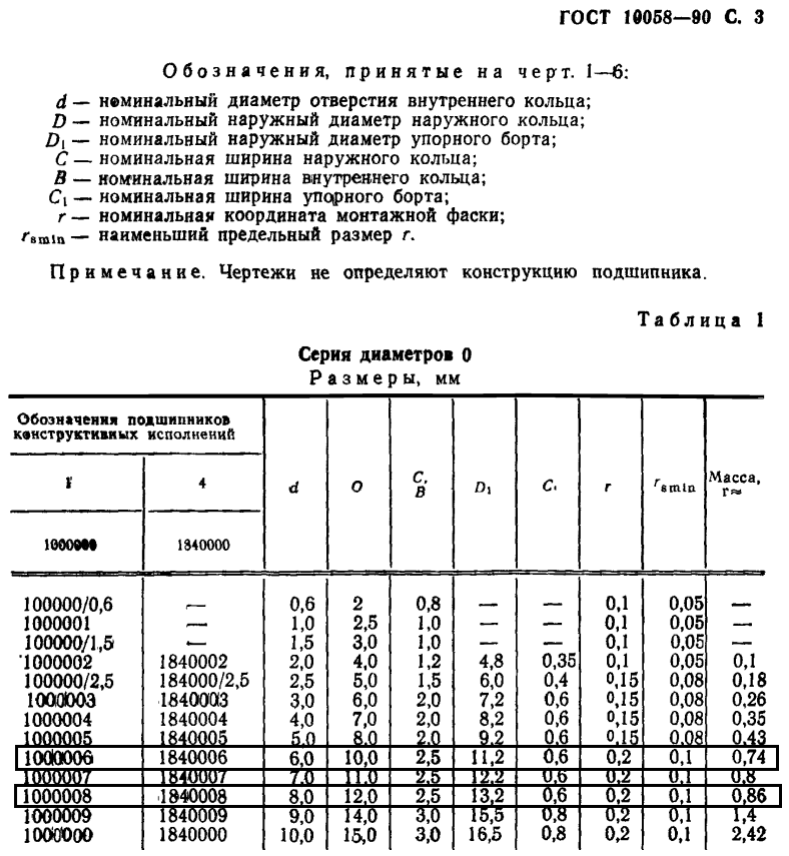
[picture p19: figure]

Таблица 9 – Параметры радиальных однорядных шарикоподшипников серии

диаметров 0 по ГОСТ 10058–90

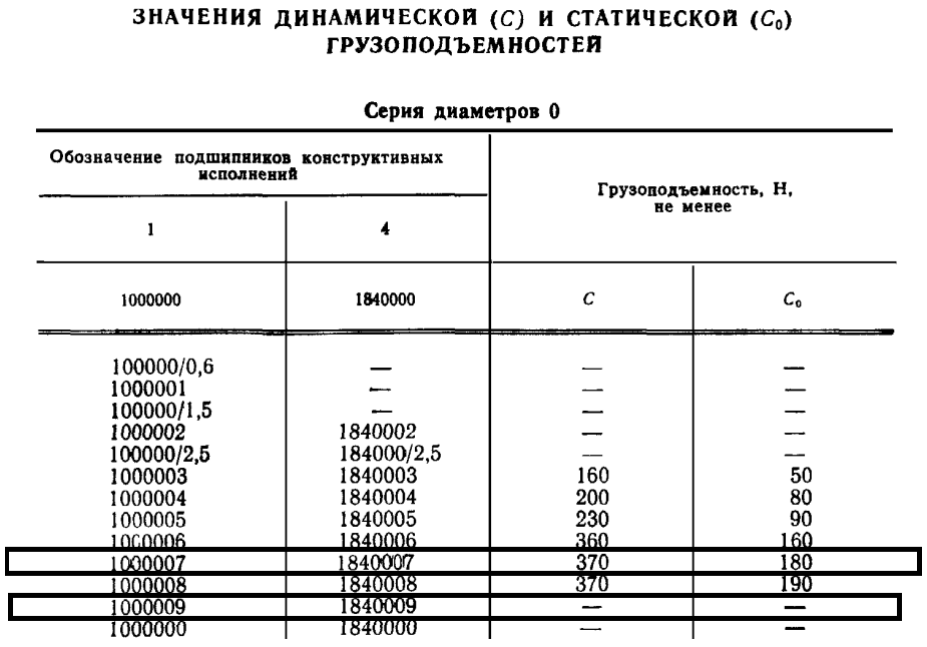
[picture p20: figure]

P XVFr | T
k k = | σ

10

0

10

1

0
0 0,19
180
0
0 0,19
5,56925

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
= | = Þ =
= | = < = | Þ

Таблица 10 – Значение Х и У для радиальных и радиально-упорных однорядных

шарикоподшипников (ГОСТ 18855-82)

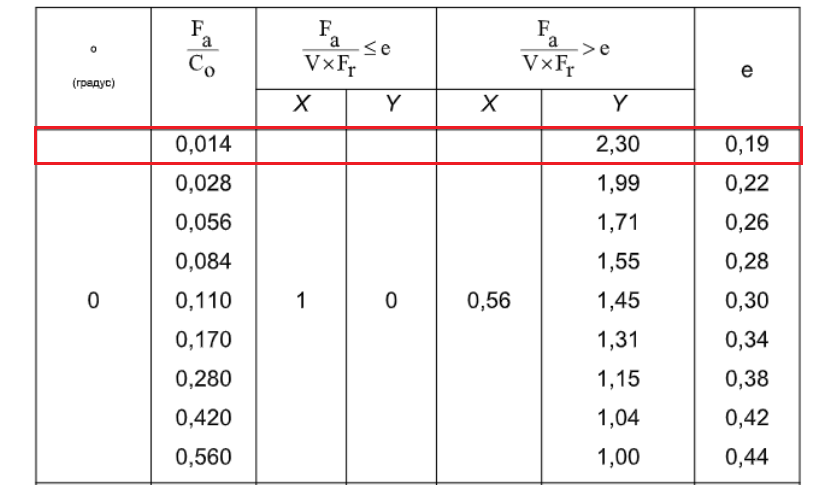
[picture p21: figure]

( | ) | ,так как вращается внутреннее кольцо | 1 P = XFrV +YFa KσKT | Þ V =

10

1

0
0 | 0,19 | 1, | 0(по таблице
5,569

9
25

)

a

r

F
e | X | Y
VF
= | = < = | Þ | = | =

Тогда формула для динамической нагрузки примет вид:

2

10,76597 1,1 1,1 13,0268, где — коэффициент безопасности
— температурный коэффициент
r | T

T

P F K K
K
K

σ

σ

= | = | · | · | =
0 | 3
,01 | 60 Ср | Р | h = | nL , где долговечность | 1000 2 2000 Lh = | · = | ч

3
0 | 3
,01 | 60 | 0,01 13,0268 | 60 9000 2000 133,6531 Ср | Р | h = | nL = | · | · | · | · | = | Н
370 Ср

< CА = Н
Опора Б в силу габаритов имеет грузоподъемность не меньшую, чем опора

А, следовательно, выбранные подшипники подходят.

- Произведем подбор опор качения для пятого вала:

Таким образом, реакции в опорах:
( ) ( ) | ( | ) ( | )
( ) ( ) | ( | ) ( | )
2 | 2 | 2 | 2

2

2 | 2 | 2 | 2

1

6,08 | 2,73 | 6,66478
1,17 | 4,14 | 4,30215
| B | Г
A | A | A | r
| B | Г
В | В | В | r
R | R | R | Н F
R | R | R | Н F
= | + | = | + | = | =
= | + | = | + | = | =

1

0
0 0,35
4,30215

a

r

F
F
= | = < | Þ подберём радиальный подшипник.

Для удобства посадки подшипника на вал сделаем цапфу диаметром,

равным 3 мм.

Выберем радиальный однорядный шарикоподшипник типа 0000 из

сверхлегкой серии диаметров 9, нормальная серия ширин. УО 1000093.

Таблица 11 – Параметры радиальных однорядных шарикоподшипников типа

0000 (ГОСТ 8338-75)

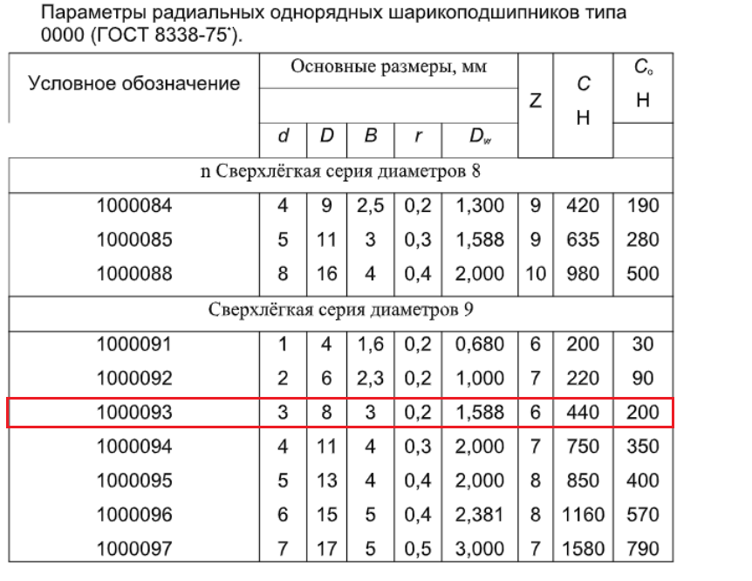
[picture p22: figure]

P XVFr | T
k k = | σ

9

0

9

1

0
0 0,19
200
0
0 0,19
4,30215

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
= | = Þ =
= | = < = | Þ
( | ) | ,так как вращается внутреннее кольцо | 1 P = | Þ XFrV +YFa KσKT | V =

9

1

0
0 | 0,19 | 1, | 0(по таблице
4,302

9
15

)

a

r

F
e | X | Y
VF
= | = < = | Þ | = | =

Тогда формула для динамической нагрузки примет вид:

2

6,66478 1,1 1,1 8,0644, где — коэффициент безопасности
— температурный коэффициент
r | T

T

P F K K
K
K

σ

σ

= | = | · | · | =
0 | 3
,01 | 60 С | Р | nL р | h = | , где долговечность | 1000 2 2000 Lh = | · = | ч

3
0 | 3
,01 | 60 | 0,01 8,0644 60 9000 2000 82,73958 С | Р | nL | Н р | h = | = | · | · | · | =
440 С | C | Н р < | = | Þ выбранный подшипник подходит.

Так как диаметры последующих валов тоже равны 4 мм и нагрузки на них

меньше, то данная опора качения подходит и для них.

Таблица 12 – Итоговые параметры валов и опор

№ вала | d , мм вала | УО опоры (ГОСТ 8338-75) | d мм , A | , DА мм | , BA мм | d мм , Б | , DБ мм | , BБ мм
I | 4 | А, Б – 1000093 | 3 | 8 | 3 | 3 | 8 | 3
II | 4 | А, Б – 1000093 | 3 | 8 | 3 | 3 | 8 | 3
III | 3 | А, Б – 1000093 | 3 | 8 | 3 | 3 | 8 | 3
IV | 4 | А, Б – 1000093 | 3 | 8 | 3 | 3 | 8 | 3
V | 4 | А, Б – 1000093 | 3 | 8 | 3 | 3 | 8 | 3
VI | 9 | А – 1000007 Б – 1000009 | 7 | 11 | 2,5 | 9 | 14 | 3

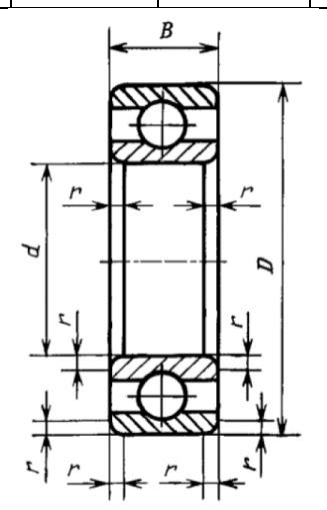
[picture p23: figure]

Рисунок 12 — Геометрические параметры подшипника шарикового

радиального однорядного

14.Расчёт на точность

Расчет будем производить методом минимума-максимума, так как, согласно

условию, производство единичное.

Выберем:

- 6 степень точности,
- вид сопряжения Н.

Геометрические параметры колёс, а именно делительный диаметр и

модуль рассчитаны на странице 19 в таблице 6. Стоит отметить, что

11 | 11 | 11 12
d | 45мм, z | 45, m | 1 = | = | − | =

Допуск на кинематическую погрешность колёс находят как сумму

допусков на накопленную погрешность шага F
p

и допуск на погрешность

профиля зуба f
f .

Минимальное значение кинематической погрешности:
( )

0 min

_ | 1 | 2
0.71 i | s | i | i
ij | p | f
F | K F | F
F | F | f
′ | = | ′ + ′
′ = | +

,

где Ks

– коэффициент фазовой компенсации (П2.3.)

По таблице П2.1 и П2.2. стр. 118 выберем необходимые F
p

,
f

f ,Ks

:

Таблица П2.1., П2.2

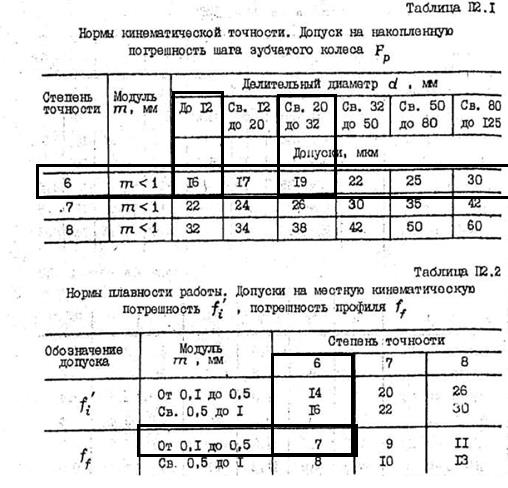
[picture p24: figure]

Таблица П.2.3

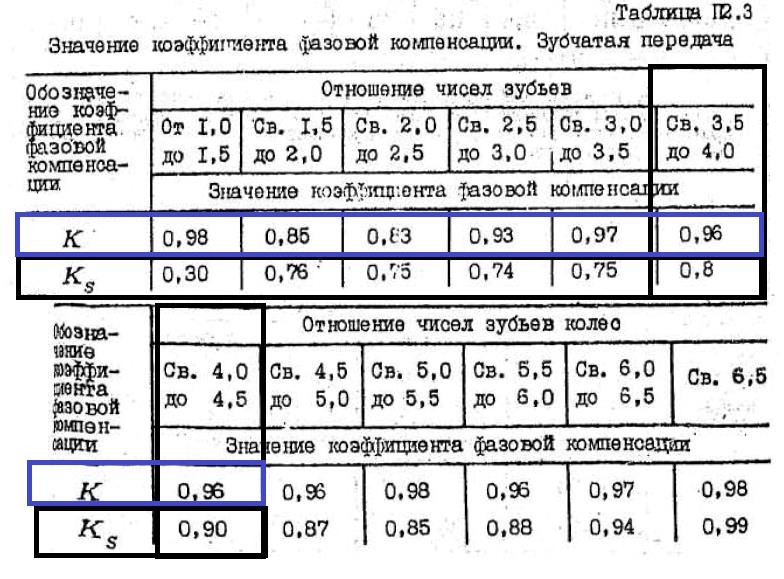
[picture p25: figure]

Получим:

1 | 3 | 5 | 7 | 9
2 | 4 | 6 | 8 | 10
1 | 2 | 3 | 4 | 5 | 6 | 7 | 8 | 9 | 10

16

19

7

p | p | p | p | p
p | p | p | p | p
f | f | f | f | f | f | f | f | f | f
F | F | F | F | F | | мкм
F | F | F | F | F | | мкм
f | f | f | f | f | f | f | f | f | f | мкм
= | = | = | = | =
= | = | = | = | =
= | = | = | = | = | = | = | = | = | =

Посчитаем допуск на кинематическую погрешность колёс:

11 | 31 | 51 | 71 | 91
22 | 42 | 62 | 82 | 10 2

16 7 23
19 7 26
F | F | F | F | F | мкм
F | F | F | F | F − | мкм
′ = ′ = ′ = ′ = ′ = | + =
′ = ′ = ′ = ′ = ′ = | + =
1. Минимальное значение кинематической погрешности:
( | )
( | )
0 min | 0 min | 0 min | 0 min

0 min

1 | 2 | 3 | 4

5

0.71 0.8 23 26 | 27.832
0.71 0.9 23 26 | 31.311
F | F | F | F | мкм
F | мкм
− | − | − | −

−

′ | = ′ | = ′ | = ′ | = | · | · | + | =
′ | = | · | · | + | =
2. Максимальное значение кинематической погрешности
max | 1 | 2
2 | 2 | 2 | 2
1 | 2
( ) | ( | ) Fi | K | Fi | E M | Fi | E M

′
| | | | | Σ | | Σ
é | ù = | ′ + | + | ′ | +
ë | û

2
tan
tan ,
cos
20 , | 0 | tan

r
M | a
M | r

e
E | e
E | e

α
β
β
α | β | α

∑

∑

æ | ö
= | + ç | ÷
è | ø
= | = | Þ | =

,

где r

e – допуск на радиальное биение зубчатого венца (П2.14)

K – коэффициент фазовой компенсации

Таблица П2.14

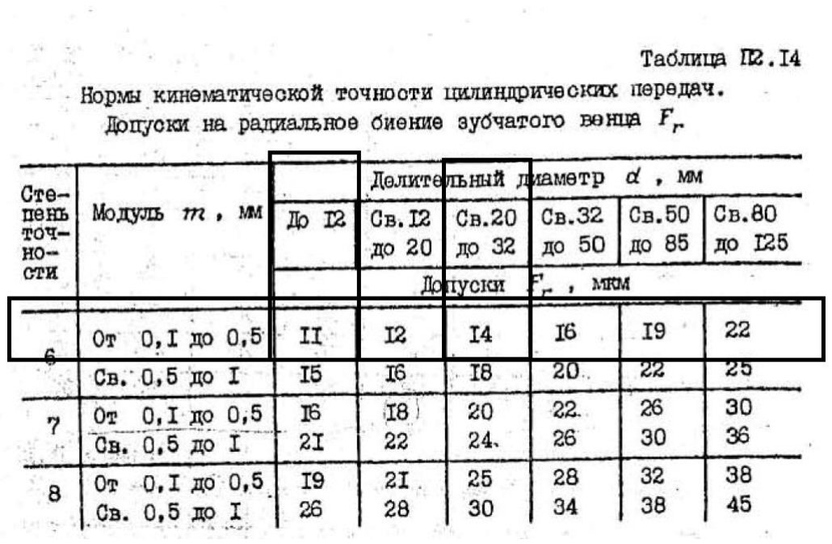
[picture p26: figure]

Суммарная погрешность монтажа третьей, пятой, седьмой, девятой

шестерней равна нулю, так как имеем вал-шестерни:

Тогда максимальное значение кинематической погрешности:

( ) | ( )

( )

( ) | ( ) | ( )
( ) | ( ) | ( )
0max | 1 | 2

0max

0m

4

ax | 6
2 | 2 2 | 2
2 | 2
2 | 2
1 | 11 | 22
2 | 2

2
2 | 31 | 42

2 2

3

2

2 | 2 | 2 2
2

2
51 | 6
23 | 4.0037 | 26 | 5.00956
23 | 26 | 5.00956
23 | 26 | 5.00956
0.96 | 47.8311
0.96 | 47.4991

0.96

M | M

M

M

F | K | E | E

F

F | F
| K | F | F
F | K | F | F | E E

′
Σ | Σ

′
Σ

′
Σ
é | ù
= | + | + | + | =
ê | ú ë | û
é | ù
+ | + | + | =
ê | ú ë | û
é | ù | é | ù
= | + | + | = | + | + | =
ê | ú | ê | ú ë | û | ë | û
é | ù
= | + | + | = | + | +
ê | ú ë

′

′ | ′
û

′

′ | ′
( ) | ( ) | | ( )
( ) | ( | ) | ( )

8

1

0max

0max | 0
2 | 2 | 2 2 | 2

2

2

2
4 | 71 | 8

2

2

2 2 | 2 | 2
5 | 91 | 10 2

47.4991

0.96 | 23 | 26 | 5.00956 | 47
| 23 | 26 | 5

.4991

0.96 | | | .00956 | 47.4991

M

M

F | K | E

K

| F | F
F | F | F | E

′
| | | Σ

′
− | Σ
é | ù
=
ê | ú ë | û
é | ù | é | ù
= | + | + | = | + | + | =
ê | ú | ê | ú ë | û | ë | û
é | ù | é | ù
= | + | + | = | +
′ | ′
′ | + | =
ê | ú | ê | ú ë | û | ë | û

′

Так как в условии погрешность выходного вала задана в угловых минутах,

1

3 | 5 | 7 | 9
2 | 4 | 6 | 8 | 10
| 11 tan 20 | 4.0037
0

14 tan 20 5.00956

M

M | M | M | M
M | M | M | M | M

E
E | E | E | E
E | E | E | E | E

∑

∑ | ∑ | ∑ | ∑
∑ | ∑ | ∑ | ∑ | ∑
= | · | =
= | = | = | =
= | = | = | = | = | · | =

то переведём линейную погрешность в угловую:

0max i

0max 1
1
2

0max 2
2
4

0max 3
3
6

0max 4
4
8

47.8311
23.45
47.4991
20.4

6.88

6.88 | 6.88
14.0332
6.88 | 6.88
16.0193
6.88 | 6.88
15.7871
6.88 | 6.88
15.56

47.4991

1

20.7
47.
6

4991
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
Δ | =
| | · · ′
Δ | = | = | = | ′
| | · · ′
Δ | = | = | = | ′
| | · · ′
Δ | = | = | = | ′
| | · · ′
Δ | = | = | = | ′

Δ

0max 5
5
10
6.88 | 6.8 47.4991
| 28

8
11.6712

F
d
- · ′
= | = | = | ′

Суммарная кинематическая погрешность:

34 | 56 | 78 | 910
56 | 78 | 91

max i
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
1 | 1
0.004966
| 201.36
| 1
0.0177791
| 56.2459
1 | 1
| 0.0645382
15.

1

1 | 1

1

1 | 1
0.237501
| 4.2
| 4947
1
| 105
1
1

N

i
j

II VI

III VI

IV VI

V VI

VI VI

i | i | i | i

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
φ ξ φ

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
= | =
- | · | ·
= | =
Δ | = | Δ
= | =
= | =
= | =
= | = | =

=

- ·
= | =

=

=

∑

,

Тогда суммарная кинематическая погрешность:

5

max i
1
14.0332 | 16.0193
15.7871 | 0.237501 15.5616 1 1
0.004966 | 0.

1.6712
0.069689 0.28481 1.018871 3.6959 11.6712 1

0177791

0.064
6.7 046

538
4

2

i
i

φ ξ φ ∑

=

Δ | = | Δ | = | + | + ′ | ′
+ | + + | · | + · | = ′ | ′ | ′
= | + | + | + | + ′ | ′ | ′ | ′ | ′ | ′
- ·

·
=

∑

φ | 16.74046 ∑ Δ | = | ′

Определение погрешностей, вносимых мёртвым ходом.

Максимальное значение мёртвого хода равен:

( | ) | ( | ) max | 1 | 2 | 1 | 2 | 1 | 2
2 | 2 | 2 | 2 | 2
0.7 | 0.5 | 2
s | s
t | H | H | H | H | a | r | r
i | = | E | + E | + | T + T | + f + G + G
где | 1 | 2
, EHS | EHS

– наименьшее смещение исходного контура шестерни и колеса

(П2.12),

1 | 2
, TН | TН

– допуск на смещение исходного контура шестерни и колеса,

выбирается на основе Fr

– допуска на радиальное биение зубчатого венца (П2.14,

П2.13),

a

f | – допуск на отклонение межосевого расстояния передачи (П2.10)
Выберем | 1 | 2
, EHS | EHS

таблице П2.12

Таблица П2.12

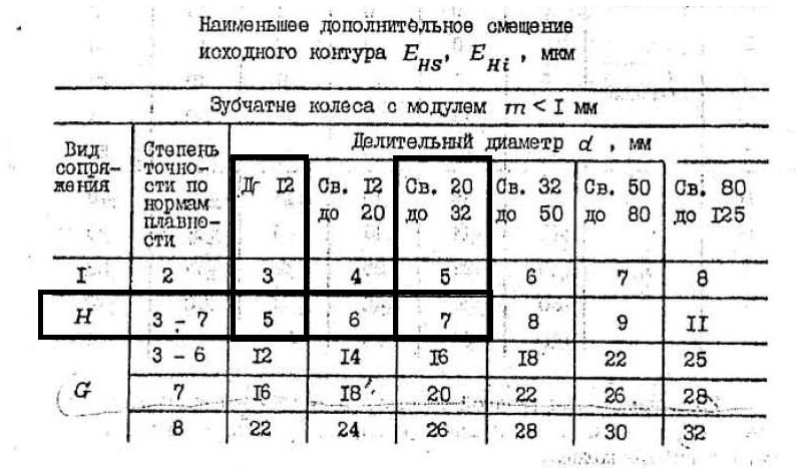
[picture p27: figure]

1 | 2
5 | , | 7 EHS | м | HS = | км E | = мкм
Для определения | 1 | 2
, TН | TН

выберем Fr
по П2.14:

Таблица П2.14

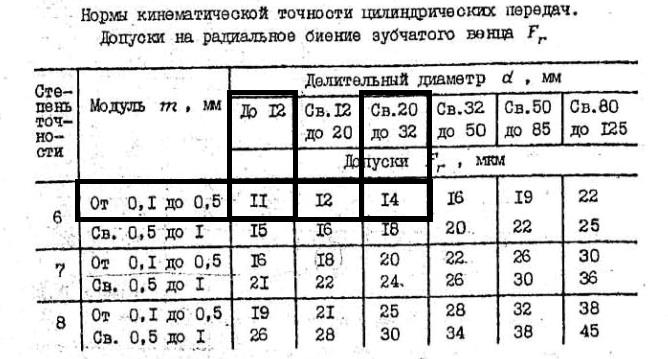
[picture p28: figure]

Тогда | 1 | 1
11 | , | 14 Fr | м | r = | км F = | мкм
Выберем | 1 | 2
, TН | TН | по П2.13:

Таблица П2.13

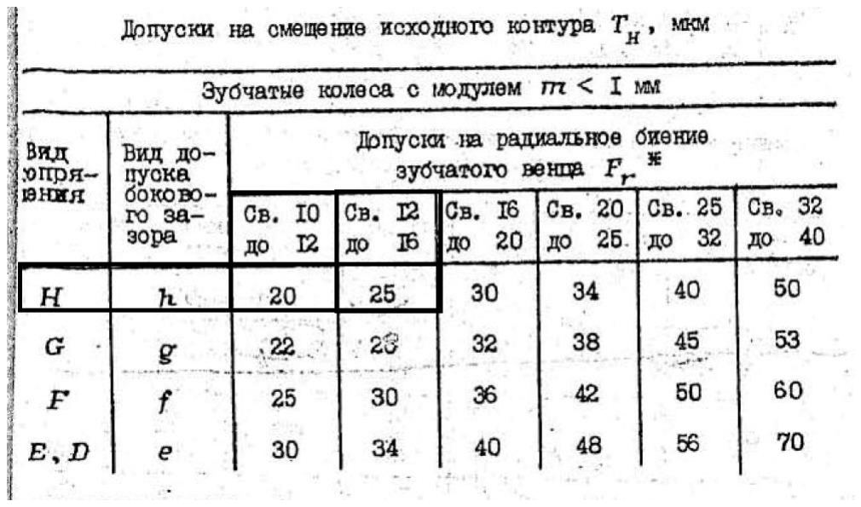
[picture p29: figure]

1 | 2
20 | , | 25 TН | м | Н = | км T = | мкм

Выберем a

f по таблице П2.10

Для этого определим межосевые расстояния:

12

34

56

78

9 10

0.5 ( )

0.5 0,35 (19 67) 15.05
0.5 0,3 (19 68) 13.05
0.5 0,3 (19 69) 13.2
0.5 0,3 (19 70) 13.35
0.5 0,35 (19 80) 17.325
ij | i | j
a | m z | z

a
a
a
a
a −
= | | +
= | · | · | + | =
= | · | · | + | =
= | · | · | + | =
= | · | · | + | =
= | · | · | + | =

Таблица П2.10

Тогда | 9 a

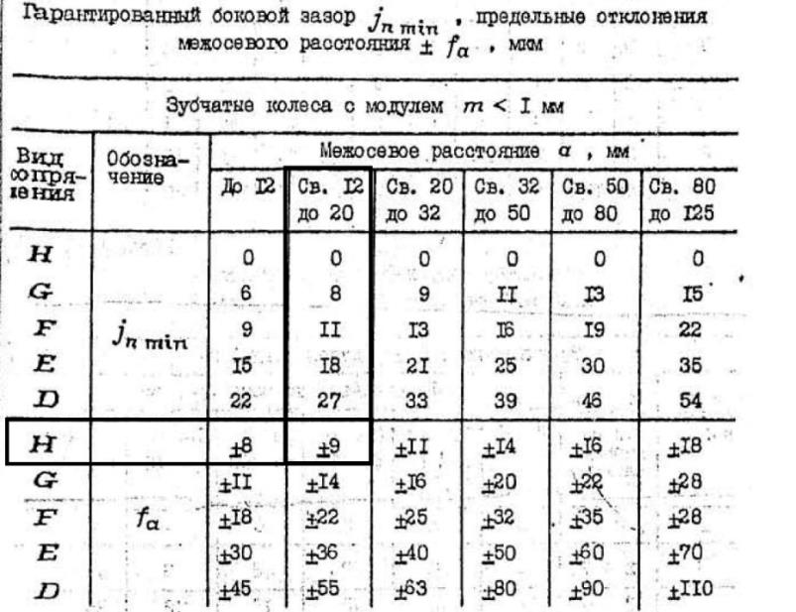
[picture p30: figure]

f = ± мкм

Тогда составляющие:

- | 1 | 2
5 | , | 7 EHS | м | HS = | км E | = мкм
- | 1 | 2
20 | , | 25 TН | м | Н = | км T = | мкм
- 9 a
f = ± мкм
- Пусть
| | | 1 | | 2
15 Gr = Gr = | мкм

Рассчитаем максимальное значение мёртвого хода:
( | ) | ( | )
( | ) | ( | )
max | 1 | 2 | 1 | 2 | 1 | 2
2 | 2 | 2 | 2 | 2
2 | 2 | 2 | 2 | 2
20 | 15 | 1
0.7 | 0.5 | 2
0.7 5 7 | 0.5 | 25 | 2 9 | 5 | 41.9336
s | s
t | EH | EH | TH | TH | a | r | r
j | = | + | + | + | + f + G + G =
= | + | + | + | + · | + | + | =

Рассчитаем собственные люфтовые погрешности передач, отнесённые к

ведомым колёсам каждой пары:

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
41.9336

41.9336

41.

6.88
12.30291
23.45
6.88
14.14231
20.4
6.88
13.93735
20.7
6.88
13.73825
21
6.88
10.30368
2

9336

41.9336

41.9336
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
= | =

·
= | =

·
= | =

·
= | =

·
= | =

Тогда суммарная люфтовая погрешность:

max

5

1

0.004966 | 0.0177791

0.

12.30291 | 14.14231

0645382 13.93735 0.237501 13.73825 1 10.30368 14.77856

i
i
j | j φ | φ

ξ ∑

=

= | = | · | + | +
+ | + | · | = + · | ′

·

·

∑

Упругий мёртвый ход:

4

0.88

i

кр раб
y

М l
d

φ

- ·
Δ =

где

i М кр | – крутящий момент i-го вала
раб l | – рабочая длина вала

d – диаметр вала

Величины крутящих моментов указаны в разделе 11 «Геометрический

расчёт», диаметры валов и их рабочие длины указаны в разделе 13 «Расчёт

валов».

Вал двигателя учитывать не будем, так как на нем упругий мертвый ход

мал, тогда:

2 | 4
3 | 4
4 | 4
5 | 4
6 | 4

0.88 2.11 12,7
0,0921
4
0.88 7.37 3,55
0.284245
3
0.88 26.09 7,7
0,6906
4
0.88 93.62 11,675
3,7572
4
0.88 382,5 37,9
9,8435
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
- | · Δ | = | = | ′
- | · Δ | = | = | ′
- | · Δ | = | = | ′
- | · Δ | = | = | ′
- | · Δ | = | = | ′

Суммарное значение упругого мертвого хода:

5

1
0,0921 | 0.284245 | 0,6906 | 3,7572 | 9,8435
10,78592
201.36 | 56.2459 | 15.4947 | 4.2105 | 1
Δ | = | Δ | = φ | ξ φ y ∑ | i | i
′ | ′ | ′ | ′ | ′
= | + | + | + | + | = | ′

∑

16,74046 14,77856 10,78592 | 42,30494 ∑ Δ = | + | + | = ′ | ′ | ′ | ′
Видно, что | 42.45352 | 25 ∑ | зад Δ = | > Δ | = ′ | ′

Выводы:

Погрешность | мёртвого | хода | можно | сократить | с | помощью

люфтовыбирающих колёс, одно из которых будет находиться в реечной

передаче, а второе в пятой зубчатой передаче. Тогда получим следующее

значение люфтовой составляющей мёртвого хода:

max

5

1

0

0.004966 | 0.0177791

0.06

12.30291 | 14.14231

45382 13.93735 0.237501 13.73825 1 10.30368 4.4749

i
i
j | j φ | φ

ξ ∑

=

= | = | · | + | +
+ | · | + | · | + · | = | ′
∑ | ·

Так же предлагается увеличить диаметр шестого (выходного) вала с 6 мм

до 9 мм.

Тогда суммарное значение упругого мертвого хода:

2 | 4
3 | 4
4 | 4
5 | 4
6 | 4

0.88 2.11 12,7
0,0921
4
0.88 7.37 3,55
0.284245
3
0.88 26.09 7,7
0,6906
4
0.88 93.62 11,675
3,7572
4
0.88 382,5 37,9
1,9444
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
Δ | = | = | ′
- ·
Δ | = | = | ′
- ·
Δ | = | = | ′
- ·
Δ | = | = | ′
- ·
Δ | = | = | ′

5

1
0,0921 | 0.284245 | 0,6906 | 3,7572 | 1,9444
2,88682
201.36 | 56.2459 | 15.4947 | 4.2105 | 1
φ y | i | i Δ ∑ = | ξ Δφ =
′ | ′ | ′ | ′ | ′
= | + | + | + | + | = | ′

∑

Таким образом суммарная погрешность:

16.74046 | 2,88682 | 4,5074 | 24,13468 ∑ Δ = | ′ + | ′ + | ′ = | ′
Видно, что | 24.7043 | 25 ∑ | зад Δ = | ′ < Δ | = | ′ .

15.Расчёт ЛВК

Люфтовыбирающие колёса будем устанавливать на реечную передачу и пятую

зубчатую передачу.

Расчёт реечного люфтовыбирающего колеса

Параметры реечной передачи: da11 = 46мм

d11 = 45 мм

df11 = 43.75 мм

z11 = 90

b11 = 4 мм

m11−12 = 0.5

b12 = 6 мм

z12 = 80

Крутящий момент на выходном валу:
Mкр = 382.5 Н ⋅ мм

Пусть расстояние от центра ЗК до оси прорези пружины A = 12 мм, длина

нерастянутой пружины L = 20 мм, количество зубьев смещения n = 2

Отыщем угол φ взаимного смещения составных частей зубчатого колеса:

φ =

360n
z

⇒

φ
2

=

180n
z11

=

180 ⋅ 2
90 = 4°

При взаимном повороте частей составного зубчатого колеса начальная длина

пружины L увеличивается до L1 и, следовательно, в пружине возникают

стягивающие усилия.

При этом первоначальное плечо действия пружины A1:

A1 = A cos

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
Пара сил двух пружин, действующих на плече 2A1, создаёт зазоровыбирающий момент M = 2 ⋅ A1 ⋅ P2, где P2 – усилие одной пружины.

Рабочее усилие пружины:

P2 =

M′
2A1

Для надёжности зазоровыбирающий момент M′ должен превышать величину

крутящего момента в 1.5-2 раза.
Пусть M′ = 2 ⋅ Mкр

Рабочее усилие пружины определяем из выражения:

P2 =

2 ⋅ Mкр
2A1

=

2 ⋅ 382.5
2 (12 cos 4° −

20
2

sin 4°)

≈ 33.93 Н

Сила пружины при максимальной деформации:

P3 =

P2
1 − δ
Где δ – относительный зазор (для ограничения максимальных деформаций)

δ = 0.05 … 0.1 – для пружин растяжения

Пусть δ = 0.1

Тогда:

P3 =

33.93
1−0.1

≈ 37.7 ≈ 40 Н

По таблице ГОСТ 13771-68 «Пружины сжатия и растяжения из стали круглого

сечения»:

Выберем виток №243

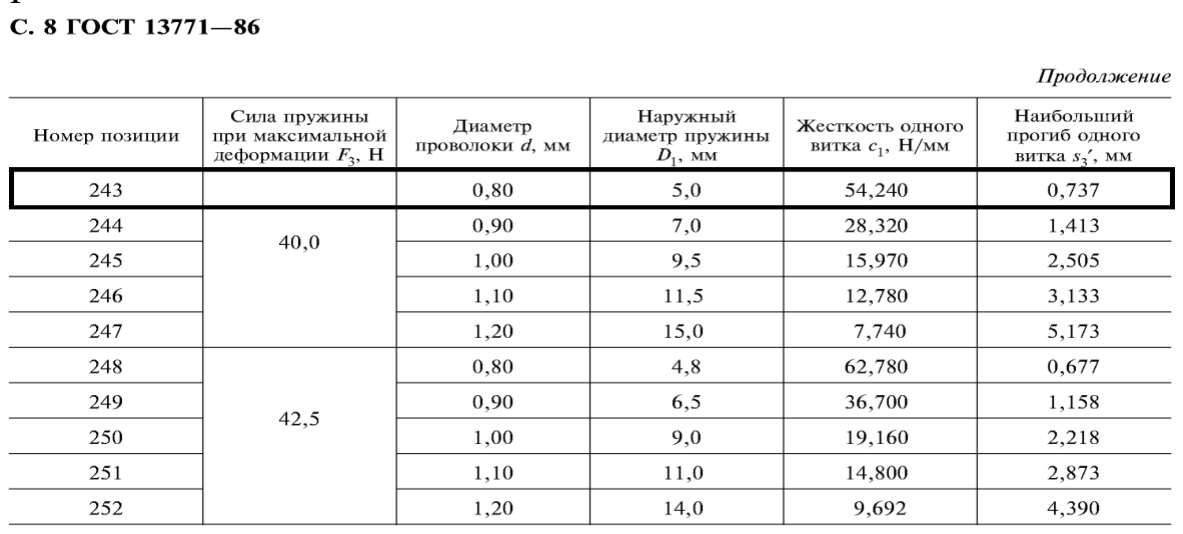
[picture p31: figure]

Таблица 13 – ГОСТ 13771-86 «Пружины сжатия и растяжения из стали круглого сечения»

Параметры пружины:
P3 = 40 Н

d = 0.8 мм

D = 5 мм

c1 = 54,240

Н
мм
s2 = 0,737 м

Определим длину рабочей деформации fраб:

fраб = L1 − L = L cos

φ
2

+ 2A sin

φ
2

− L = 20 cos 4° + 2 ⋅ 12 sin 4° − 20

= 1.6254 мм

Жёсткость пружины:

k =

P2

fраб

=

33.93
1.6254 = 20.8749

Н
мм

Число рабочих витков:

n =

c1
k

=

54.240
20.8749 = 2.5983 ≈ 3

Число витков с зацепами:
n0 = n + n2

Где n2 = 1.5 … 3.5 – для пружин сжатия

n2 = 2.5 – для пружин растяжения

n0 = 3 + 2.5 = 5.5

Высота пружины в свободном состоянии: H0 = (n0 + 1)d = 6.5 ⋅ 0.8 = 5.2 мм

Полная длина с крючками:
L

′ = H0 + 2D = 4.4 + 2 ⋅ 5 = 15.2 мм

Учитывая, что диаметр впадин df = 43.75 мм, пружина вмещается по полной

длине с крючками в зубчатое колесо.

Общая толщина колеса будет составлять 6 мм, а диаметр рейки равен 7 мм. При

проверке на контактную прочность получаем:

( | )
( | )

max 11

3

3

108,5 | 1
108,5 0.9 | 1 1 | 1,3 382,5
100,5748
25 1 | | 6
jk | k
k
H
w jk
z | i | kM
a i | b

МПа

σ −

+
= | =
- | + | · | ·
= | =
·

Так как

[ ] 55

max12

572
93,11413

6,14 2

н Ст

H

σ
σ
= | = | > | и

[ ] 40

max11

54
100,5748

6
5,42 2

н Ст X

H

σ
σ
= | = | >

Проверка пройдена.

Расчет люфтовыбирающего колеса №10

Параметры ЗК Z10 указаны в разделе 10 «Геометрический раздел».

Крутящий момент на выходном валу:

382,5 Mкр = Н · мм

Пусть расстояние от центра ЗК до оси прорези пружины A = 9,5мм, длина

нерастянутой пружины L =12мм, количество зубьев смещения n = 2.

Расчёт будем проводить аналогично реечному ЛВК:

Отыщем угол φ взаимного смещения составных частей зубчатого колеса:

10

360

180 180 2
4,5
2 | 80

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
= | = | =

При взаимном повороте частей составного зубчатого колеса начальная

длина пружины L увеличивается до L1 и, следовательно, в пружине возникают

стягивающие усилия.

При этом первоначальное плечо действия пружины A уменьшается до

величины A1:

1

cos | sin
2 | 2 | 2

L
А | А
φ | φ
= | −

Пара сил двух пружин, действующих на плече 2А1, создаёт

зазоровыбирающий момент | 1 | 2 М = 2· А · Р , где Р2
– усилие одной пружины.

Рабочее усилие пружины:

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
Проектирование люфтовыбирающего колеса будем вести с четырьмя

пружинами, так как в случае двух или трёх пружин, усилия P2
и P3

получается

достаточно велики, что пружины с подходящими под них параметрами не

помещаются в зубчатое колесо.

Для надёжности зазоровыбирающий момент M′ должен превышать

величину крутящего момента в 1,5–2 раза.

Пусть:

2 M Mкр

′ = ·

Рабочее усилие пружины определяем из выражения:

2
1
2 | 2
21,2501
4 | 12
4 9,5cos4,5 | sin 4,5

382,5

2

Mкр
P | Н
A
- ·
= | = | =
æ | ö
ç | − | ÷
è | ø

Сила пружины при максимальной деформации:

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
где δ – относительный зазор (для ограничения максимальных

деформаций)

δ = 0.05...1 – для пружин растяжения

Пусть δ = 0.1

Тогда

3

21,2501
23,6112 25
1 0.1
P = | = | Н ≈ | Н
−
По таблице ГОСТ 13771-68 «Пружины сжатия и растяжения из стали

круглого сечения»:

Выберем пружину №206

Таблица 14 – ГОСТ 13771–86 «Пружины сжатия и растяжения из стали круглого

сечения»

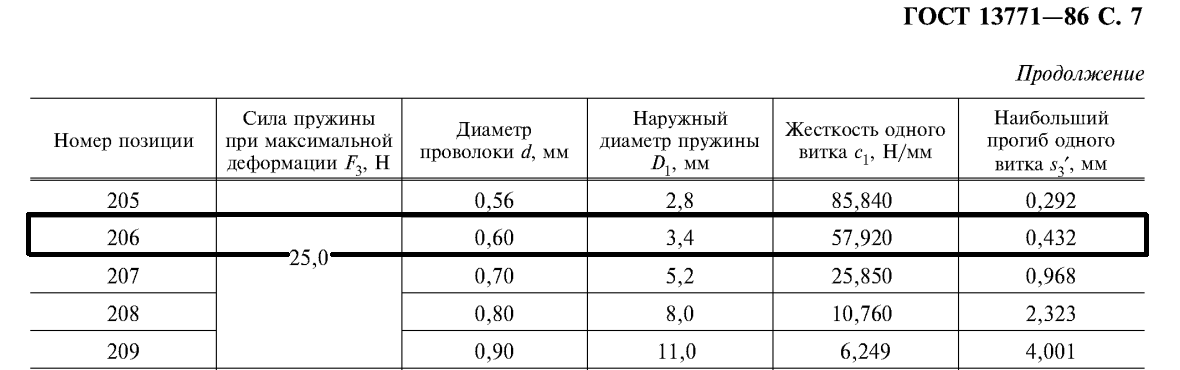
[picture p32: figure]

Параметры пружины:

3

1

2

25
0,6
3,4

57,920

0,421

P | Н
d | мм
D | мм
| Н
c | мм
s | мм

=
=
=

=

=

- Определим длину рабочей деформации
раб

f :

1

cos | 2 sin | 12cos8 | 2 9,5sin8 | 12 2,52751
2 | 2

раб

f | L | L L | A | L | мм
φ | φ | ° | °
= | − = | + | − = | + · | − | =
- Жесткость пружины

2
2,52

21,2501
8,40752
751 раб
P | Н
k
f | мм
= | = | =
- Число рабочих витков:

1

57,920
6,8891 7
8,40752

c
n
k
= | = | = | ≈
- Число витков с зацепами:
0 | 2

n = n + n ,

где 2

n =1.5...3.5 – для пружин сжатия

2

n = 2.5 – для пружин растяжения

0

n = 7 + 2,5 = 9,5

- Высота пружины в свободном состоянии:

Н | n | d | мм 0 = | + | = | + · | = ( 0
1) (9,5 1) 0,6 6,3
- Полная длина с крючками:
0 L′ = | + | = | + · | = H | 2D 6,3 2 3,4 13,1мм
Учитывая, что диаметр впадин | 26.95 f
d = | мм, пружина вмещается по

полной длине с крючками в зубчатое колесо.

Общая толщина колеса будет составлять 3,2 мм. При проверке на

контактую прочность и с учетом пунтка 12 «Проверочный расчёт», получаем:
| | | | | ( | )
| | ( | | | | )

max 10

3

3

108,5 | 1
108,5 0.9 | 4,19 1 | 1,3 382,5
269,5016
18,025 4,19 | | 1,6
jk | k
k
H
w jk

z

i | kM
a i | b

МПа

σ −

+
= | =
- | + | · | ·
= | =
·
( | )
( | )

max 9

3

3

108,5 | 1
108,5 0.9 | 4,19 1 | 1,3 382,5
180,9286
18,025 4,19 | 3,55
jk | k
k
H
w jk

z

i | kM
a i | b

МПа

σ −

+
= | =
- | + | · | ·
= | =
·

Так как [ ] 55

max10

572
269,5016

2,12 2

н Ст

H

σ
σ
= | = | > | и

[ ] 40

max 9

546
180,9286

3,02 2

н Ст X

H

σ
σ
= | = | >

Проверка пройдена.

16.Расчёт муфты

Расчёт пружины
Крутящий момент двигателя:
Mдв = 0.036 Н ⋅ м

Для надёжной работы муфты момент срабатывания должен превышать рабочий

момент:
Mμ = 1.8 Mдв = 1.8 ⋅ 36 = 64.8 Н ⋅ мм

Для фрикционной муфты:
M = fFRсрz

Где f = 0.25 – коэффициент трения

Rср = 6 мм – средний радиус трения

z = 2 – число поверхностей трения

Усилие пружины:

F =

Mμ
fRсрz

=

64.8
0.25 ⋅ 6 ⋅ 2

= 21.6 Н

Принимаем P1 = 22 Н

Для компенсации износа и обеспечения запаса усилия: P2 = 1.5 ⋅ P1

P2 = 1.5 ⋅ 22 = 33 Н

Сила пружины при максимальной деформации:

P3 =

P2
1 − δ
Для пружин сжатия δ = 0.05

P3 =

33
1 − 0.05 = 34.74 Н

Выберем материал пружины по таблице 12

Таблица 12 – Механические свойства пружинных сталей и сплавов для упругих

деталей муфт.

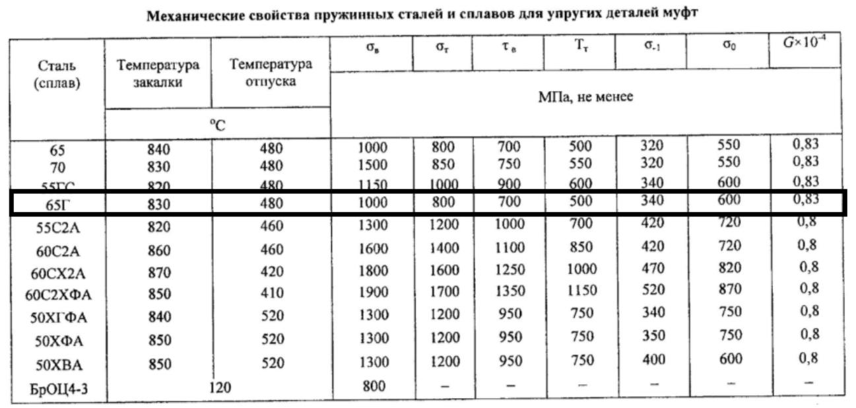
[picture p33: figure]

Выбрали сталь 65Г
[τ] = 583.3 МПа

Пусть индекс пружины C = 6

Коэффициент кривизны:

kτ =

4C + 2
4C − 3

=

4 ⋅ 6 + 2
4 ⋅ 6 − 3

= 1.238

Диаметр проволоки определяем по формуле: d = √
1.6kτP3C
[τ]

3

= √
1.6 ⋅ 1.238 ⋅ 34.74 ⋅ 6
583.3

3
= 1.12 мм

Принимаем d = 1.2 мм

Средний диаметр пружины:
Dср = Cd = 6 ⋅ 1.2 = 7.2 мм

Осевая податливость одного витка:

λ =

8C

3
Gd

=

8 ⋅ 6

3
0.83 ⋅ 10⁵ ⋅ 1.2

= 0.0173

мм
Н
Принимаем рабочую деформацию пружины s2 = 2мм

Число рабочих витков:

n =

s2
λ(P2 − P1

)

=

2
0.0173(33 − 22)

= 10.5 ≈ 11

Полное число витков:
n1 = n + 2 = 13

Максимальная осадка пружины:
s3 = λP3n = 0.0173 ⋅ 34.74 ⋅ 11 = 6.61 мм

Высота пружины при максимальной деформации: H3 = n1d = 13 ⋅ 1.2 = 15.6 мм

Длина пружины в свободном состоянии:
H0 = H3 + s3 = 15.6 + 6.61 = 22.21 мм

Расчёт параметров муфты

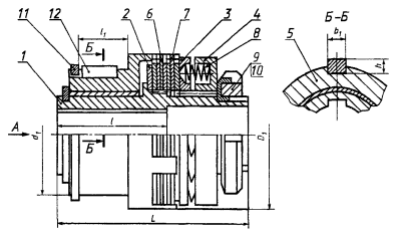
[picture p34: figure]

По техническому заданию необходимо спроектировать фрикционную

предохранительную муфту.

Средний радиус трения:

Rср =

D + d
4

⇒

D = 4Rср − d = 4 ⋅ 6 − 8 = 16 мм

Ширина фрикционного кольца:

b =

D − d
2

=

16 − 8
2

= 4 мм

Рисунок 14 – Фрикционная предохранительная муфты

Определим площадь поверхности трения:

A =

π
4

(D

2 − d

2
) =

3.14
4

(16² − 8

2
) = 150.72 мм

2

Удельное давление на поверхности трения:

p =

F
A

=

22
150.72 = 0.146 МПа

Примем допускаемое давление [p] = 0.3 ÷ 0.6 МПа

p < [p]

Условие выполняется.

Окружная сила трения:
Fтр = fFz = 0.25 ⋅ 22 ⋅ 2 = 11 Н

Проверка передаваемого момента: M = FтрRср = 11 ⋅ 6 = 66 Н ⋅ м

Полученное значение:
M = 66 Н ⋅ м > 64.8 Н ⋅ м

Условие выполняется.
