BogoslavskiM/okp/Подготовка_к_защите/Опора_рейки_ББ.png

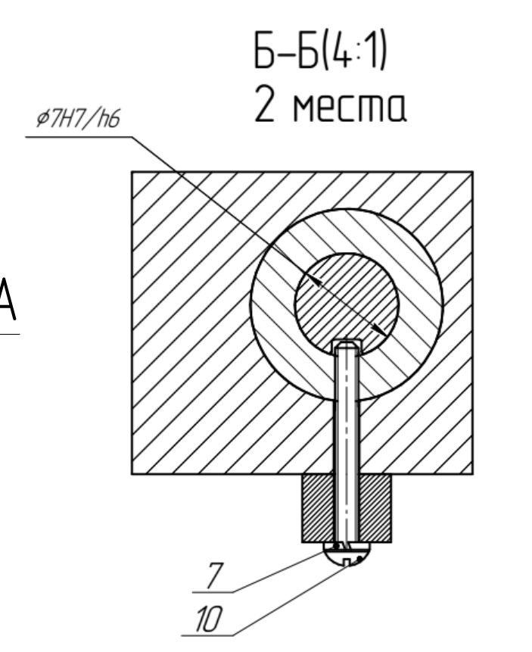
Подготовка_к_защите/Опора_рейки_ББ.png
