BogoslavskiM/okp/Правила_оформления_чертежей/Сборочные чертежи.png

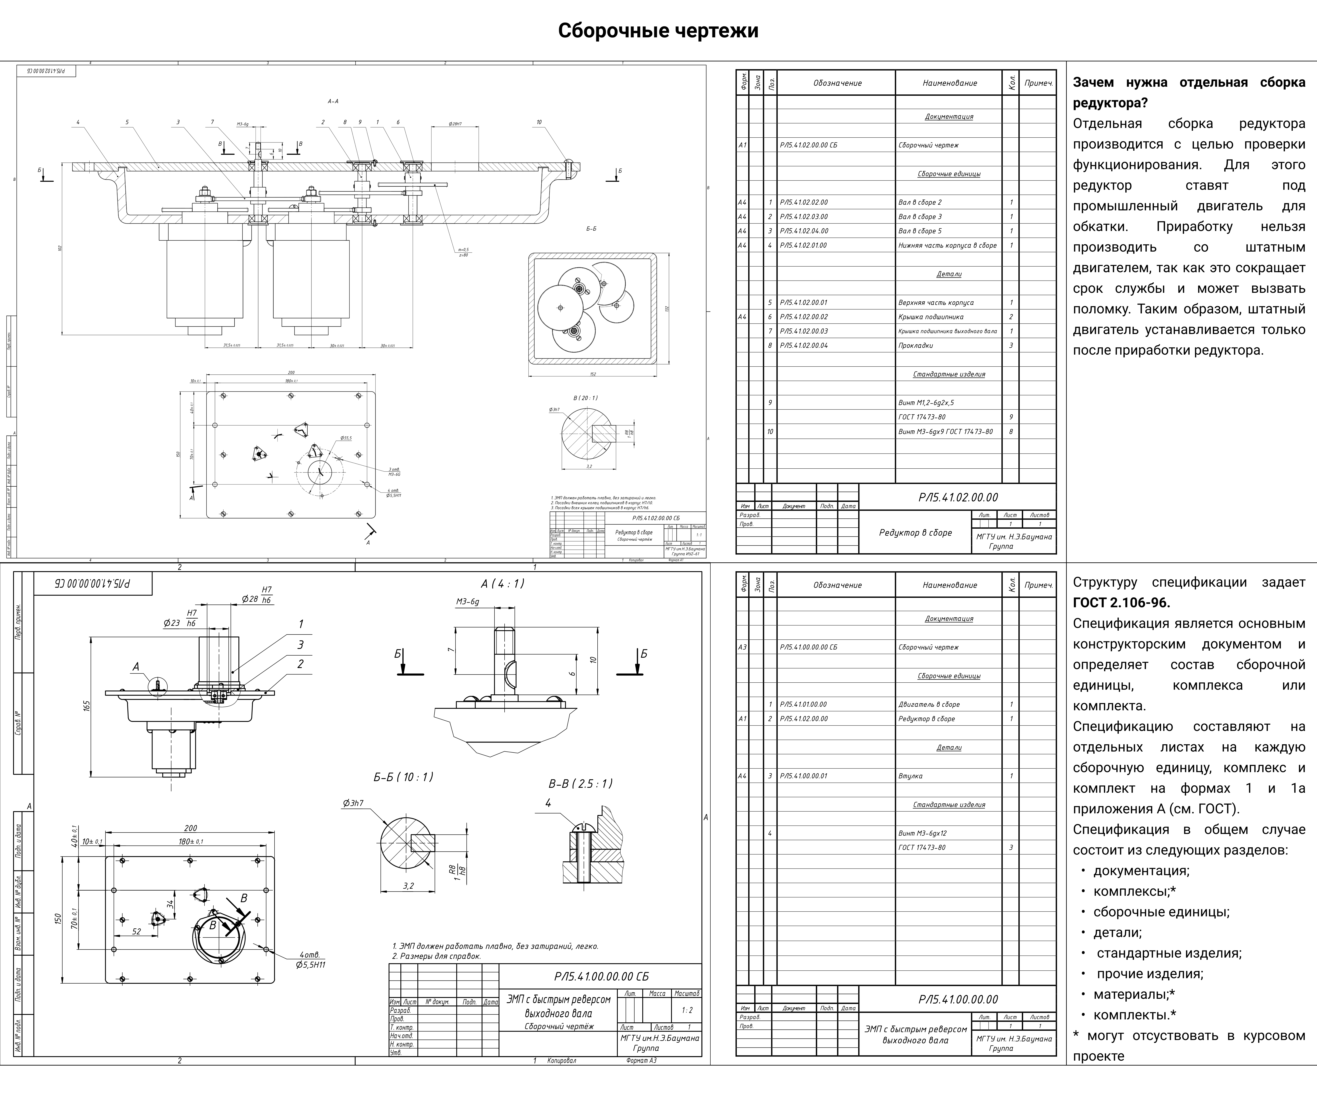
Правила_оформления_чертежей/Сборочные чертежи.png
