BogoslavskiM/okp/Правила_оформления_чертежей/Схема сборки.png

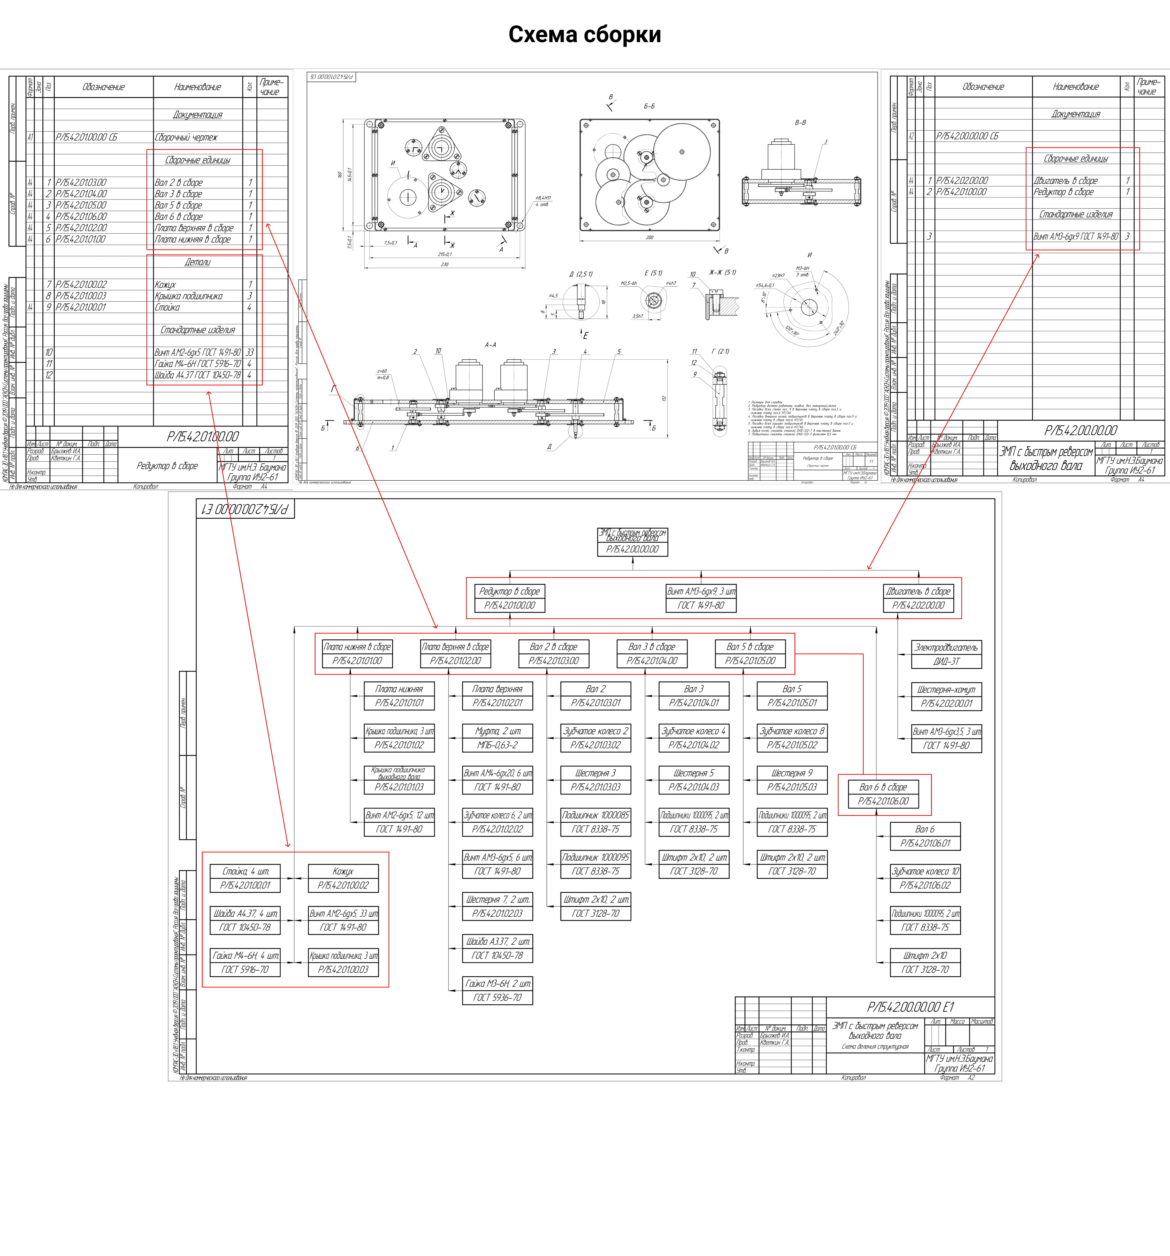
Правила_оформления_чертежей/Схема сборки.png
