BogoslavskiM/okp/Правила_оформления_чертежей/Чертежи деталей и узлов.png

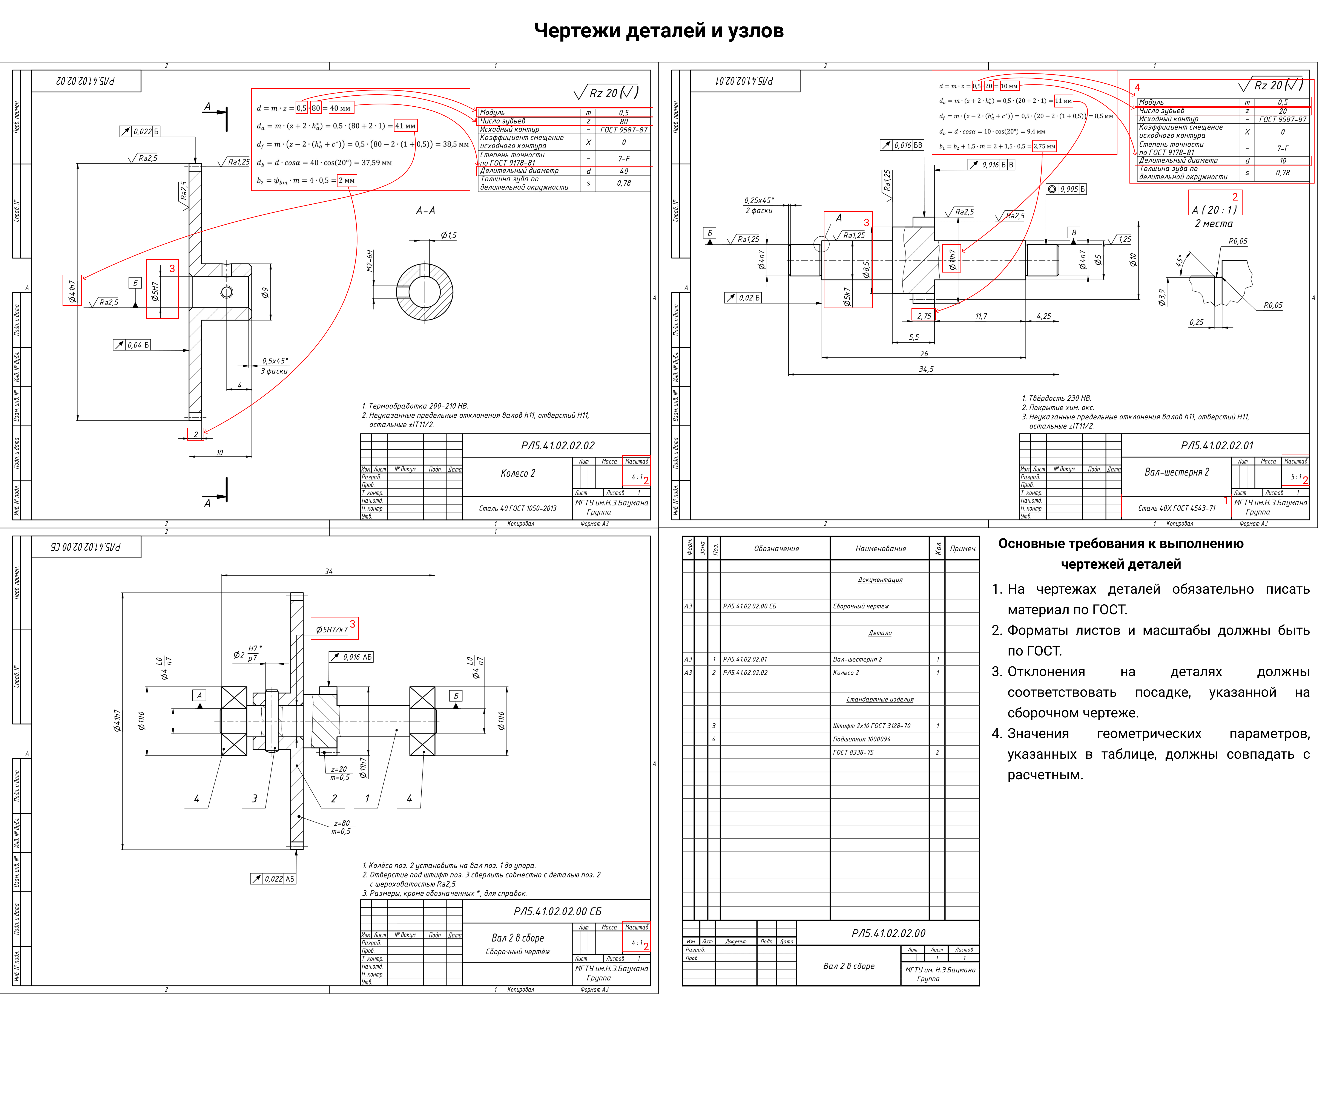
Правила_оформления_чертежей/Чертежи деталей и узлов.png
