BogoslavskiM/okp/Проверка_ОКП/ГГ_по_скриншоту.png

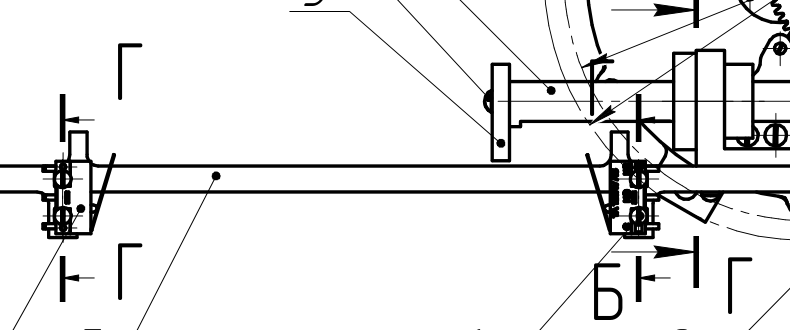
Проверка_ОКП/ГГ_по_скриншоту.png
