BogoslavskiM/okp/Проверка_ОКП/ГОСТ_2.711_рисунок_1_стрелки.png

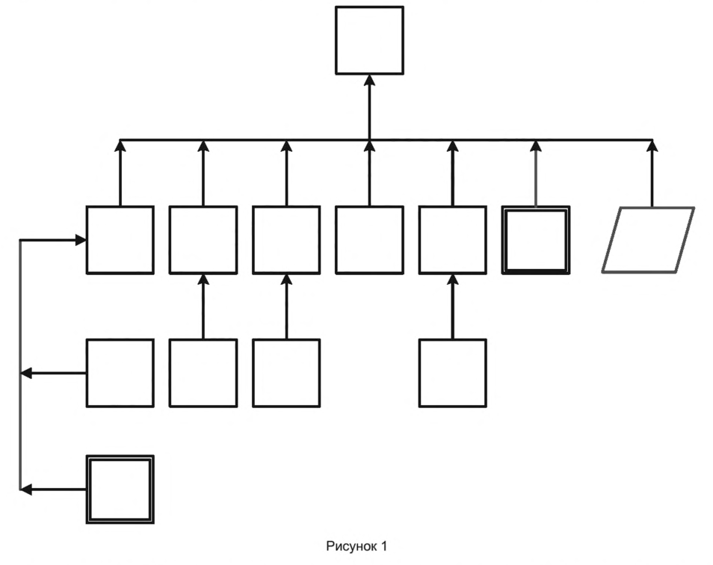
Проверка_ОКП/ГОСТ_2.711_рисунок_1_стрелки.png
