BogoslavskiM/okp/Проверка_ОКП/Пружина_до.png

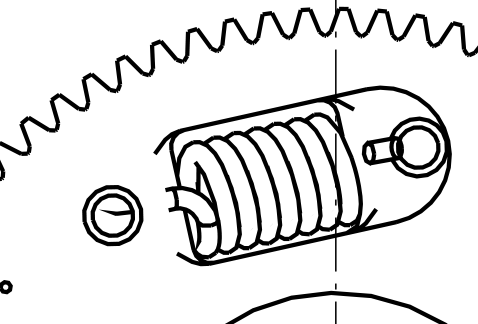
Проверка_ОКП/Пружина_до.png
