BogoslavskiM/okp/Проверка_ОКП/Сборочный_ББ_ГГ_разнесены.png

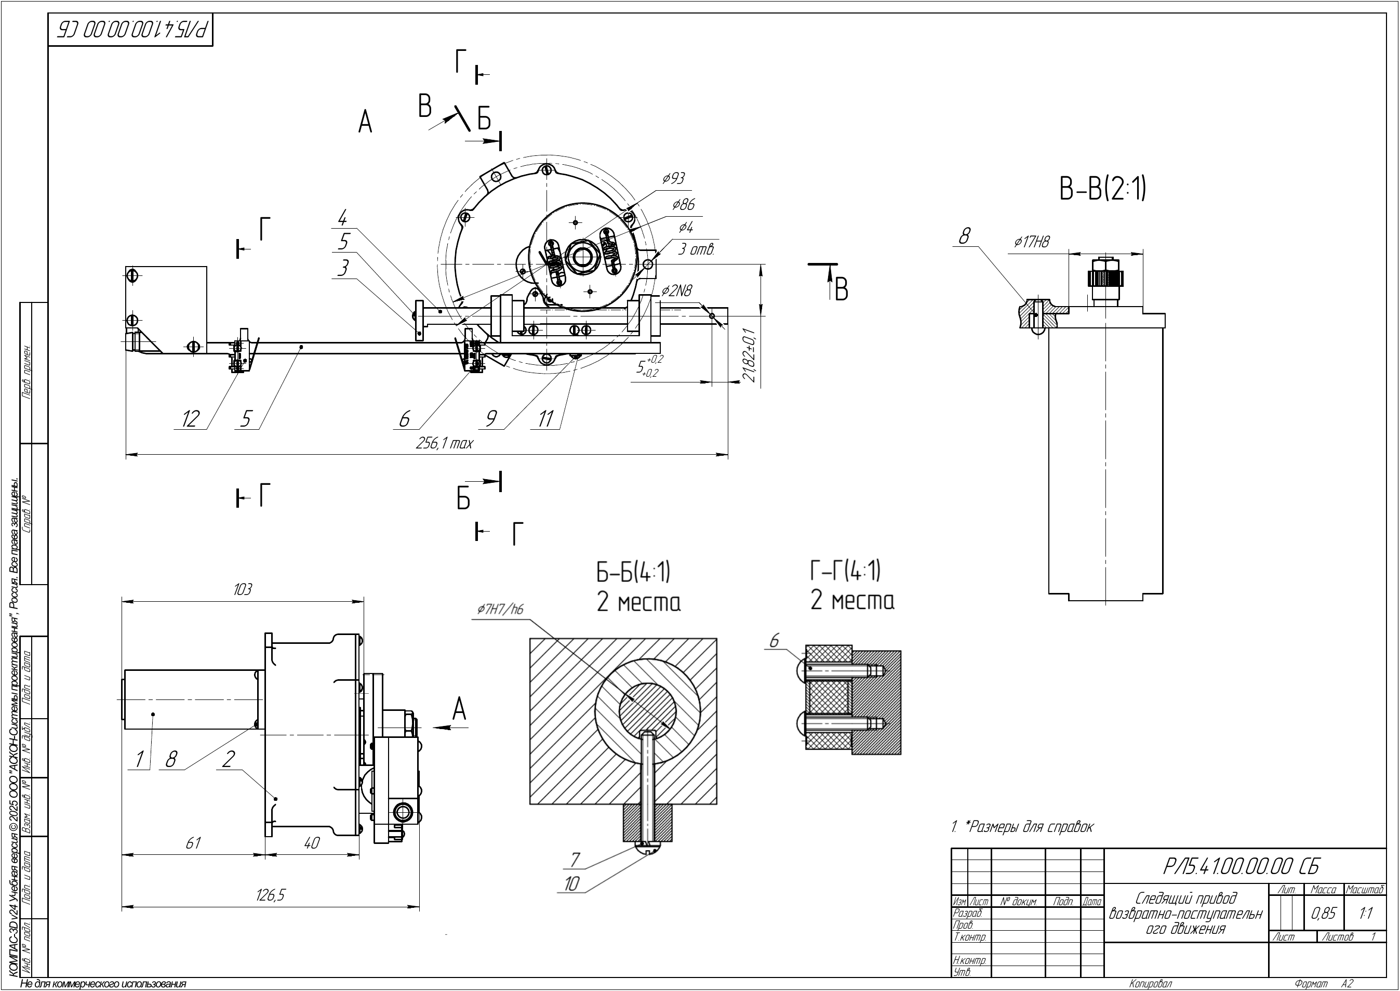
Проверка_ОКП/Сборочный_ББ_ГГ_разнесены.png
