BogoslavskiM/okp/Проверка_ОКП/Сборочный_сечения_после.png

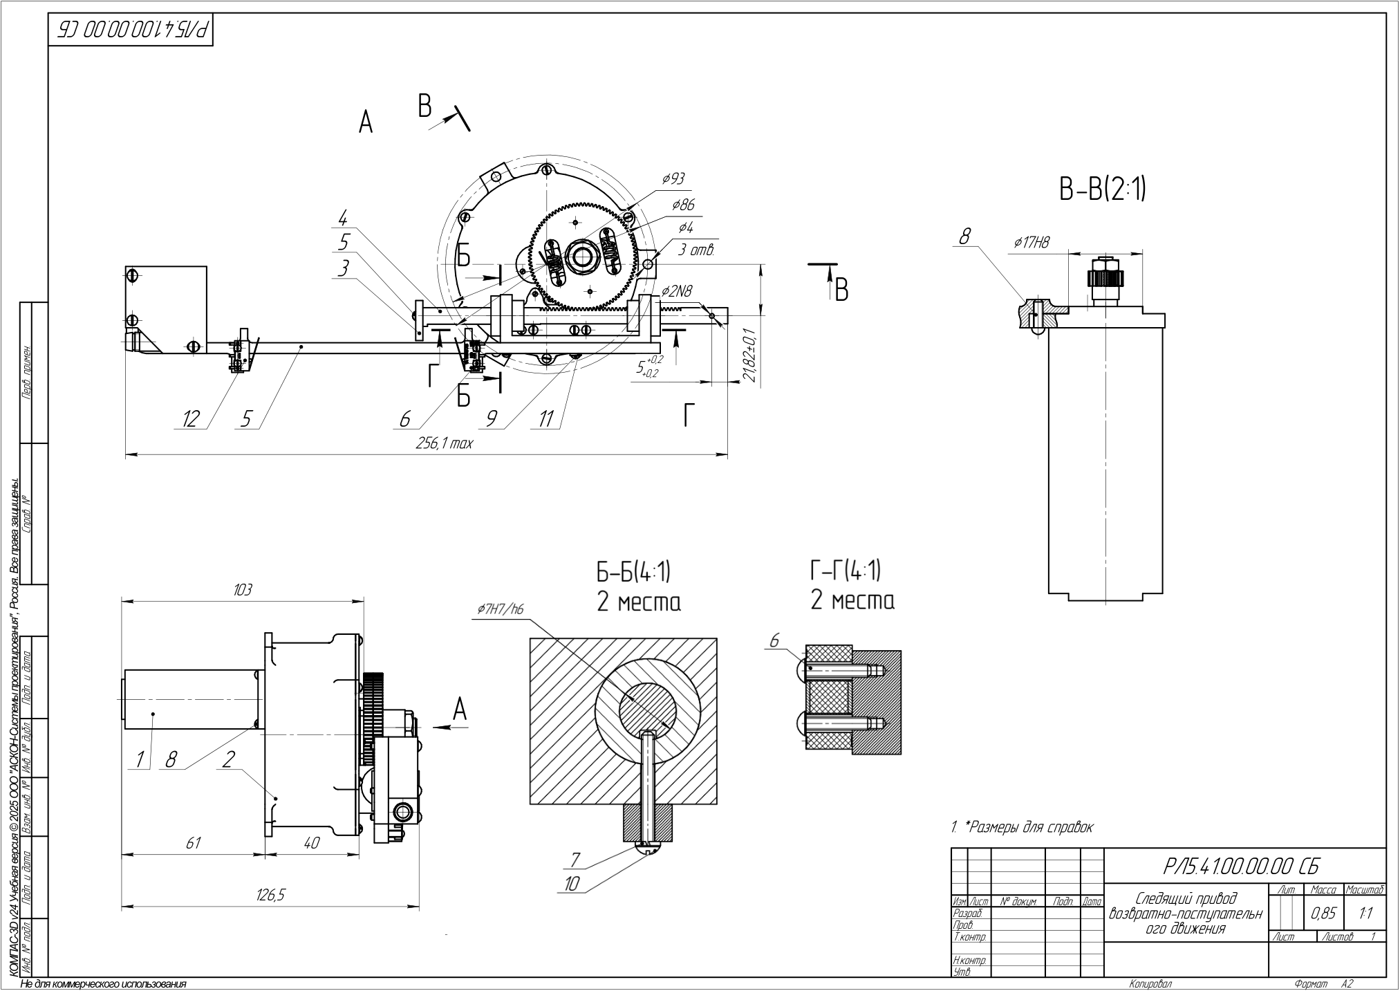
Проверка_ОКП/Сборочный_сечения_после.png
