BogoslavskiM/okp/Проверка_ОКП/Форматы_листов_пособие_2022_с6.png

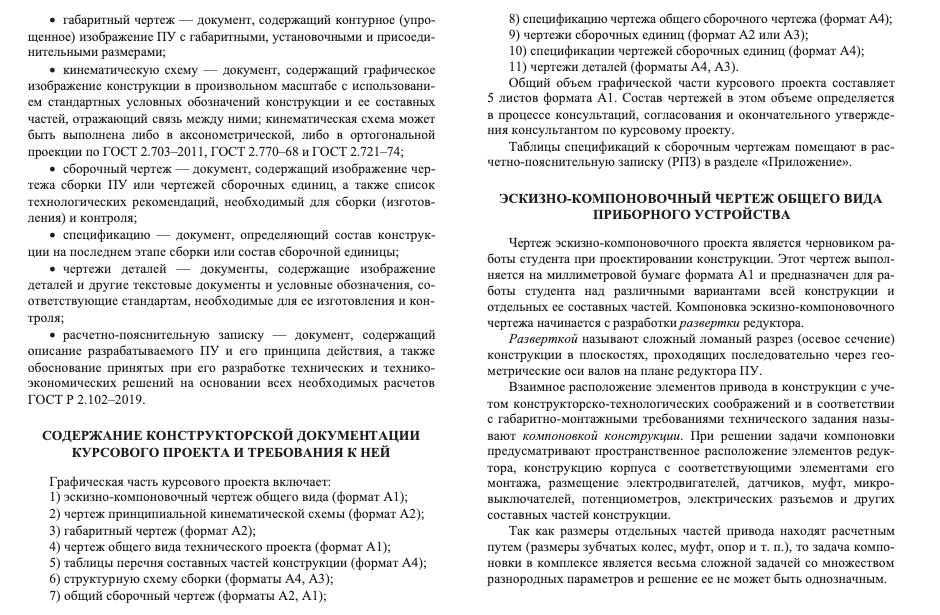
Проверка_ОКП/Форматы_листов_пособие_2022_с6.png
