BogoslavskiM/okp/Проверка_ОКП/Шестерни/Габаритный_колесо.png

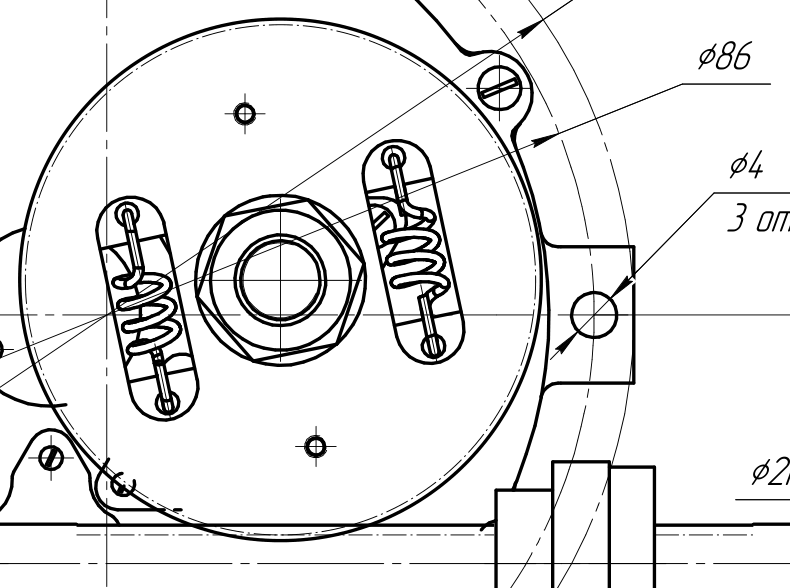
Проверка_ОКП/Шестерни/Габаритный_колесо.png
