BogoslavskiM/okp/Проверка_ОКП/Шестерни/Габаритный_чертёж_шестерни_по_ГОСТ.png

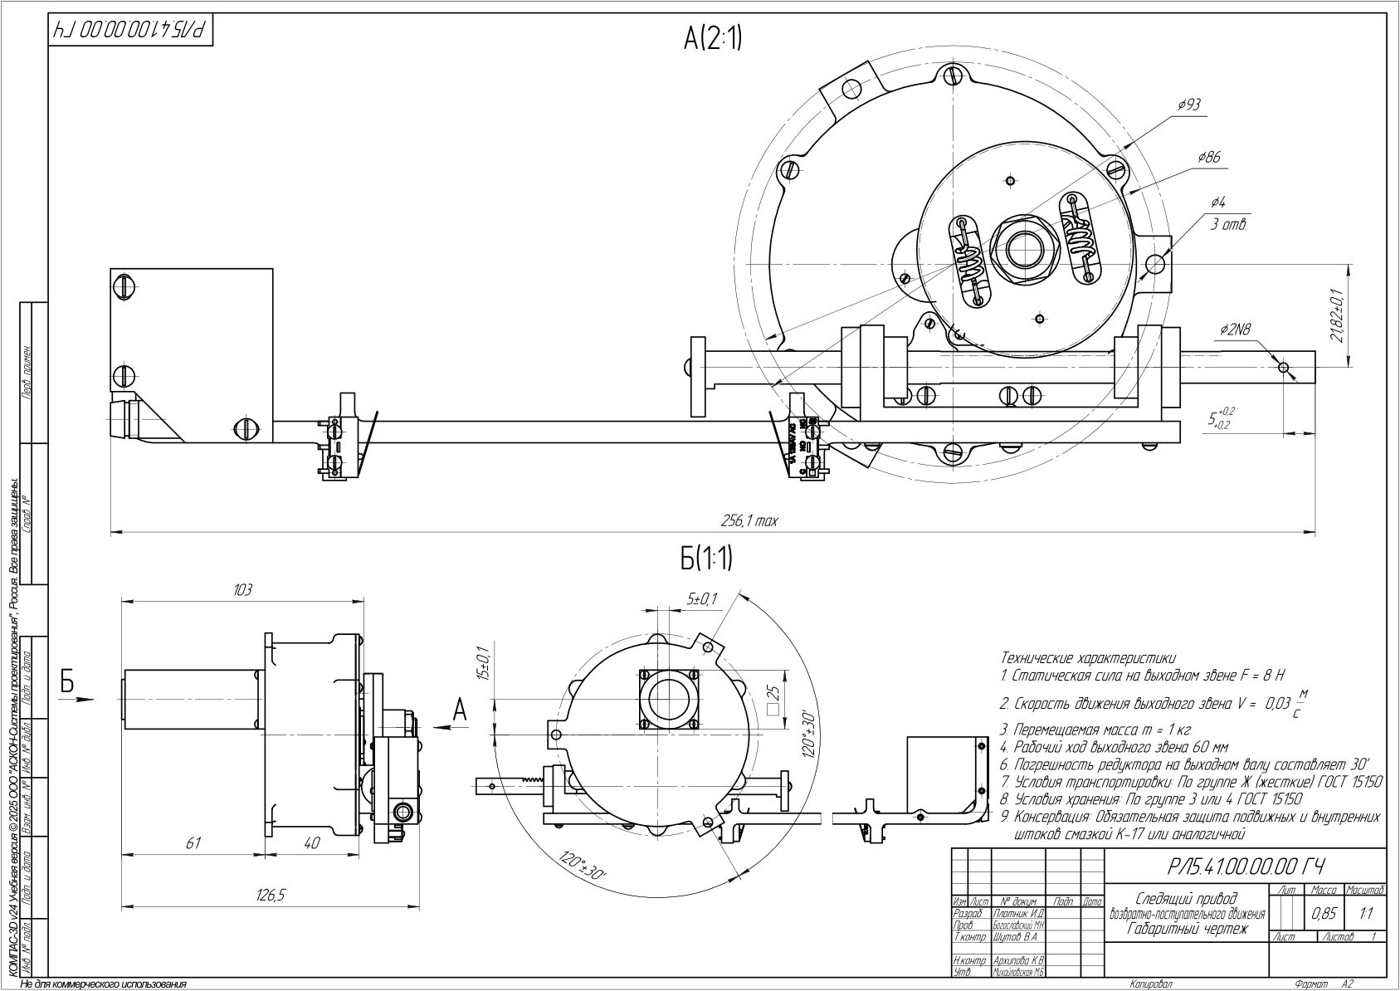
Проверка_ОКП/Шестерни/Габаритный_чертёж_шестерни_по_ГОСТ.png
