BogoslavskiM/okp/Проверка_ОКП/Шестерни/Сборочный_вид_сбоку.png

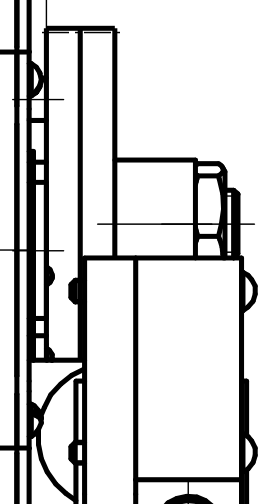
Проверка_ОКП/Шестерни/Сборочный_вид_сбоку.png
