BogoslavskiM/okp/Проверка_ОКП/Шестерни/Сборочный_колесо.png

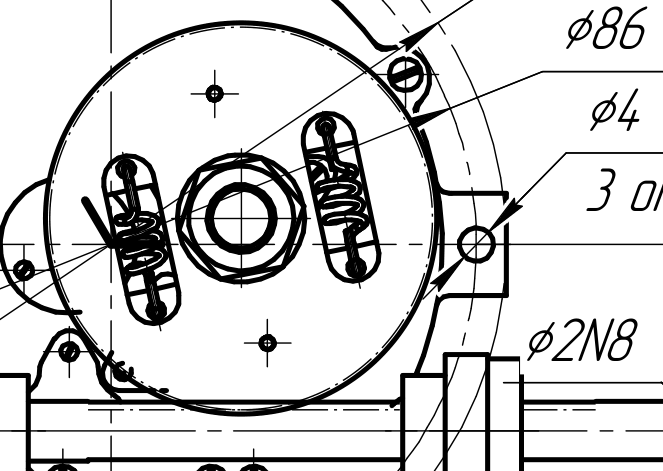
Проверка_ОКП/Шестерни/Сборочный_колесо.png
