BogoslavskiM/okp/Проверка_ОКП/Шрифты_сравнение_сборочный.png

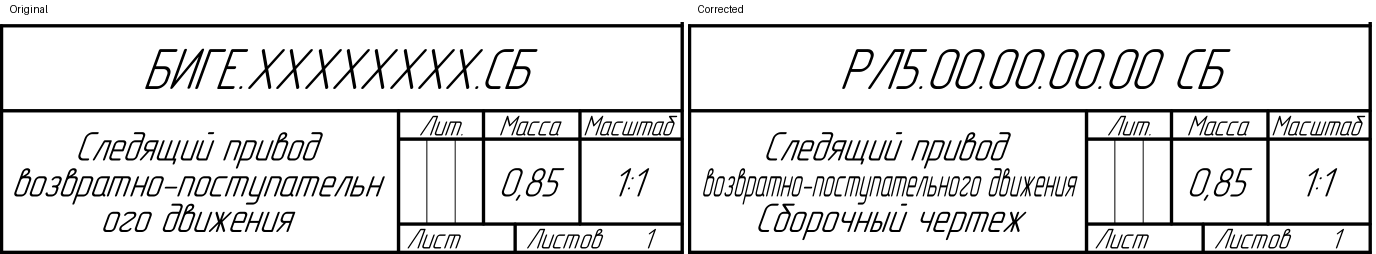
Проверка_ОКП/Шрифты_сравнение_сборочный.png
