BogoslavskiM/okp/Проверка_ОКП/Шрифты_сравнение_структурная.png

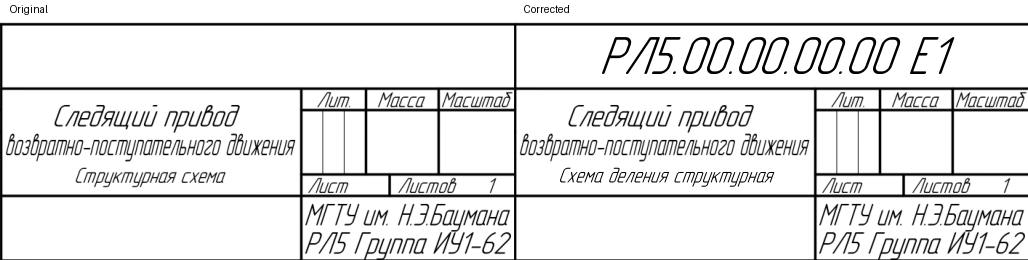
Проверка_ОКП/Шрифты_сравнение_структурная.png
