BogoslavskiM/okp/Проверка_ОКП/Штамп_схемы_из_пособия_2022.png

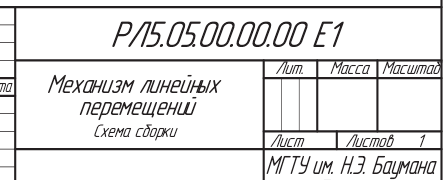
Проверка_ОКП/Штамп_схемы_из_пособия_2022.png
