BogoslavskiM/okp/Сборочный_чертёж_редуктора/Б_В_после.png

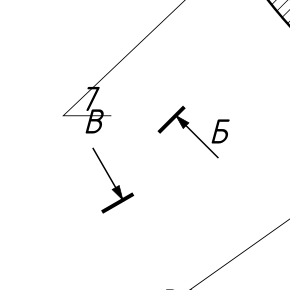
Сборочный_чертёж_редуктора/Б_В_после.png
