BogoslavskiM/okp/Сборочный_чертёж_редуктора/ББ_проверка.png

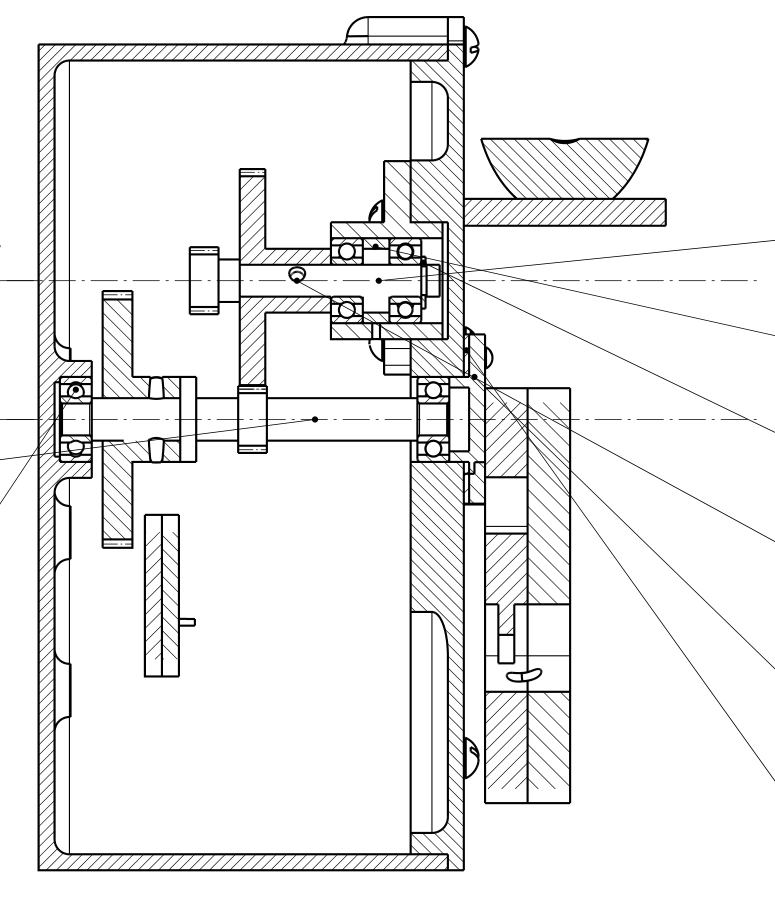
Сборочный_чертёж_редуктора/ББ_проверка.png
