BogoslavskiM/okp/Сборочный_чертёж_редуктора/ГГ_проверка.png

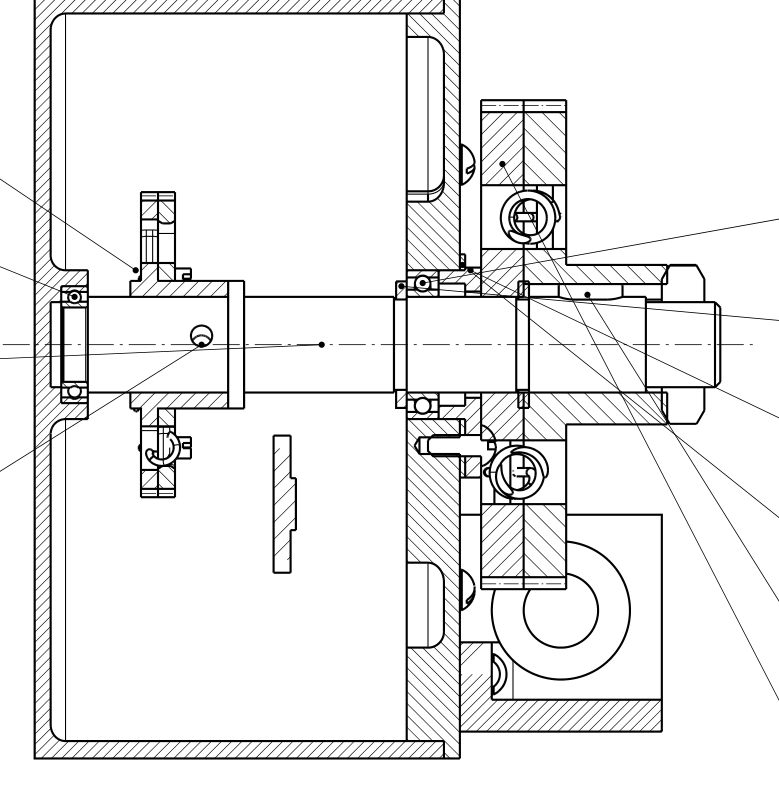
Сборочный_чертёж_редуктора/ГГ_проверка.png
