BogoslavskiM/okp/Сборочный_чертёж_редуктора/Исходные_данные/Проекции/front_preview.png

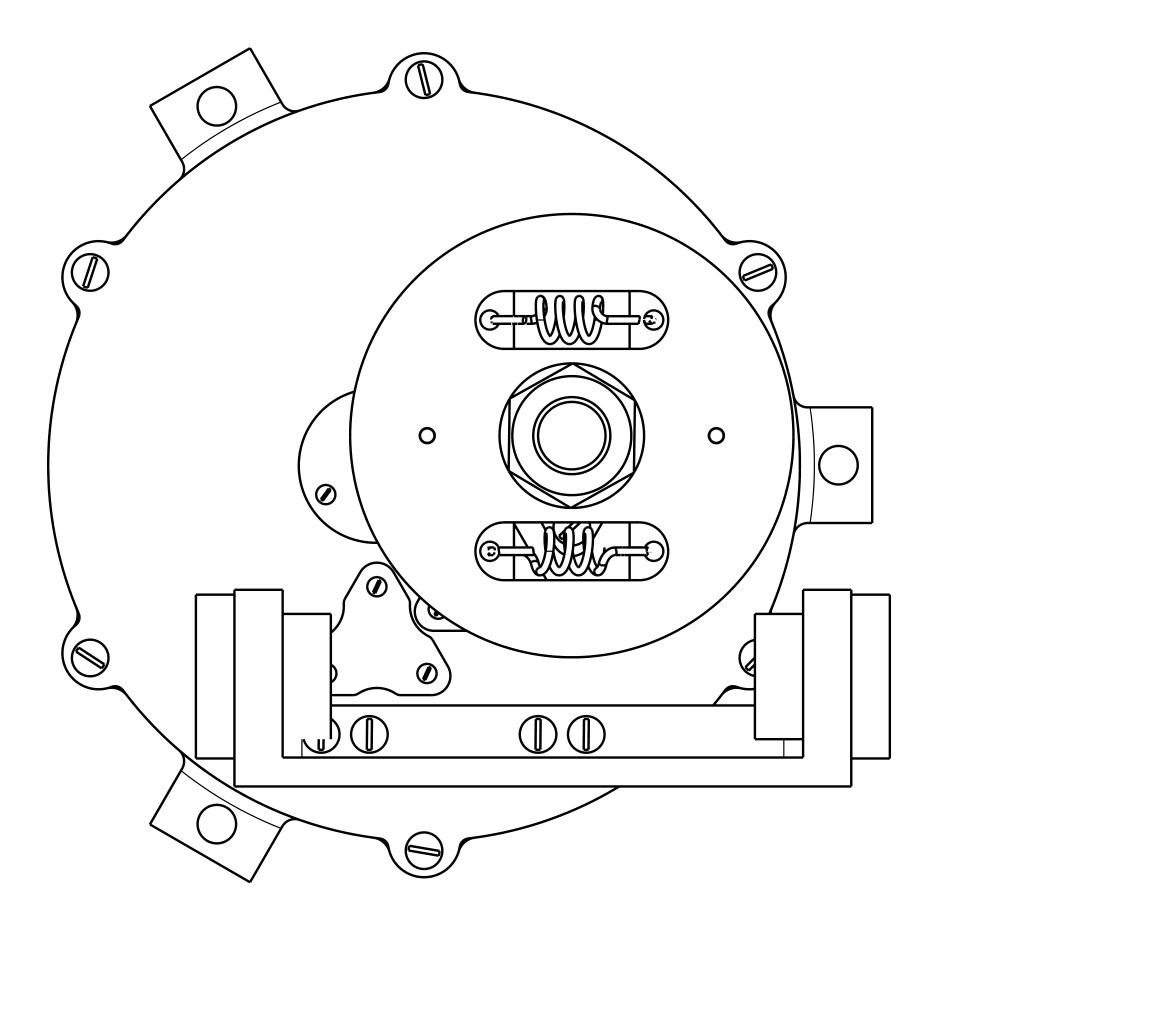
Сборочный_чертёж_редуктора/Исходные_данные/Проекции/front_preview.png
