BogoslavskiM/okp/Сборочный_чертёж_редуктора/Исходные_данные/Проекции/section_a_preview.png

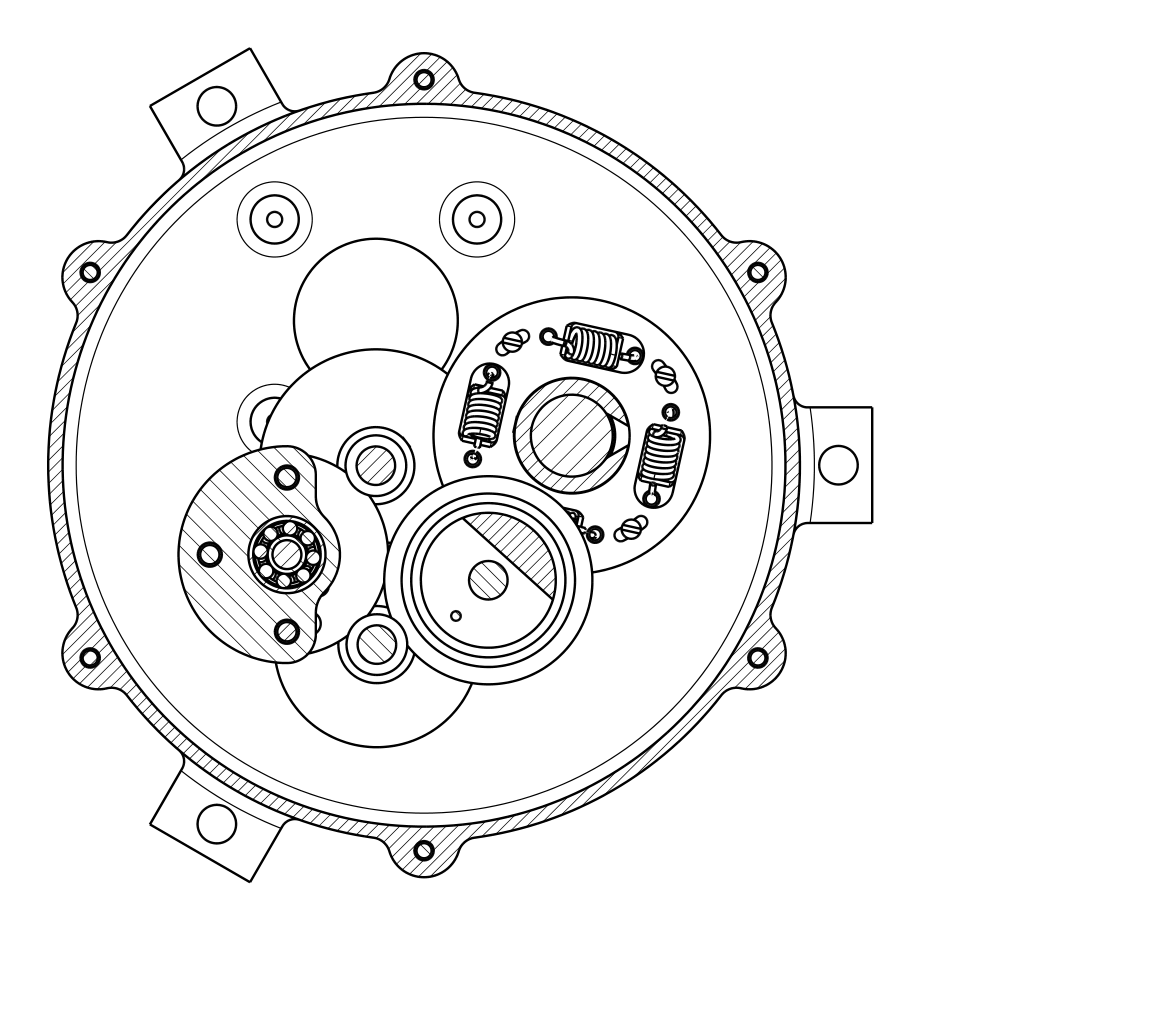
Сборочный_чертёж_редуктора/Исходные_данные/Проекции/section_a_preview.png
