BogoslavskiM/okp/Сборочный_чертёж_редуктора/Исходные_данные/Проекции/side_preview.png

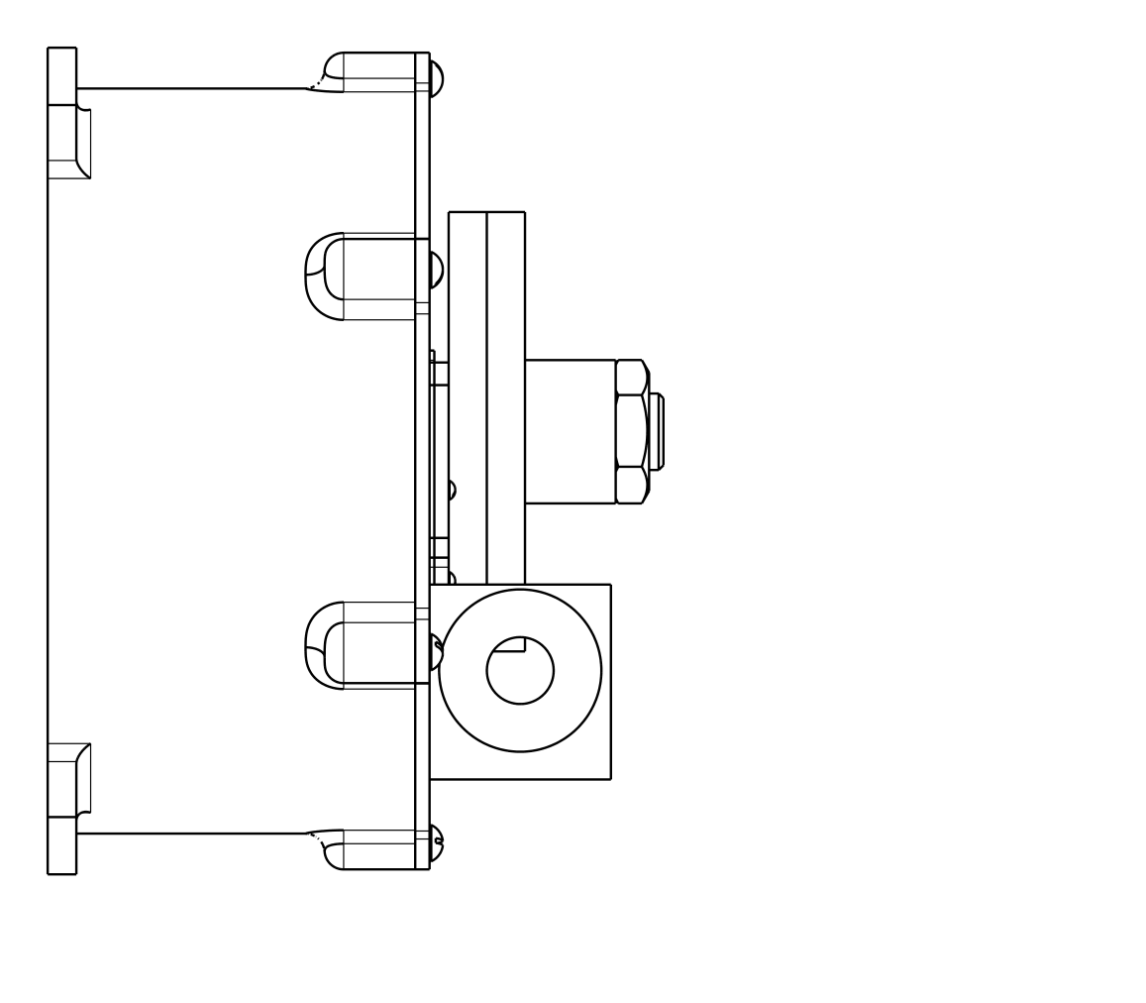
Сборочный_чертёж_редуктора/Исходные_данные/Проекции/side_preview.png
