BogoslavskiM/okp/Сборочный_чертёж_редуктора/Исходные_данные/Проекции/spring_new.png

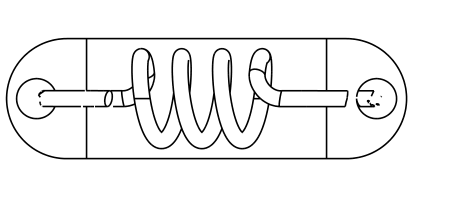
Сборочный_чертёж_редуктора/Исходные_данные/Проекции/spring_new.png
