BogoslavskiM/okp/Сборочный_чертёж_редуктора/Предпросмотр.png

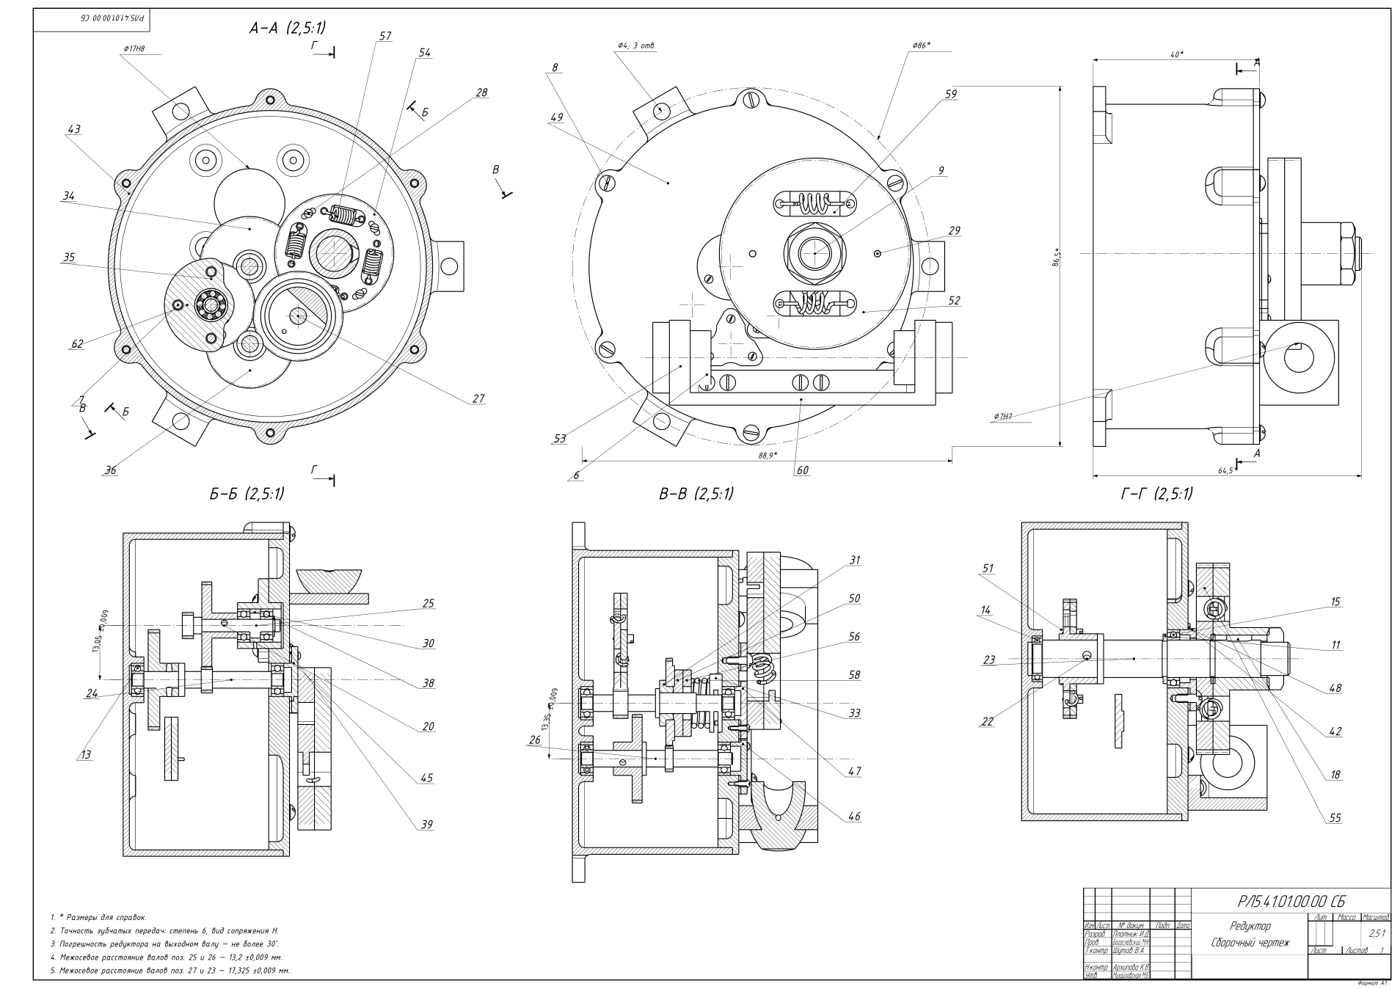
Сборочный_чертёж_редуктора/Предпросмотр.png
