BogoslavskiM/okp/Сборочный_чертёж_редуктора/Штамп.png

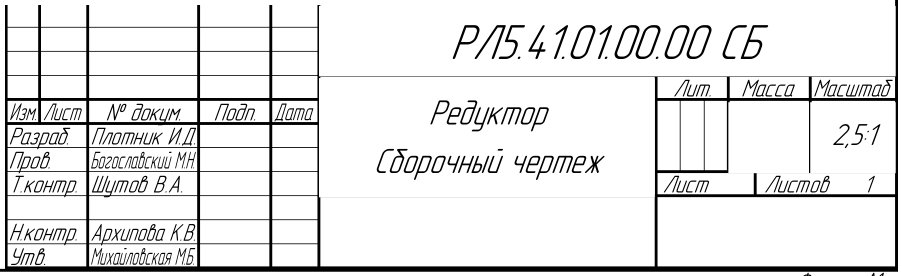
Сборочный_чертёж_редуктора/Штамп.png
