BogoslavskiM/okp/Сборочный_чертёж_редуктора/Штамп_рамка.png

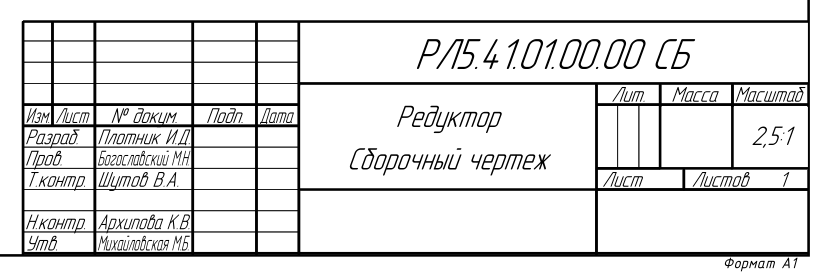
Сборочный_чертёж_редуктора/Штамп_рамка.png
