BogoslavskiM/okp/Чертёж_общего_вида/Предпросмотр.png

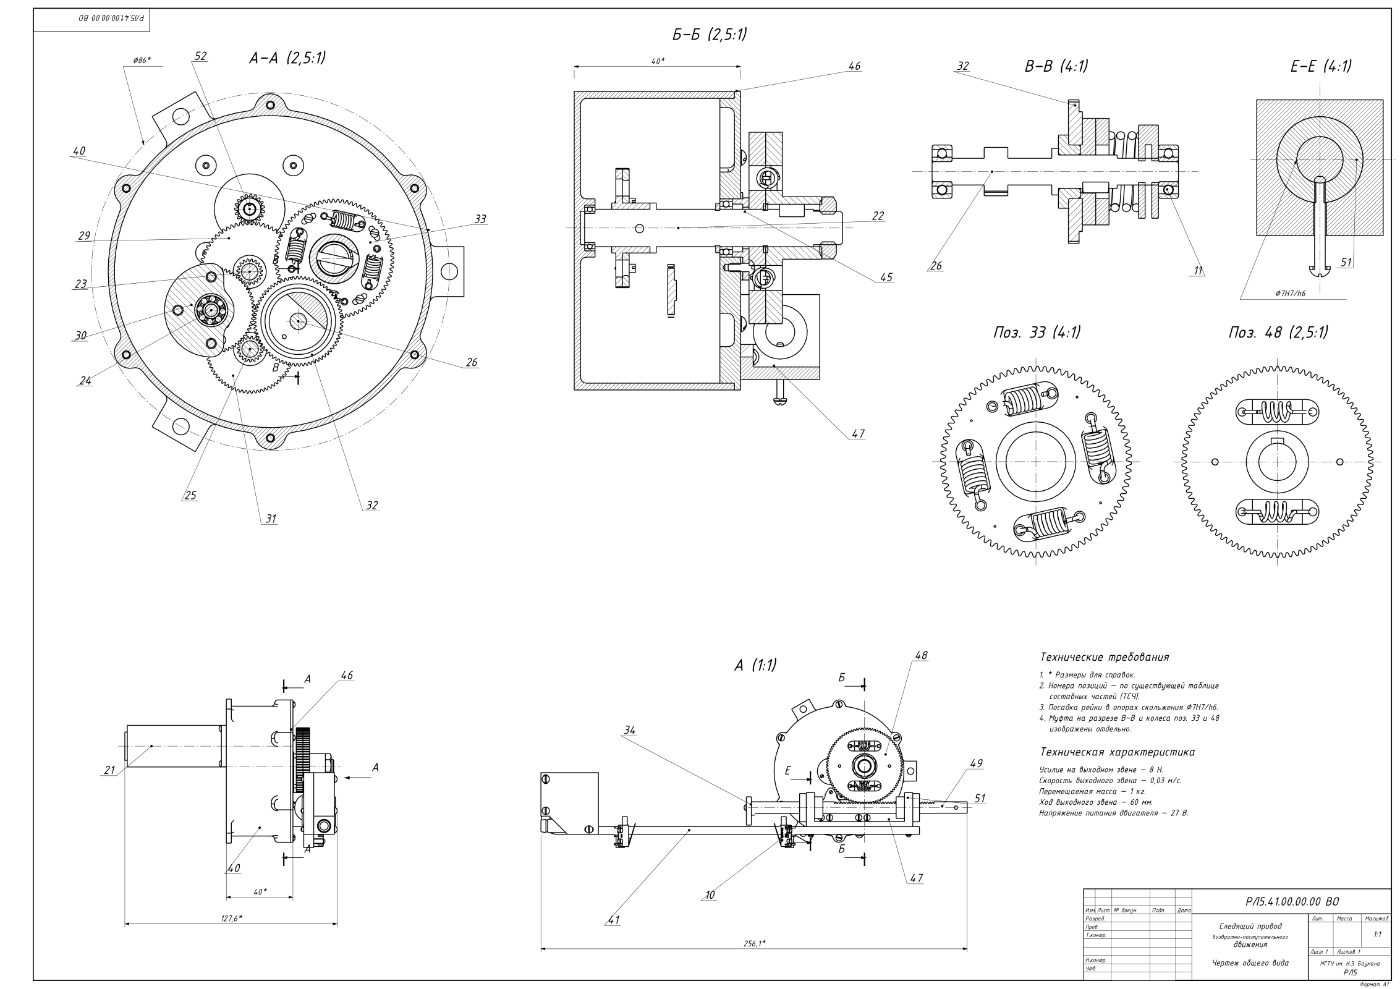
Чертёж_общего_вида/Предпросмотр.png
