BogoslavskiM/okp/Чертёж_общего_вида/Предпросмотр_все_правки.png

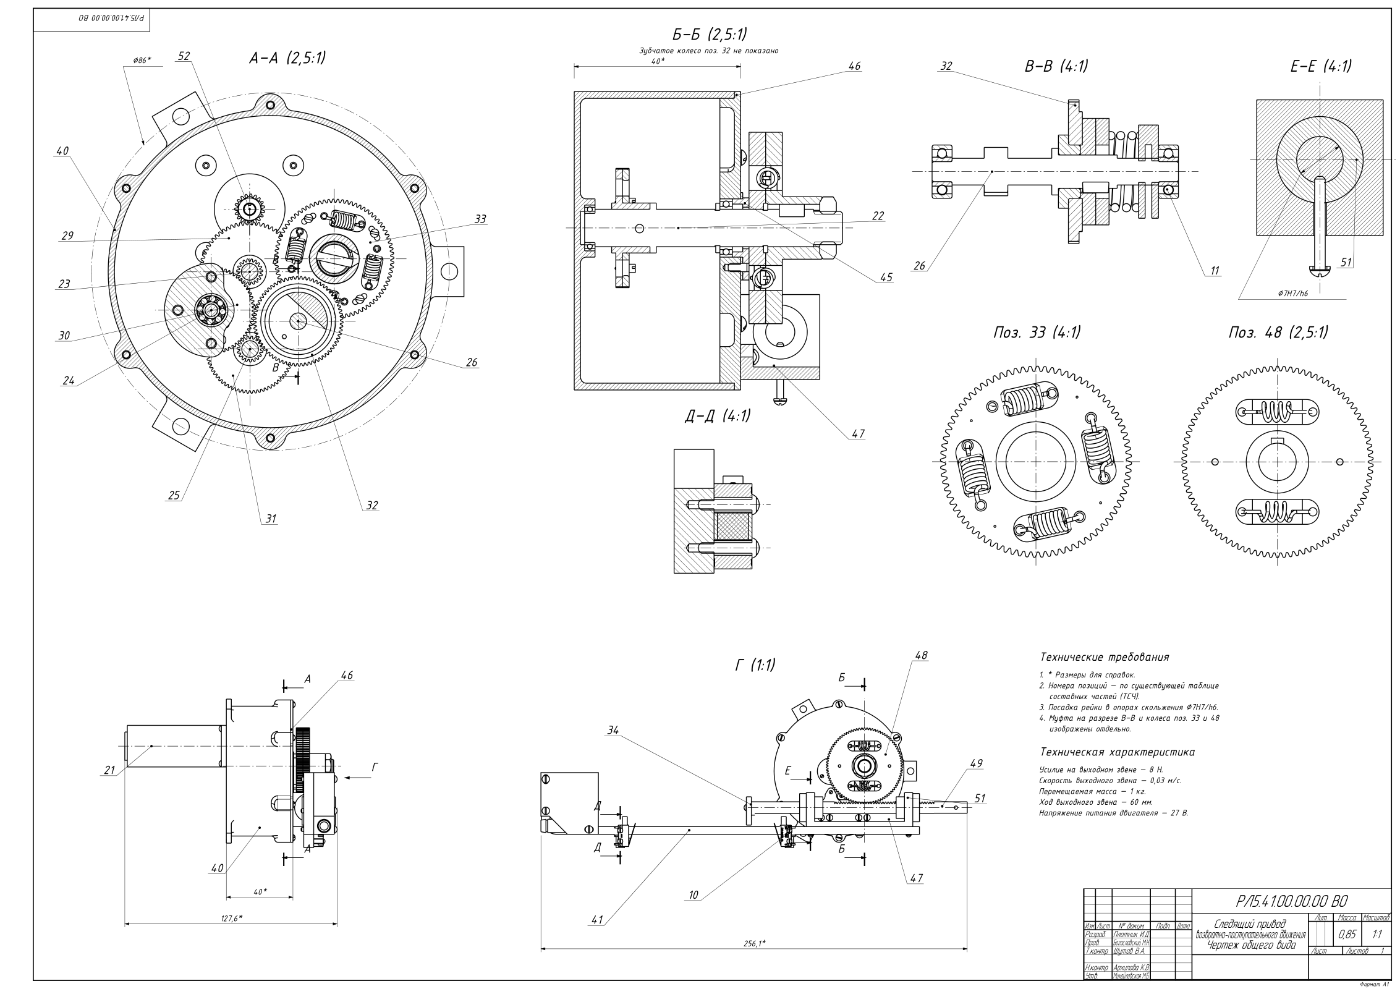
Чертёж_общего_вида/Предпросмотр_все_правки.png
