BogoslavskiM/okp/ОКП/Датчик AXIS-M.stp

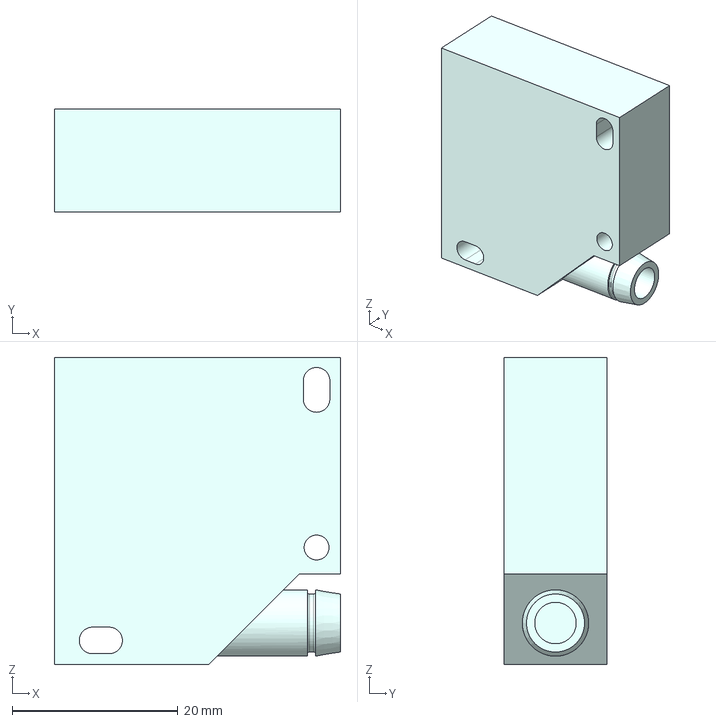
[picture p64: CAD file, 2026-09-13]
ОКП/Датчик AXIS-M.stp
34.5 x 12.4 x 37.0 mm
