BogoslavskiM/okp/ОКП/Речное ЛВК Z12.stp

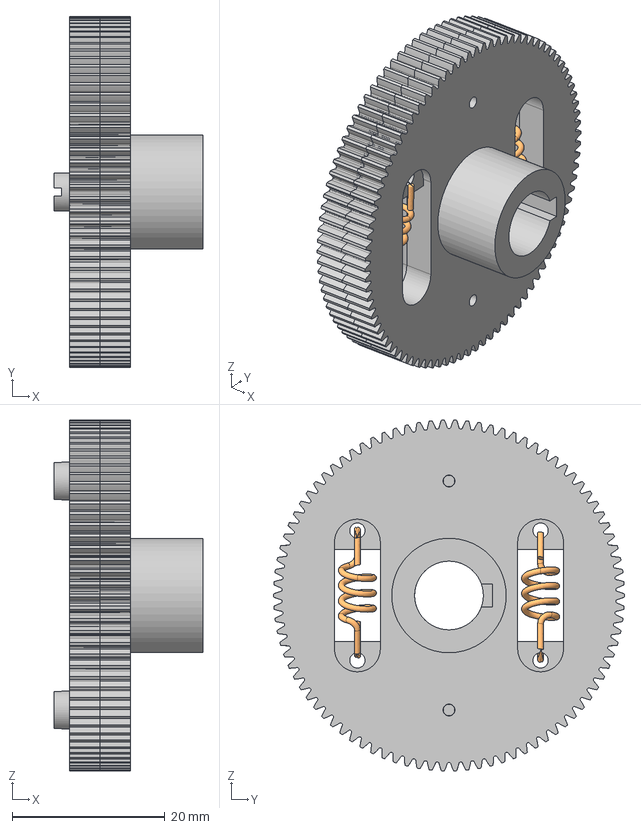
[picture p65: CAD file, 2026-09-13]
ОКП/Речное ЛВК Z12.stp
19.5 x 46.0 x 46.0 mm
