BogoslavskiM/okp/ОКП/Муфта в сборе.stp

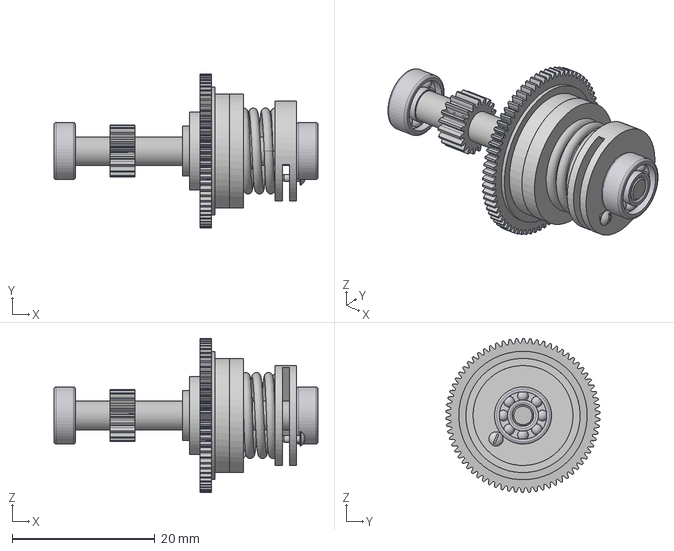
[picture p66: CAD file, 2026-09-13]
ОКП/Муфта в сборе.stp
37.0 x 21.6 x 21.6 mm
