BogoslavskiM/okp/структурная_схема.pdf

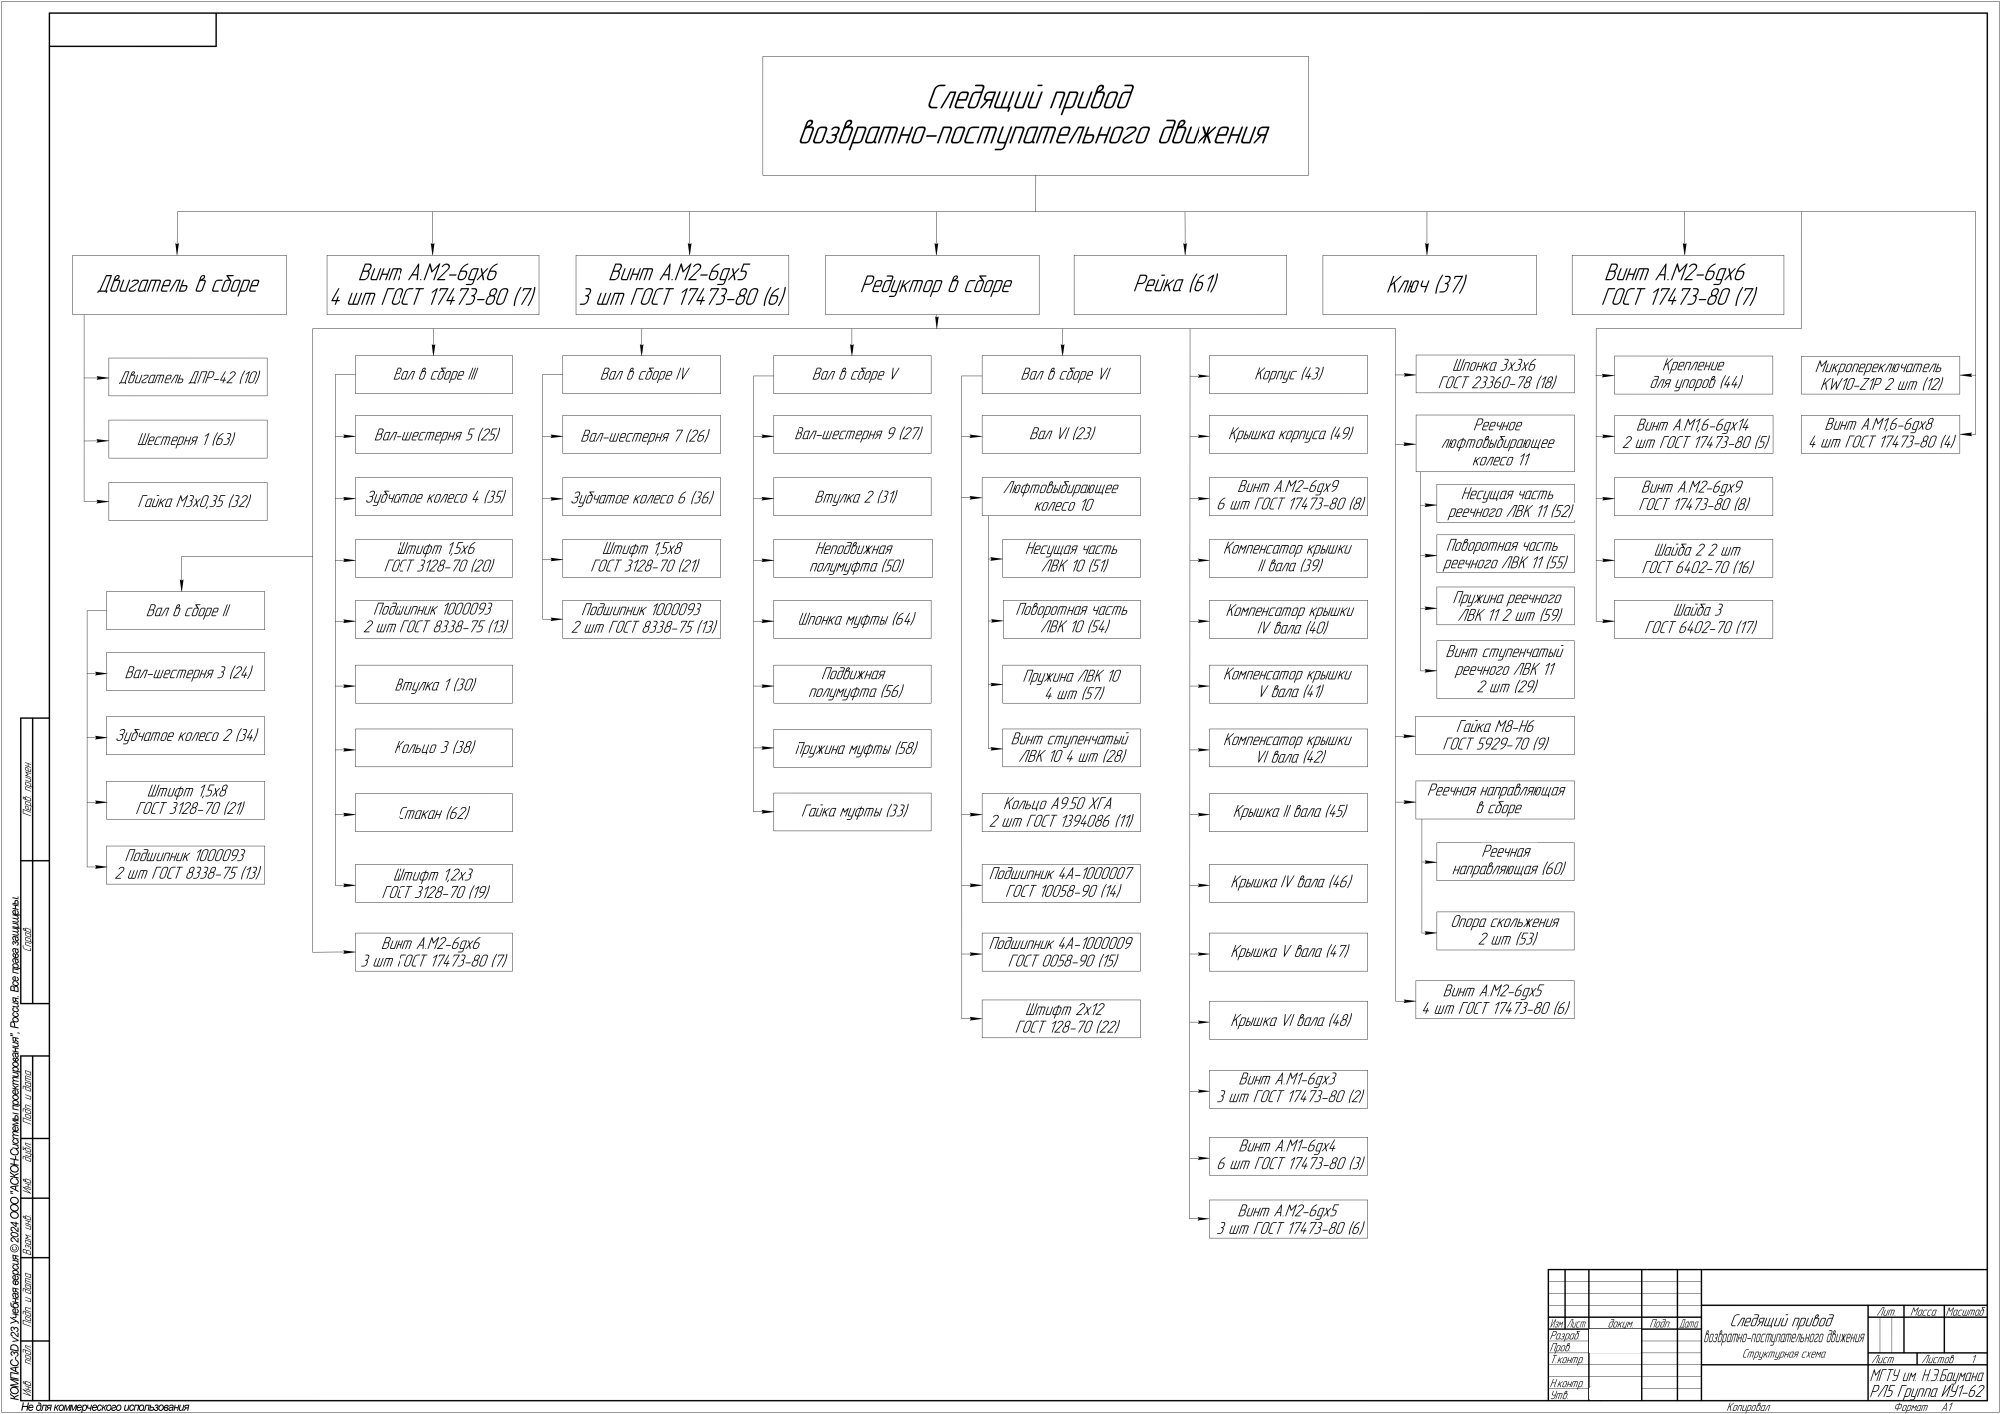
[picture p67: page 1]
