BogoslavskiM/okp/Исправить/Е1_структурная_схема.pdf

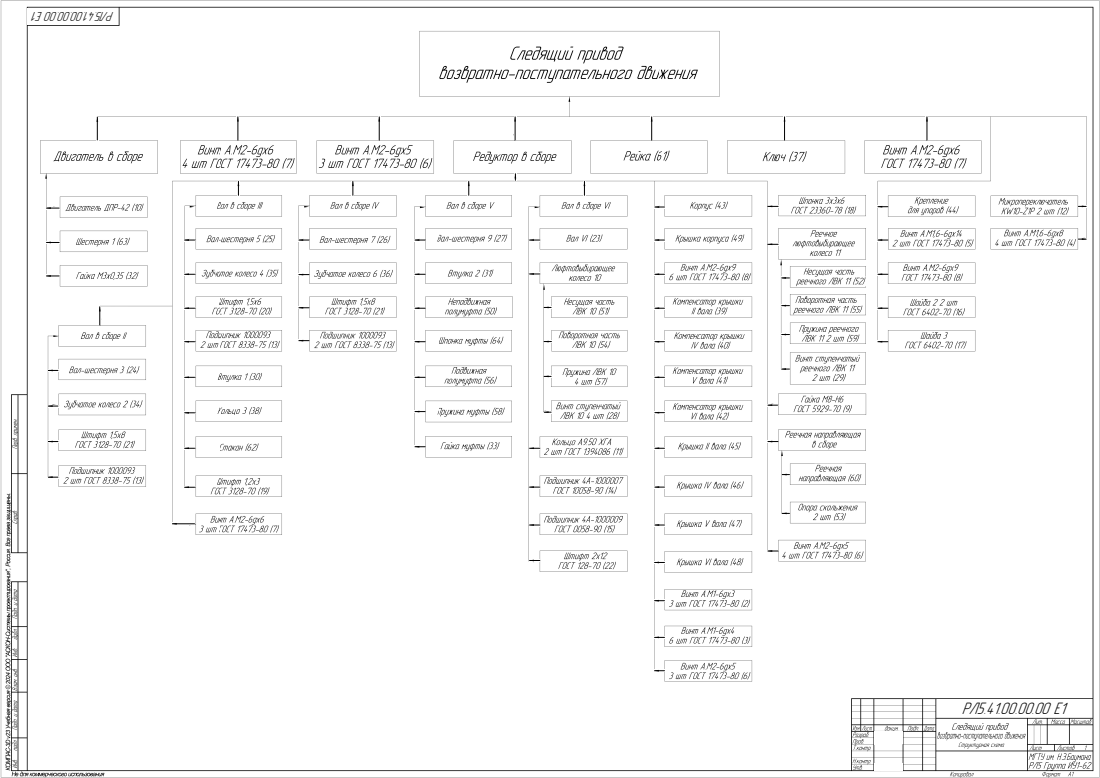
[picture p68: page 1]
