BogoslavskiM/okp/Чертёж_общего_вида/Чертёж_общего_вида_А1.pdf

А–А (2,5:1)

Б–Б (2,5:1)

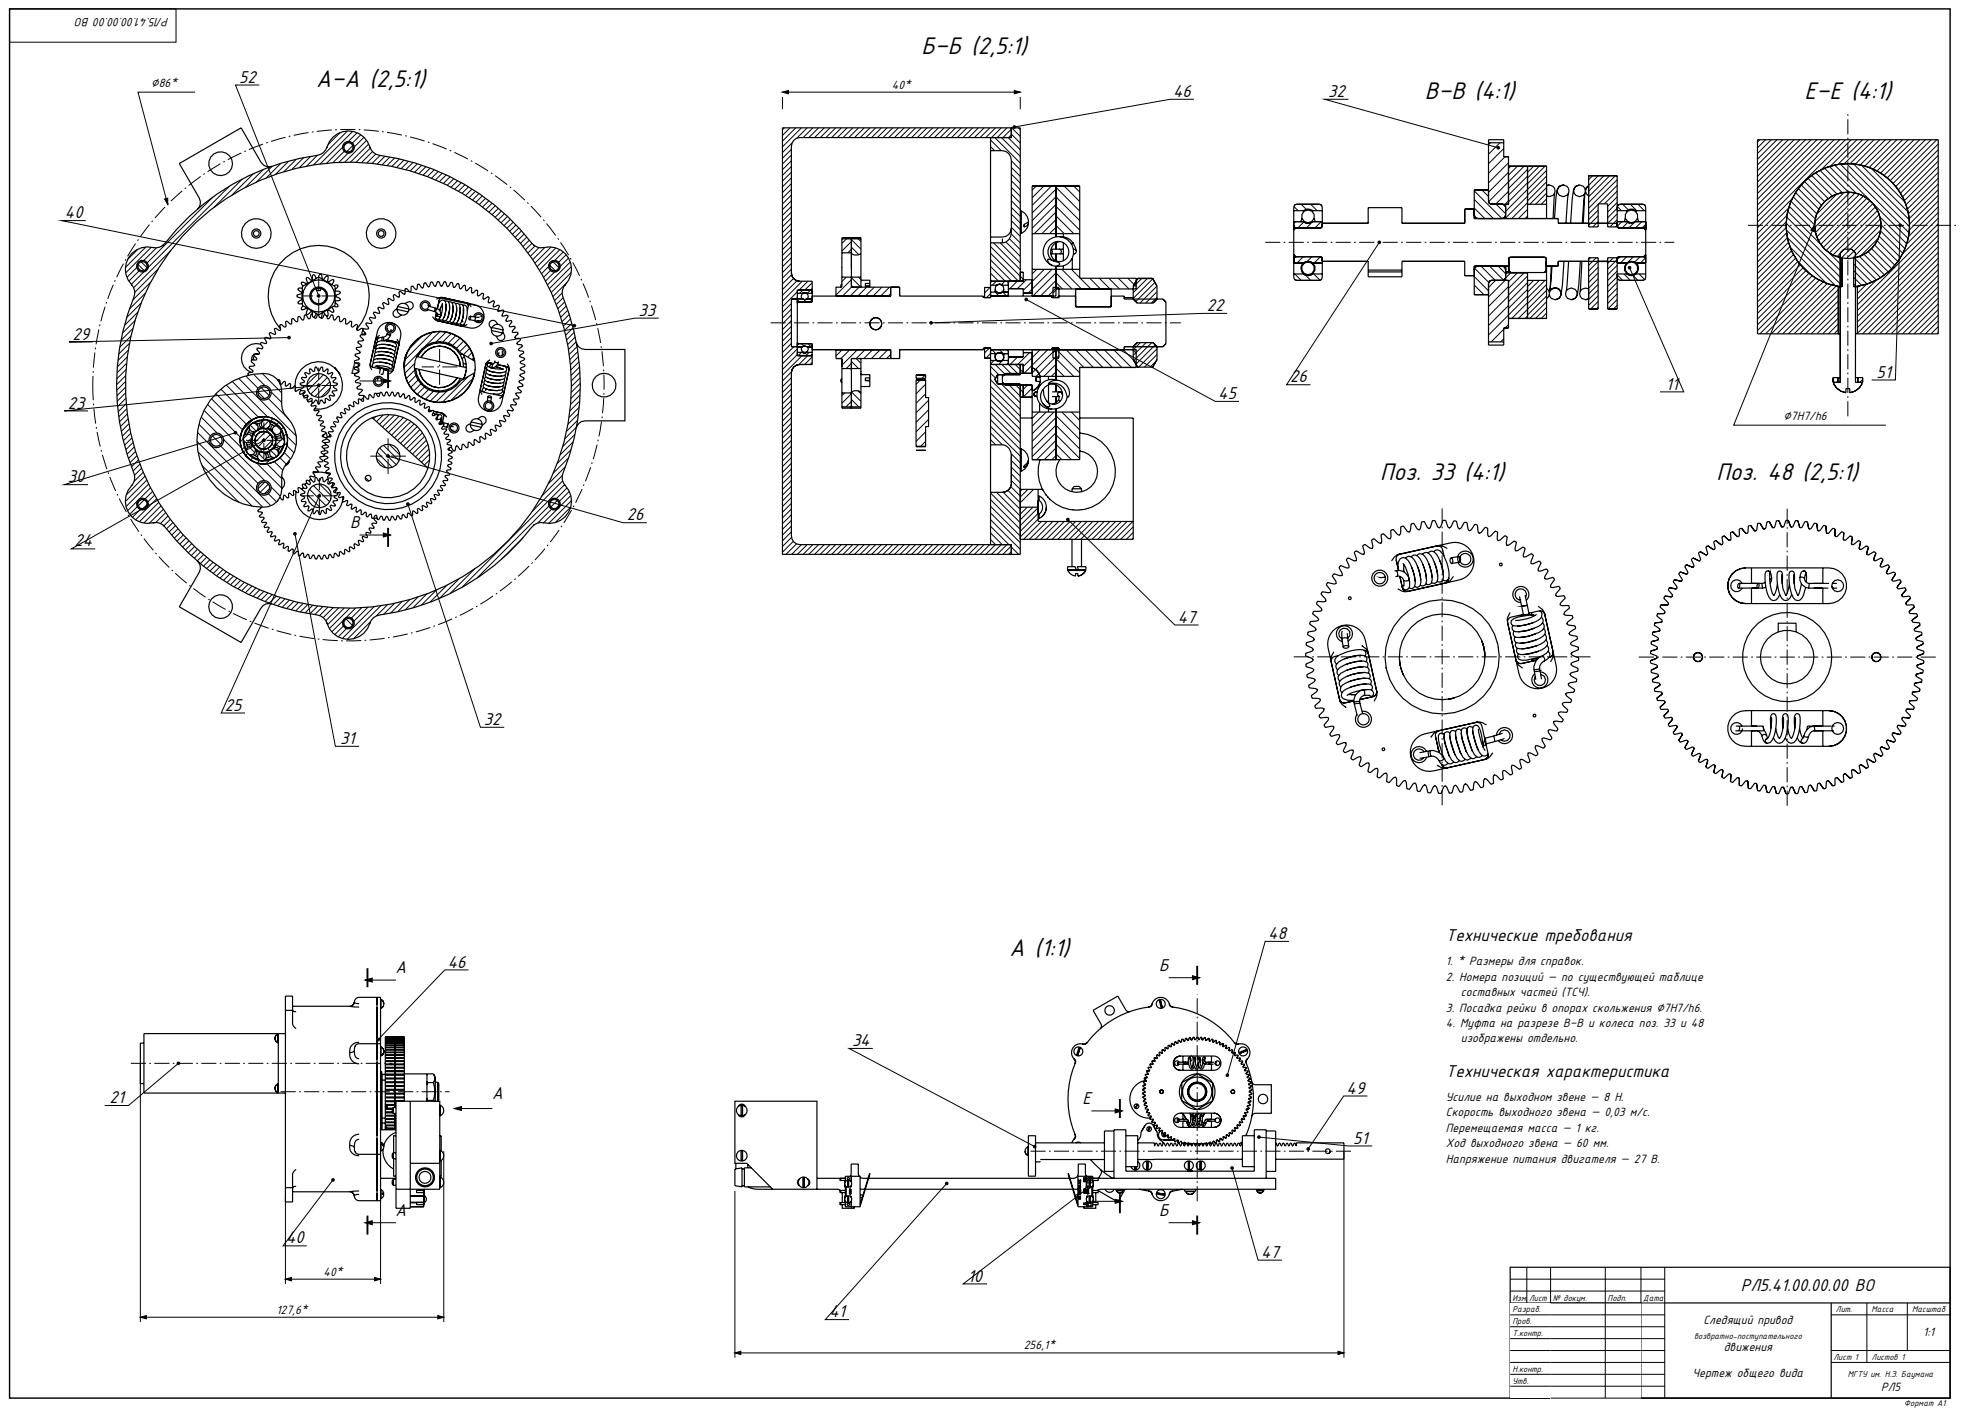
[picture p69: page 1]
Поз. 33 (4:1); Поз. 48 (2,5:1); Технические требования; Техническая характеристика; Следящий привод; возвратно‐поступательного движения; Лит.; Масса; Масштаб; Лист 1; Листов 1; Изм. Лист; № докум.; Подп.; Дата; Разраб.; Пров.; Т.контр.; Н.контр. Утв.; Формат А1

1. * Размеры для справок.
2. Номера позиций — по существующей таблице
составных частей (ТСЧ).
3. Посадка рейки в опорах скольжения ⌀7H7/h6.
4. Муфта на разрезе В–В и колеса поз. 33 и 48
изображены отдельно.

Усилие на выходном звене — 8 Н.
Скорость выходного звена — 0,03 м/с.
Перемещаемая масса — 1 кг.
Ход выходного звена — 60 мм.
Напряжение питания двигателя — 27 В.

Чертеж общего вида

МГТУ им. Н.Э. Баумана
