BogoslavskiM/okp/Проверка_ОКП/PDF_до_возврата_названия/Структурная_схема_исправленная.pdf

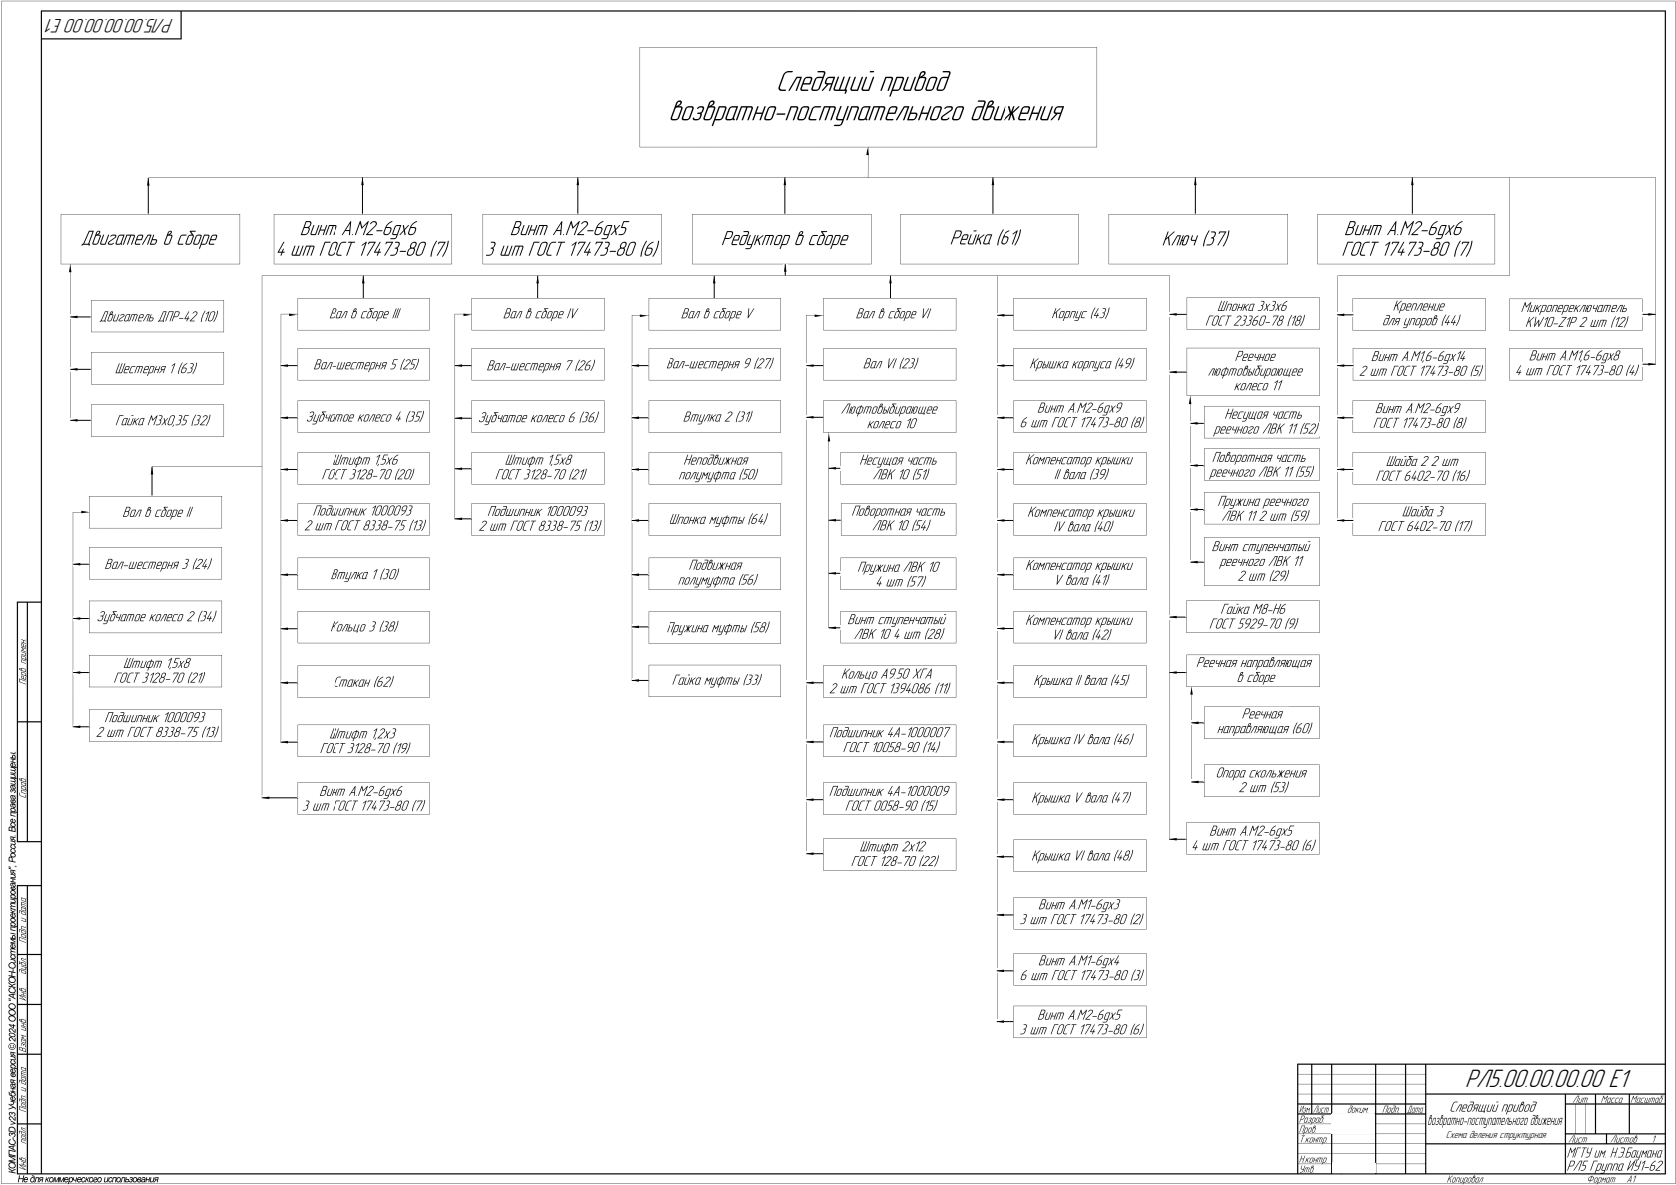
[picture p70: page 1]

Схема деления структурная
