BogoslavskiM/okp/Проверка_ОКП/PDF_до_возврата_обозначений_41/Структурная_схема_исправленная.pdf

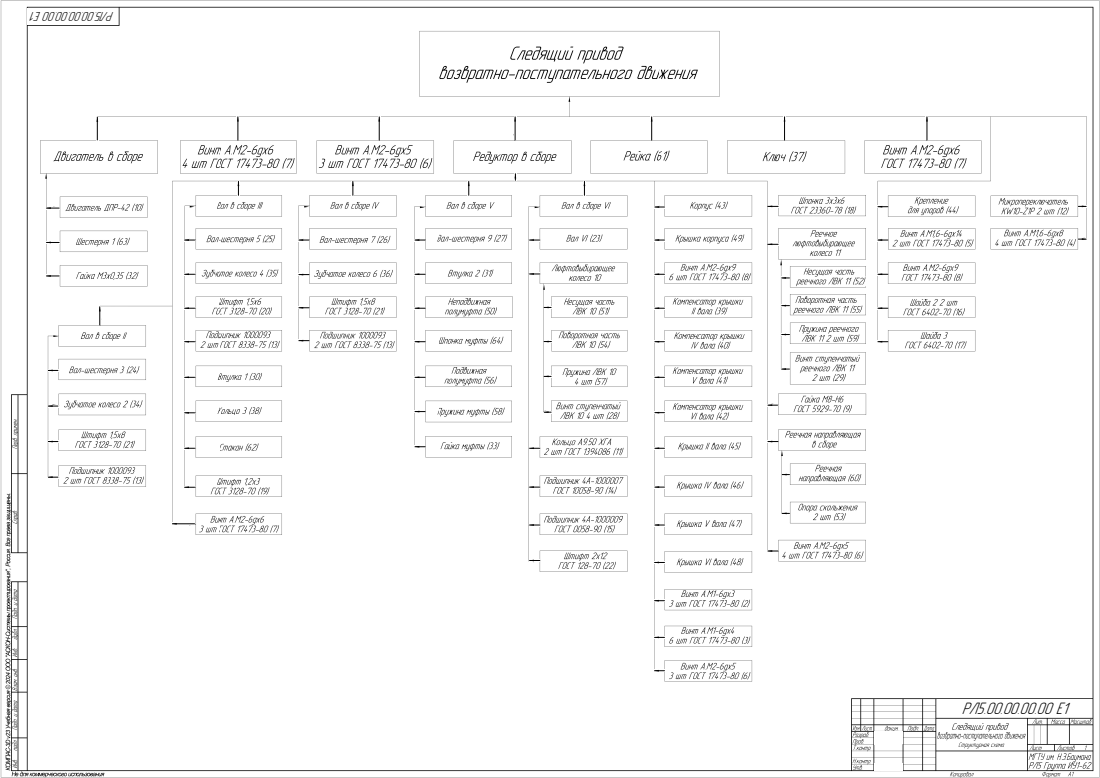
[picture p71: page 1]
