BogoslavskiM/okp/Проверка_ОКП/PDF_до_правки_шрифтов/Структурная_схема_исправленная.pdf

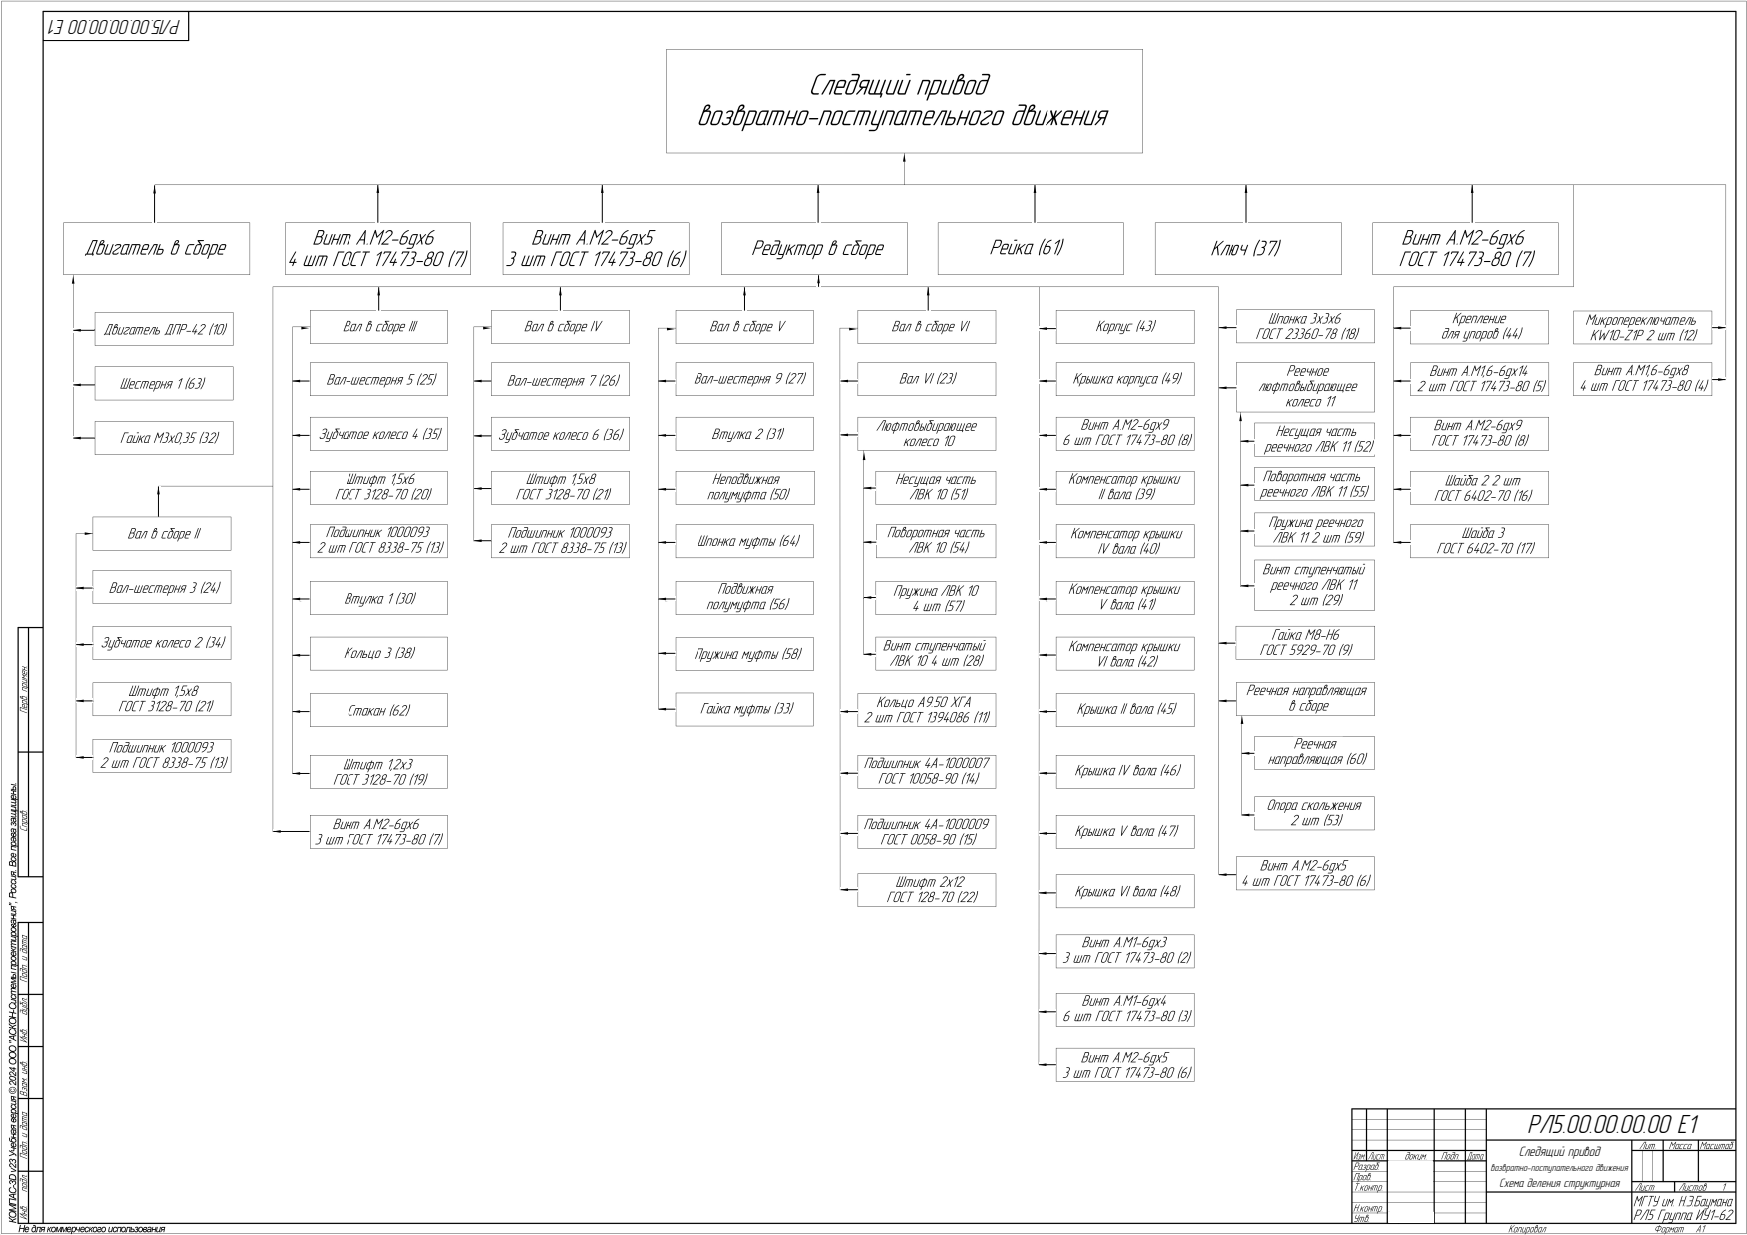
[picture p72: page 1]

Следящий привод
возвратно-поступательного движения
Схема деления структурная
