BogoslavskiM/okp/(commit log)

2026-09-14 Добавить итоговый комплект чертежей
2026-09-14 Исправить прямой экспорт PDF и схему Е1
2026-09-14 Завершить нативный комплект чертежей КОМПАС
2026-09-15 Обновить ручные правки чертежей и PDF
2026-09-16 Добавить модельно-связанные чертежи КОМПАС
2026-09-17 Исправить посадки ВО и очистить итоговый комплект
2026-09-19 Правила оформления чертежей
2026-09-19 init, stp, kinemat, struct_sheme
2026-09-21 Finalize drive assembly drawing and specification with native PDF export
2026-09-21 Add reducer assembly drawing and specification with native PDF exports
2026-09-28 Добавить чертёж стакана
2026-09-28 Добавить итоговый чертёж выходного вала и PDF
2026-09-28 Add dimensioned housing drawing and native PDF export
